TommyPersson/modular-keypads/pcb/module-c/smc-1-r1/production/bom.csv

Designator | Footprint | Quantity | Value | LCSC Part #
C1, C2 | 0603 | 2 | 0.1
C3 | 0603 | 1 | 0.1 uF
J1, J3 | PinHeader_1x06_P2.54mm_Vertical | 2 | Conn_01x06
LED1, LED2, LED3, LED4, LED5, LED6 | LED_choc_6028R-ROT | 6 | SK6812MINI-E
SW1, SW2, SW3, SW4, SW5, SW6 | SW_Hotswap_Kailh_Choc_V1_1.00u | 6 | SW_Push
U1 | SOT-353_SC-70-5 | 1 | 74AHCT1G125
U2 | QFN-24-1EP_4x4mm_P0.5mm_EP2.6x2.6mm | 1 | ATtiny1616-M
U3 | DHVQFN-16-1EP_2.5x3.5mm_P0.5mm_EP1x2mm | 1 | 74HC165
