TommyPersson/modular-keypads/pcb/module-c/main-board-r1/module-c1.stl

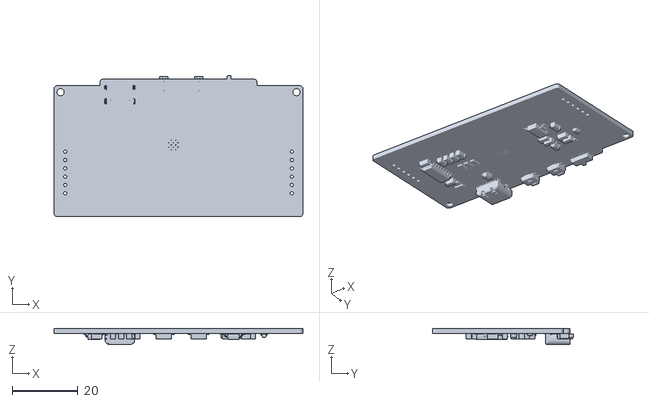
[picture p1: CAD file, 2026-07-26]
pcb/module-c/main-board-r1/module-c1.stl
76.0 x 43.2 x 4.91
