TommyPersson/modular-keypads/scad/module-0/module-0-top.stl

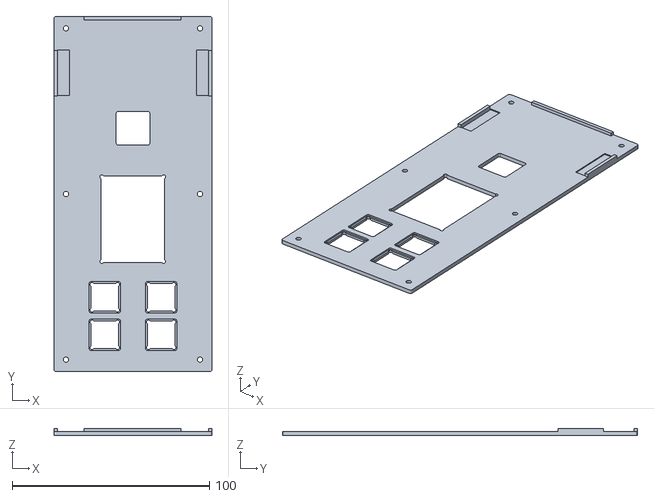
[picture p2: CAD file, 2025-09-28]
scad/module-0/module-0-top.stl
80.0 x 180.0 x 3.60
