TommyPersson/modular-keypads/scad/module-rack/module-rack-2.3mf

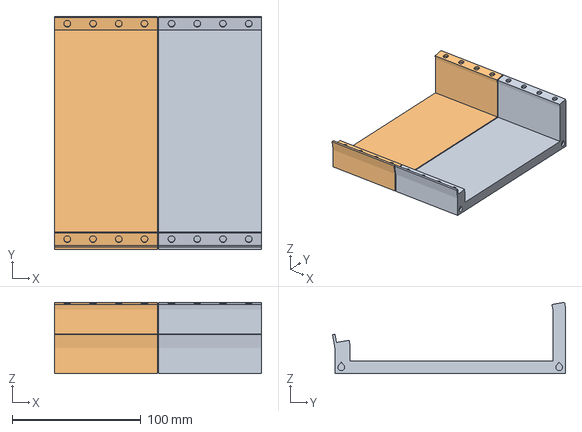
[picture p3: CAD file, 2025-09-14]
scad/module-rack/module-rack-2.3mf
161.0 x 181.1 x 55.5 mm
module-rack-2.scad.stl.bhSaWD.stl x 2
