TommyPersson/modular-keypads/scad/module-0/lcd_spacer.stl

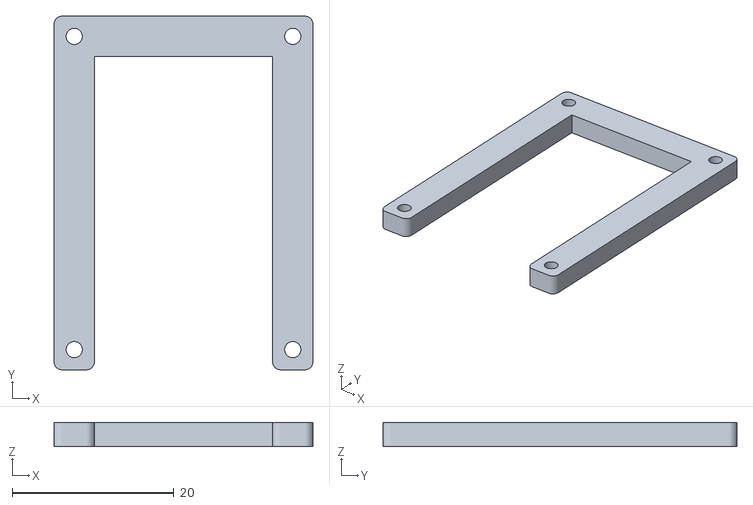
[picture p4: CAD file, 2025-09-28]
scad/module-0/lcd_spacer.stl
32.0 x 43.7 x 3.00
