TommyPersson/modular-keypads/scad/misc/encoders/shared-variables.scad

encoder_cover_diameter = 37;
encoder_cover_height = 2;
encoder_cover_inset = 2;
