TommyPersson/modular-keypads/scad/module-0/_variables.scad

lcd_safety = 0.5;
lcd_size = [32, 43.7];
