TommyPersson/modular-keypads/scad/module-c/module-c-bottom.scad

use <../common/module-bottom-routines.scad>
use <../common/shared-utils.scad>
include <./shared-variables.scad>

base();

module base() {
    module_bottom_base(4);
}
