TommyPersson/modular-keypads/scad/module-c/shared-variables.scad

include <../common/shared-variables.scad>

screw_hole_inset_pcb = 2;
screw_hole_inset = screw_hole_inset_pcb + outer_wall_thickness_base;
