TommyPersson/modular-keypads/(list of files, cad)

Other CAD files:
scad/misc/module-top-standin.scad
scad/module-0/module-0-bottom.scad
scad/module-a/module-a-top.scad
scad/module-b/module-b-bottom.scad
scad/module-c/module-c-mockups.scad
scad/module-rack/module-rack.scad
scad/pipe-mount-rack/pipe-module-rack.scad
