TommyPersson/modular-keypads/pcb/module-c/main-board-r2/module-c2.kicad_pcb

## KiCad design pcb/module-c/main-board-r2/module-c2.kicad_pcb (2026-11-07)

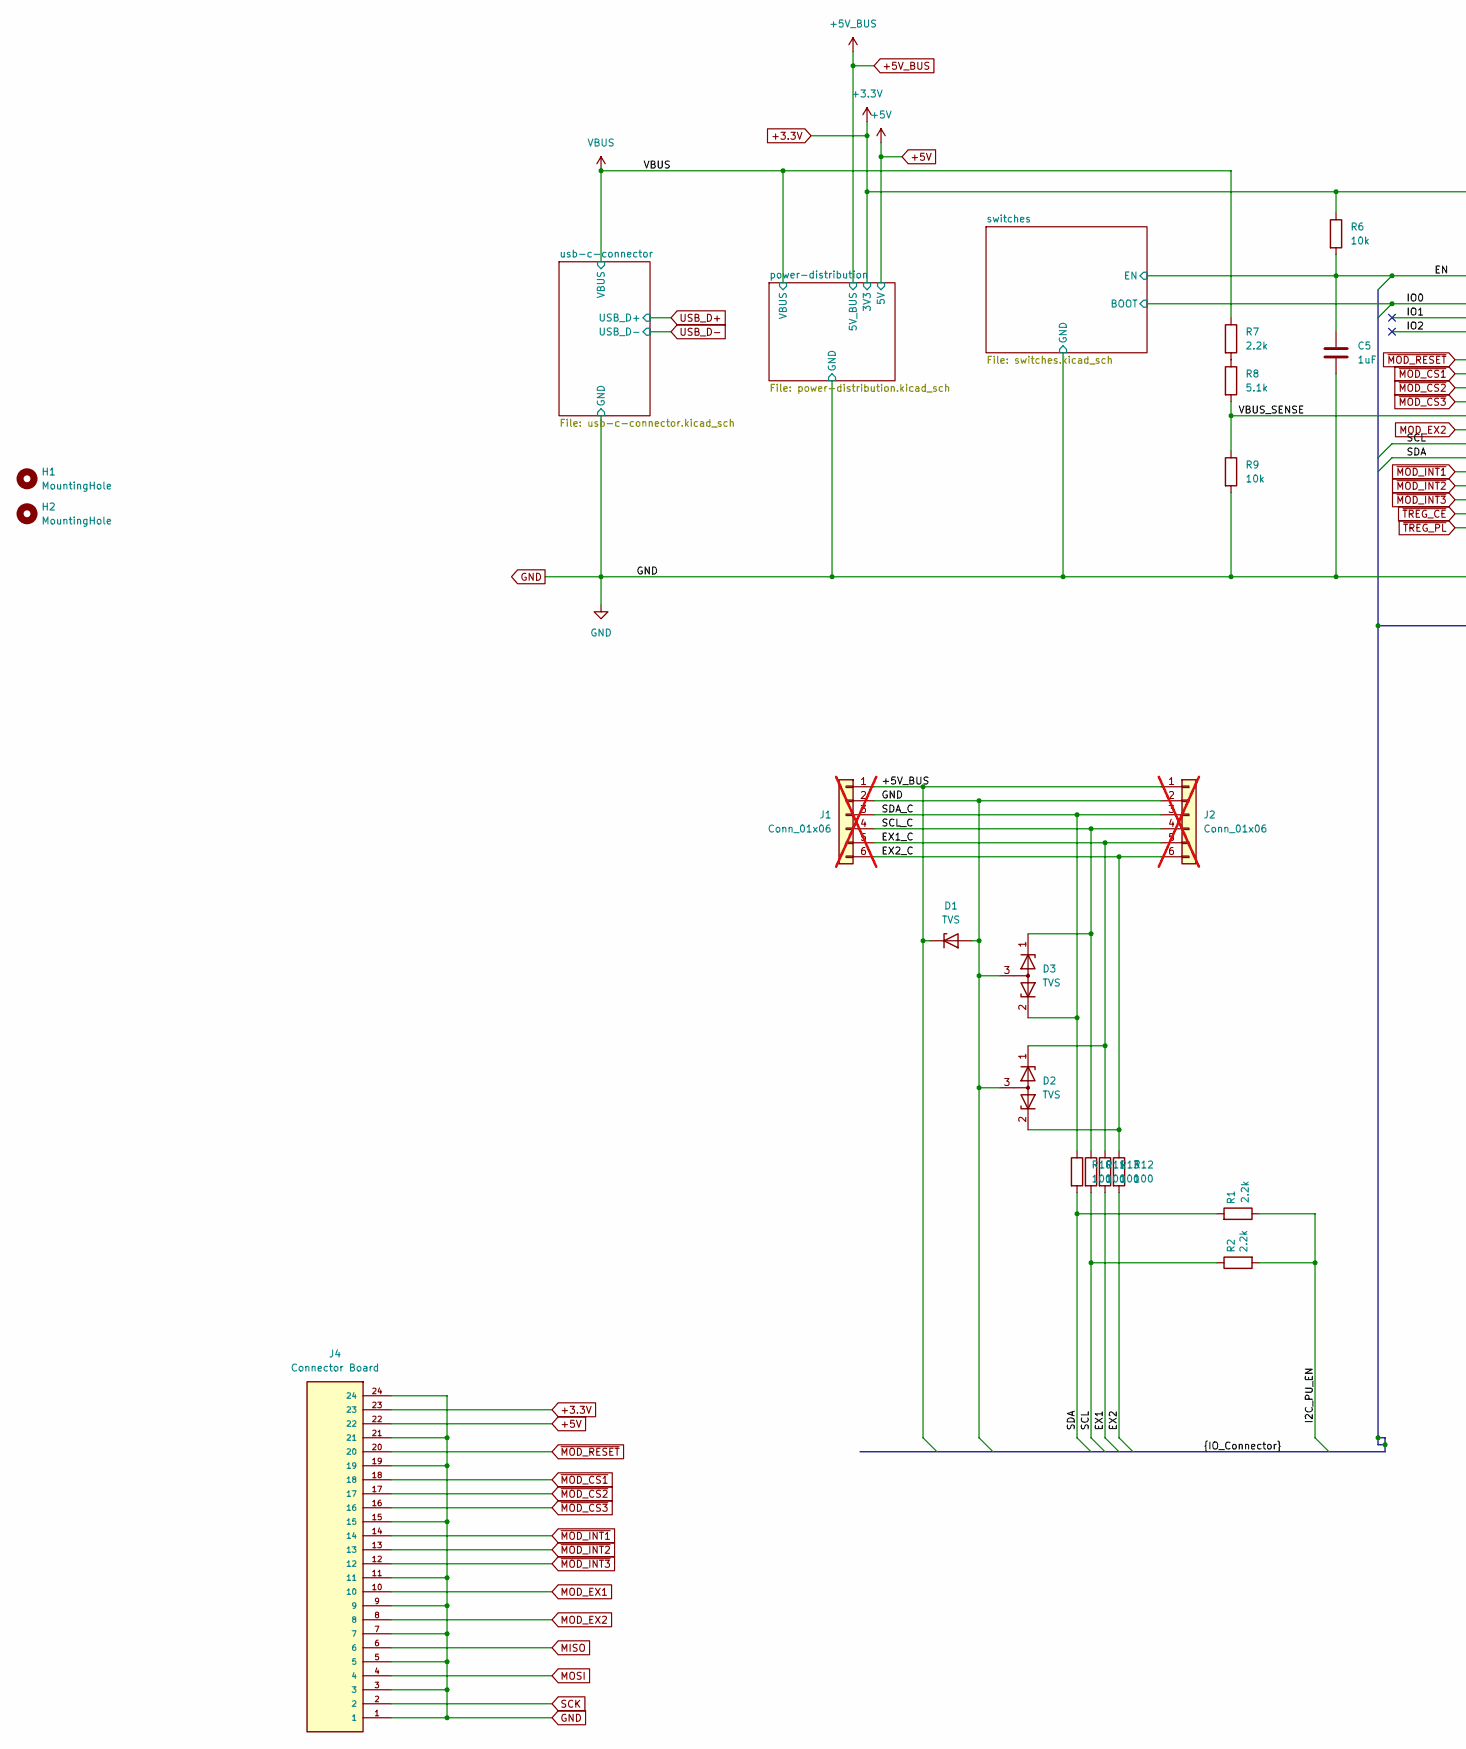
[picture p5: schematic module-c2.kicad_sch, part in row 1, column 1]

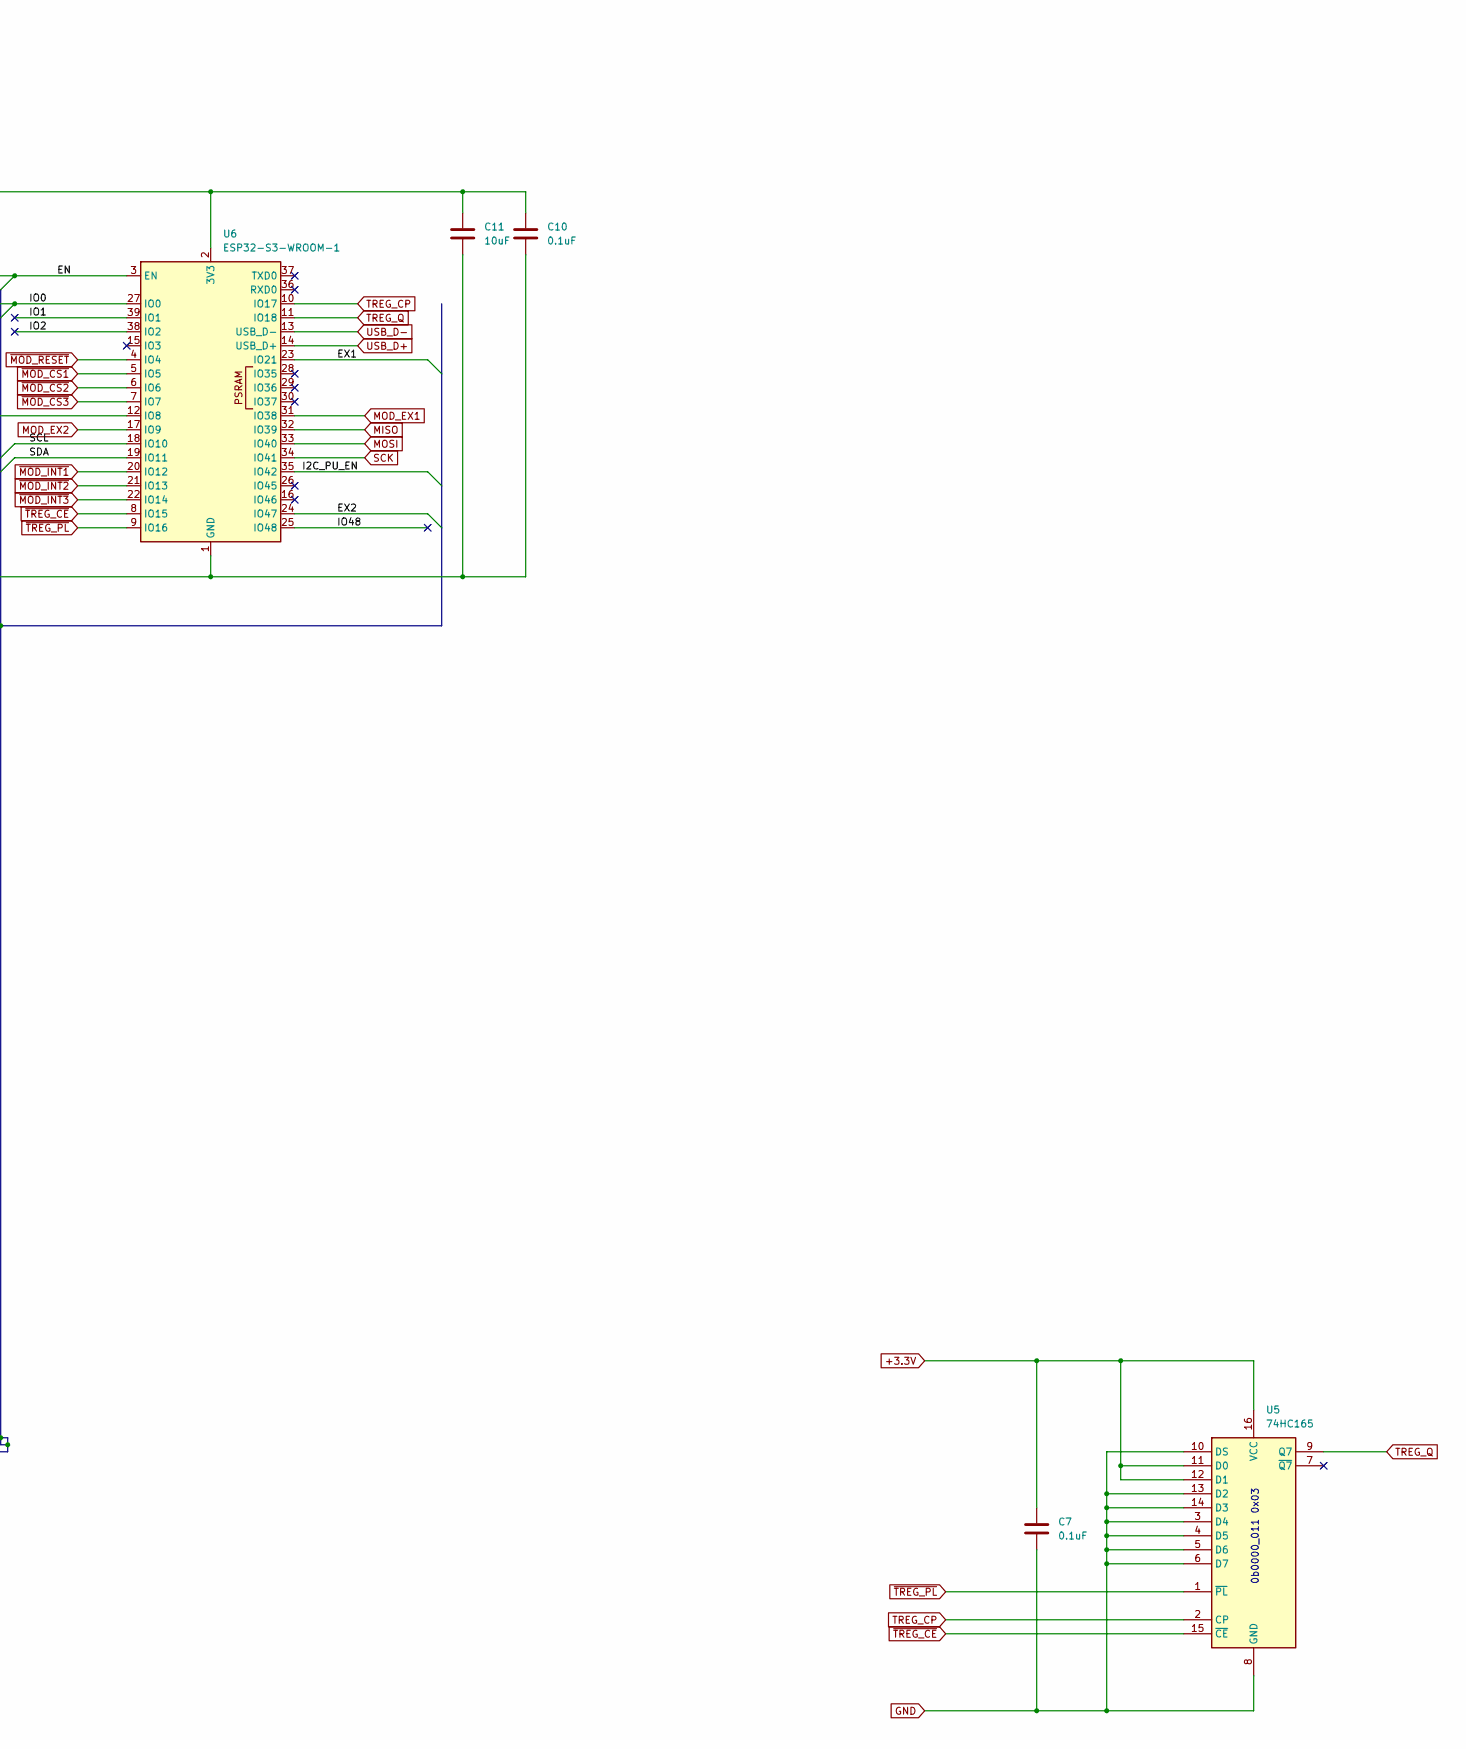
[picture p6: schematic module-c2.kicad_sch, part in row 1, column 2]

Parts:
C5: 1uF; C_0805_2012Metric
C7, C10: 0.1uF; C_0603_1608Metric
C11: 10uF; C_0805_2012Metric
D1: TVS; Nexperia_CFP3_SOD-123W
D2, D3: TVS; SOT-723
H1, H2: MountingHole; MountingHole_2.2mm_M2
J1: Conn_01x06; PinSocket_1x06_P2.54mm_MagPogoHor_R; not fitted
J2: Conn_01x06; PinSocket_1x06_P2.54mm_MagPogoHor; not fitted
J4: Connector Board; AMPHENOL_F3311A7H121024E200; PARTREV A
R1, R2, R7: 2.2k; R_0603_1608Metric
R6, R9: 10k; R_0603_1608Metric
R8: 5.1k; R_0603_1608Metric
R10, R11, R12, R13: 100; R_0603_1608Metric
U5: 74HC165; DHVQFN-16-1EP_2.5x3.5mm_P0.5mm_EP1x2mm
U6: ESP32-S3-WROOM-1; ESP32-S3-WROOM-1U

Connections:
+3.3V: C7.1, C10.1, C11.1, J4.23, R6.1, U5.11 (D0), U5.12 (D1), U5.16 (VCC), U6.2 (3V3); also elsewhere on the board
+5V: J4.22; also elsewhere on the board
+5V_BUS: D1.1 (K), J1.1, J2.1; also elsewhere on the board
/EN: C5.1, R6.2, U6.3 (EN); also elsewhere on the board
/EX1: R13.2, U6.23 (IO21)
/EX1_C: D2.1 (K), J1.5, J2.5, R13.1
/EX2: R12.2, U6.24 (IO47)
/EX2_C: D2.2 (K), J1.6, J2.6, R12.1
/I2C_PU_EN: R1.1, R2.2, U6.35 (IO42)
/IO0: U6.27 (IO0); also elsewhere on the board
/IO1: U6.39 (IO1)
/IO2: U6.38 (IO2)
/IO48: U6.25 (IO48)
/SCL: R2.1, R11.2, U6.18 (IO10)
/SCL_C: D3.1 (K), J1.4, J2.4, R11.1
/SDA: R1.2, R10.2, U6.19 (IO11)
/SDA_C: D3.2 (K), J1.3, J2.3, R10.1
/VBUS_SENSE: R8.2, R9.1, U6.12 (IO8)
GND: C5.2, C7.2, C10.2, C11.2, D1.2 (A), D2.3 (A), D3.3 (A), J1.2, J2.2, J4.1, J4.3, J4.5, J4.7, J4.9, J4.11, J4.15, J4.19, J4.21, J4.24, R9.2, U5.3 (D4), U5.4 (D5), U5.5 (D6), U5.6 (D7), U5.8 (GND), U5.10 (DS), U5.13 (D2), U5.14 (D3), U6.1 (GND), U6.40 (GND), U6.41 (GND); also elsewhere on the board
MISO: J4.6, U6.32 (IO39)
MOD_EX1: J4.10, U6.31 (IO38)
MOD_EX2: J4.8, U6.17 (IO9)
MOSI: J4.4, U6.33 (IO40)
unnamed: R7.2, R8.1
SCK: J4.2, U6.34 (IO41)
TREG_CP: U5.2 (CP), U6.10 (IO17)
TREG_Q: U5.9 (Q7), U6.11 (IO18)
USB_D+: U6.14 (USB_D+); also elsewhere on the board
USB_D-: U6.13 (USB_D-); also elsewhere on the board
VBUS: R7.1; also elsewhere on the board
~MOD_CS1: J4.18, U6.5 (IO5)
~MOD_CS2: J4.17, U6.6 (IO6)
~MOD_CS3: J4.16, U6.7 (IO7)
~MOD_INT1: J4.14, U6.20 (IO12)
~MOD_INT2: J4.13, U6.21 (IO13)
~MOD_INT3: J4.12, U6.22 (IO14)
~MOD_RESET: J4.20, U6.4 (IO4)
~TREG_CE: U5.15 (~CE), U6.8 (IO15)
~TREG_PL: U5.1 (~PL), U6.9 (IO16)

Notes on the sheet:
0b0000_011 0x03

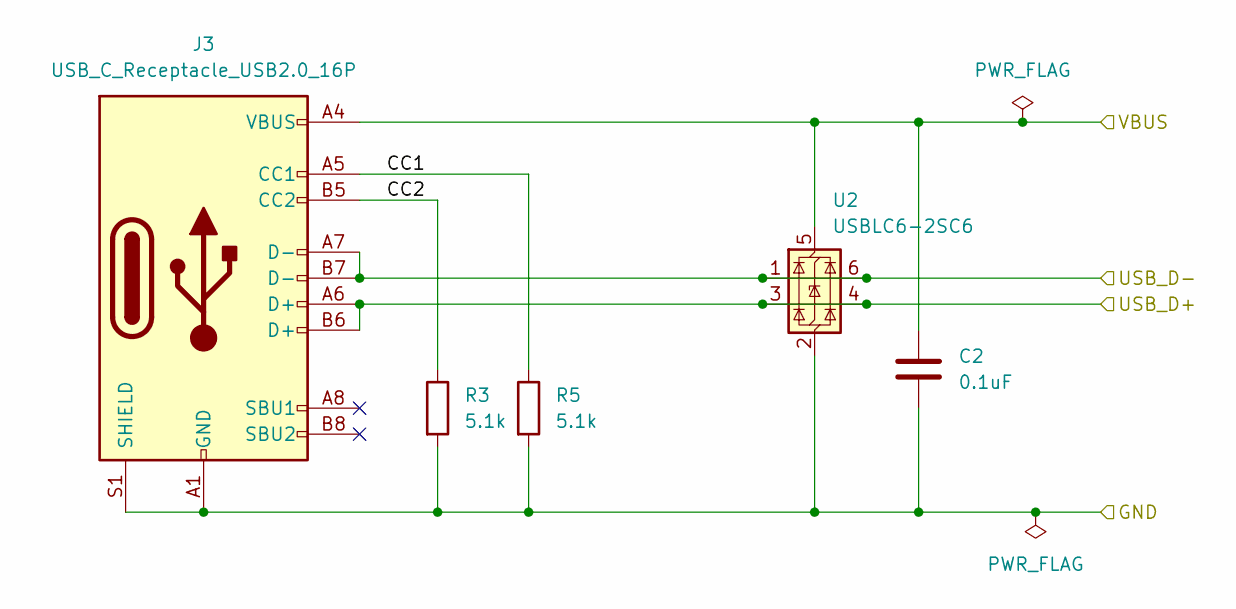
[picture p7: schematic usb-c-connector.kicad_sch]

Parts:
C2: 0.1uF; C_0603_1608Metric
J3: USB_C_Receptacle_USB2.0_16P; USB_C_Receptacle_GCT_USB4105-xx-A_16P_TopMnt_Horizontal
R3, R5: 5.1k; R_0603_1608Metric
U2: USBLC6-2SC6; SOT-23-6_Handsoldering

Connections:
/usb-c-connector/CC1: J3.A5 (CC1), R5.1
/usb-c-connector/CC2: J3.B5 (CC2), R3.1
GND: C2.2, J3.A1 (GND), J3.A12 (GND), J3.B1 (GND), J3.B12 (GND), J3.S1 (SHIELD), R3.2, R5.2, U2.2 (GND); also elsewhere on the board
USB_D+: J3.A6 (D+), J3.B6 (D+), U2.3 (I/O2), U2.4 (I/O2); also elsewhere on the board
USB_D-: J3.A7 (D-), J3.B7 (D-), U2.1 (I/O1), U2.6 (I/O1); also elsewhere on the board
VBUS: C2.1, J3.A4 (VBUS), J3.A9 (VBUS), J3.B4 (VBUS), J3.B9 (VBUS), U2.5 (VBUS); also elsewhere on the board

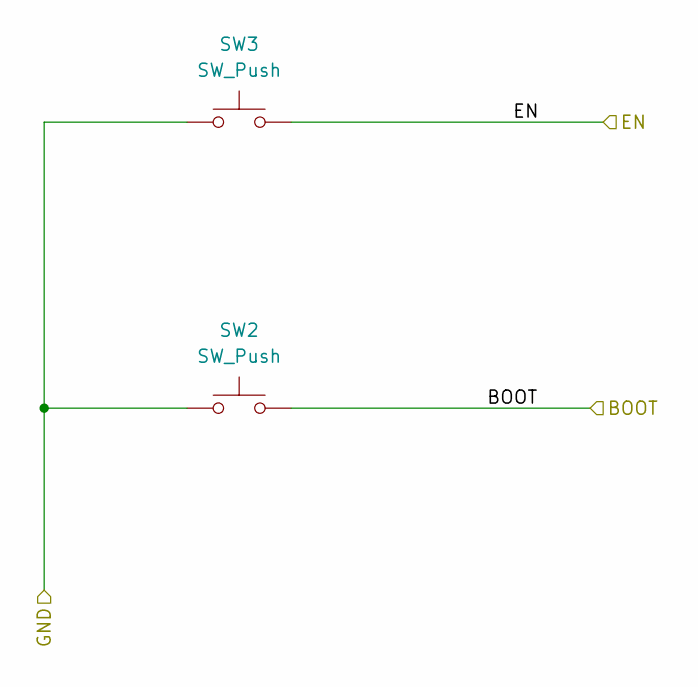
[picture p8: schematic switches.kicad_sch]

Parts:
SW2, SW3: SW_Push; Panasonic_EVQPUL_EVQPUC

Connections:
/EN: SW3.2; also elsewhere on the board
/IO0: SW2.2; also elsewhere on the board
GND: SW2.1, SW3.1; also elsewhere on the board

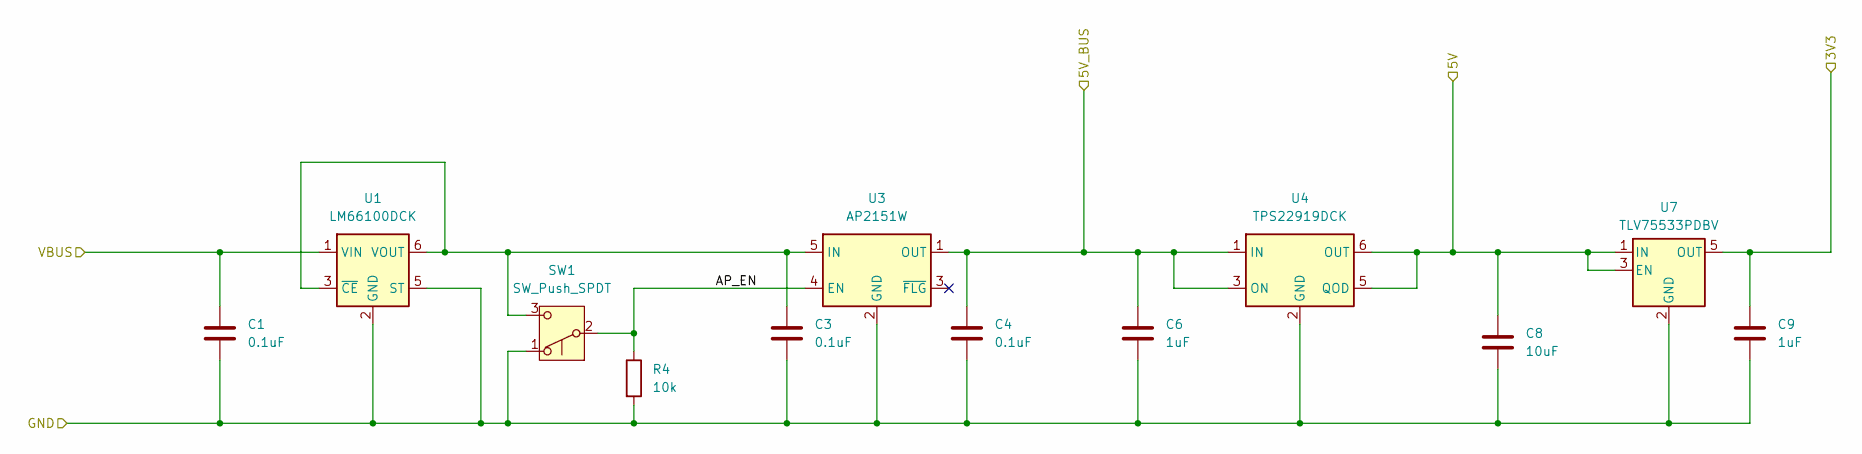
[picture p9: schematic power-distribution.kicad_sch]

Parts:
C1, C3, C4: 0.1uF; C_0603_1608Metric
C6, C9: 1uF; C_0805_2012Metric
C8: 10uF; C_0805_2012Metric
R4: 10k; R_0603_1608Metric
SW1: SW_Push_SPDT; SW_MSK12C02-HB
U1: LM66100DCK; SOT-363_SC-70-6
U3: AP2151W; SOT-23-5_HandSoldering
U4: TPS22919DCK; SOT-363_SC-70-6
U7: TLV75533PDBV; SOT-23-5

Connections:
+3.3V: C9.1, U7.5 (OUT); also elsewhere on the board
+5V: C8.1, U4.5 (QOD), U4.6 (OUT), U7.1 (IN), U7.3 (EN); also elsewhere on the board
+5V_BUS: C4.1, C6.1, U3.1 (OUT), U4.1 (IN), U4.3 (ON); also elsewhere on the board
/power-distribution/AP_EN: R4.1, SW1.2 (B), U3.4 (EN)
GND: C1.2, C3.2, C4.2, C6.2, C8.2, C9.2, R4.2, SW1.1 (A), U1.2 (GND), U1.5 (ST), U3.2 (GND), U4.2 (GND), U7.2 (GND); also elsewhere on the board
unnamed: C3.1, SW1.3 (C), U1.3 (~CE), U1.6 (VOUT), U3.5 (IN)
VBUS: C1.1, U1.1 (VIN); also elsewhere on the board

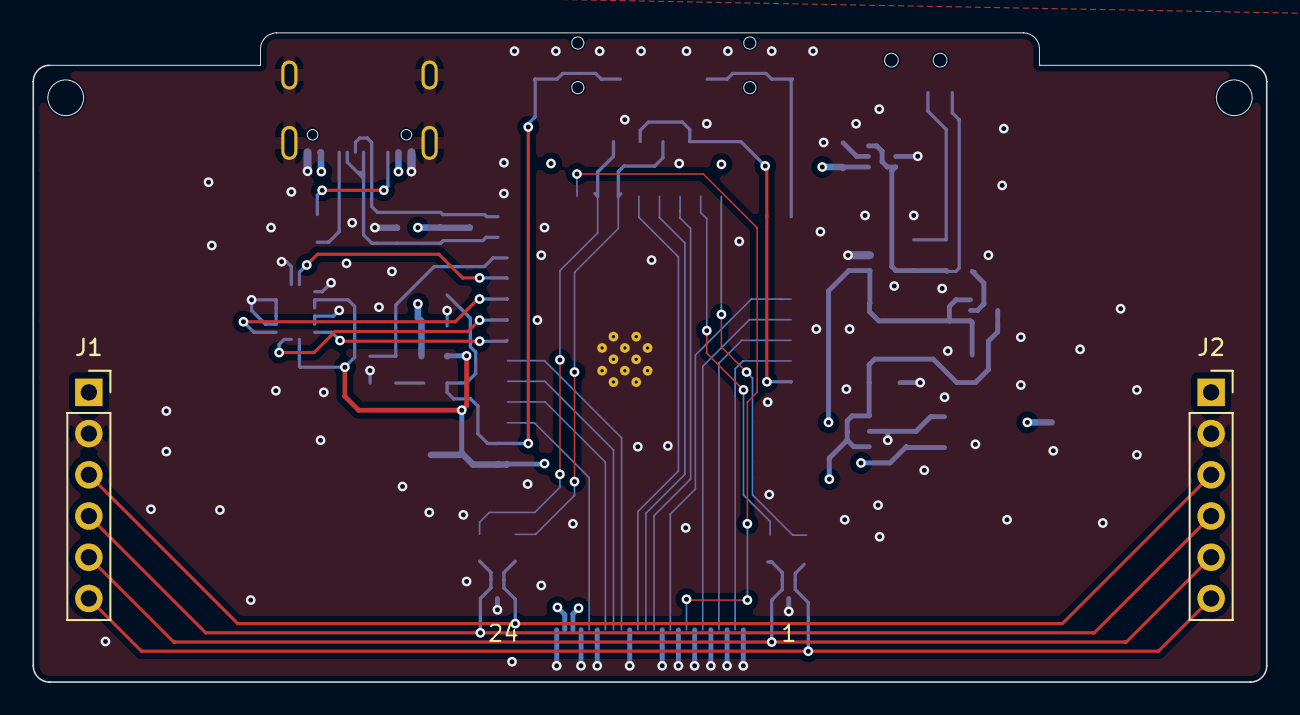
[picture p10: board module-c2.kicad_pcb from above]

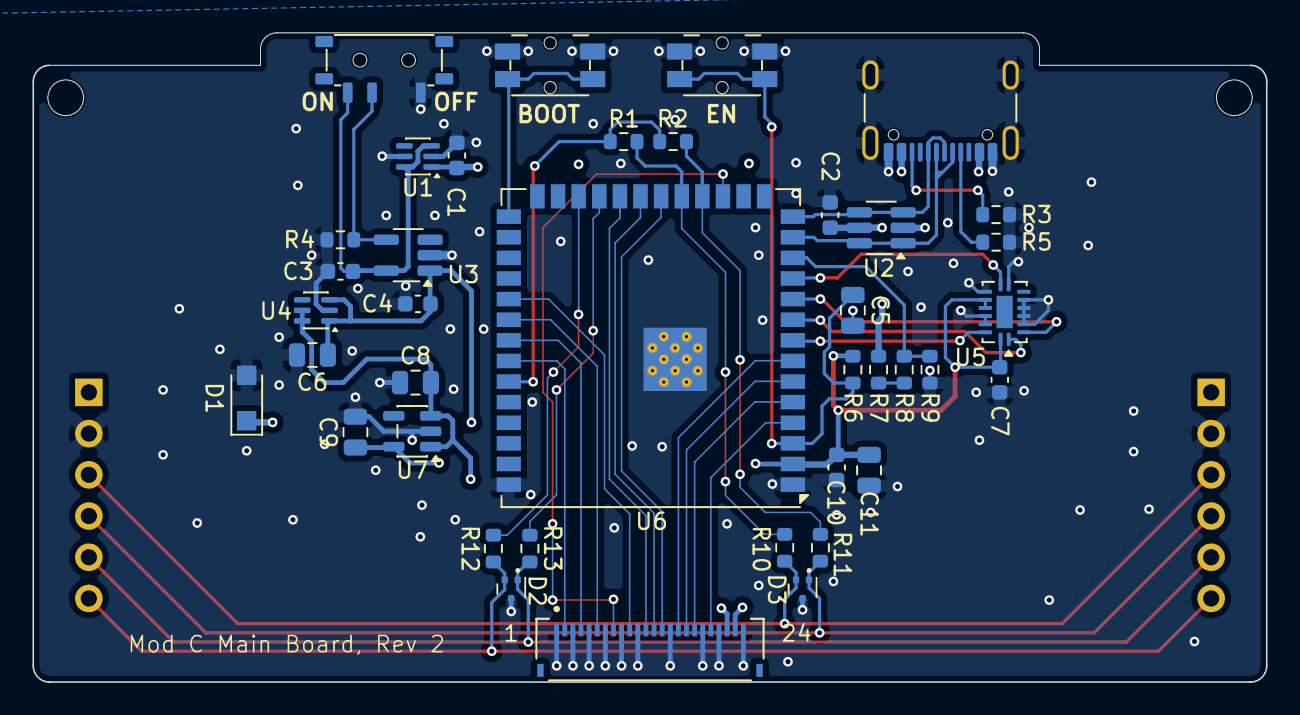
[picture p11: board module-c2.kicad_pcb from below]

Board: 4 copper layers, 76.0 x 40.0 mm, 43 parts (39 on the bottom side), 40 nets.
