TommyPersson/modular-keypads/pcb/module-c/smc-1-r2/smc-1.kicad_pcb

## KiCad design pcb/module-c/smc-1-r2/smc-1.kicad_pcb (2026-09-13)

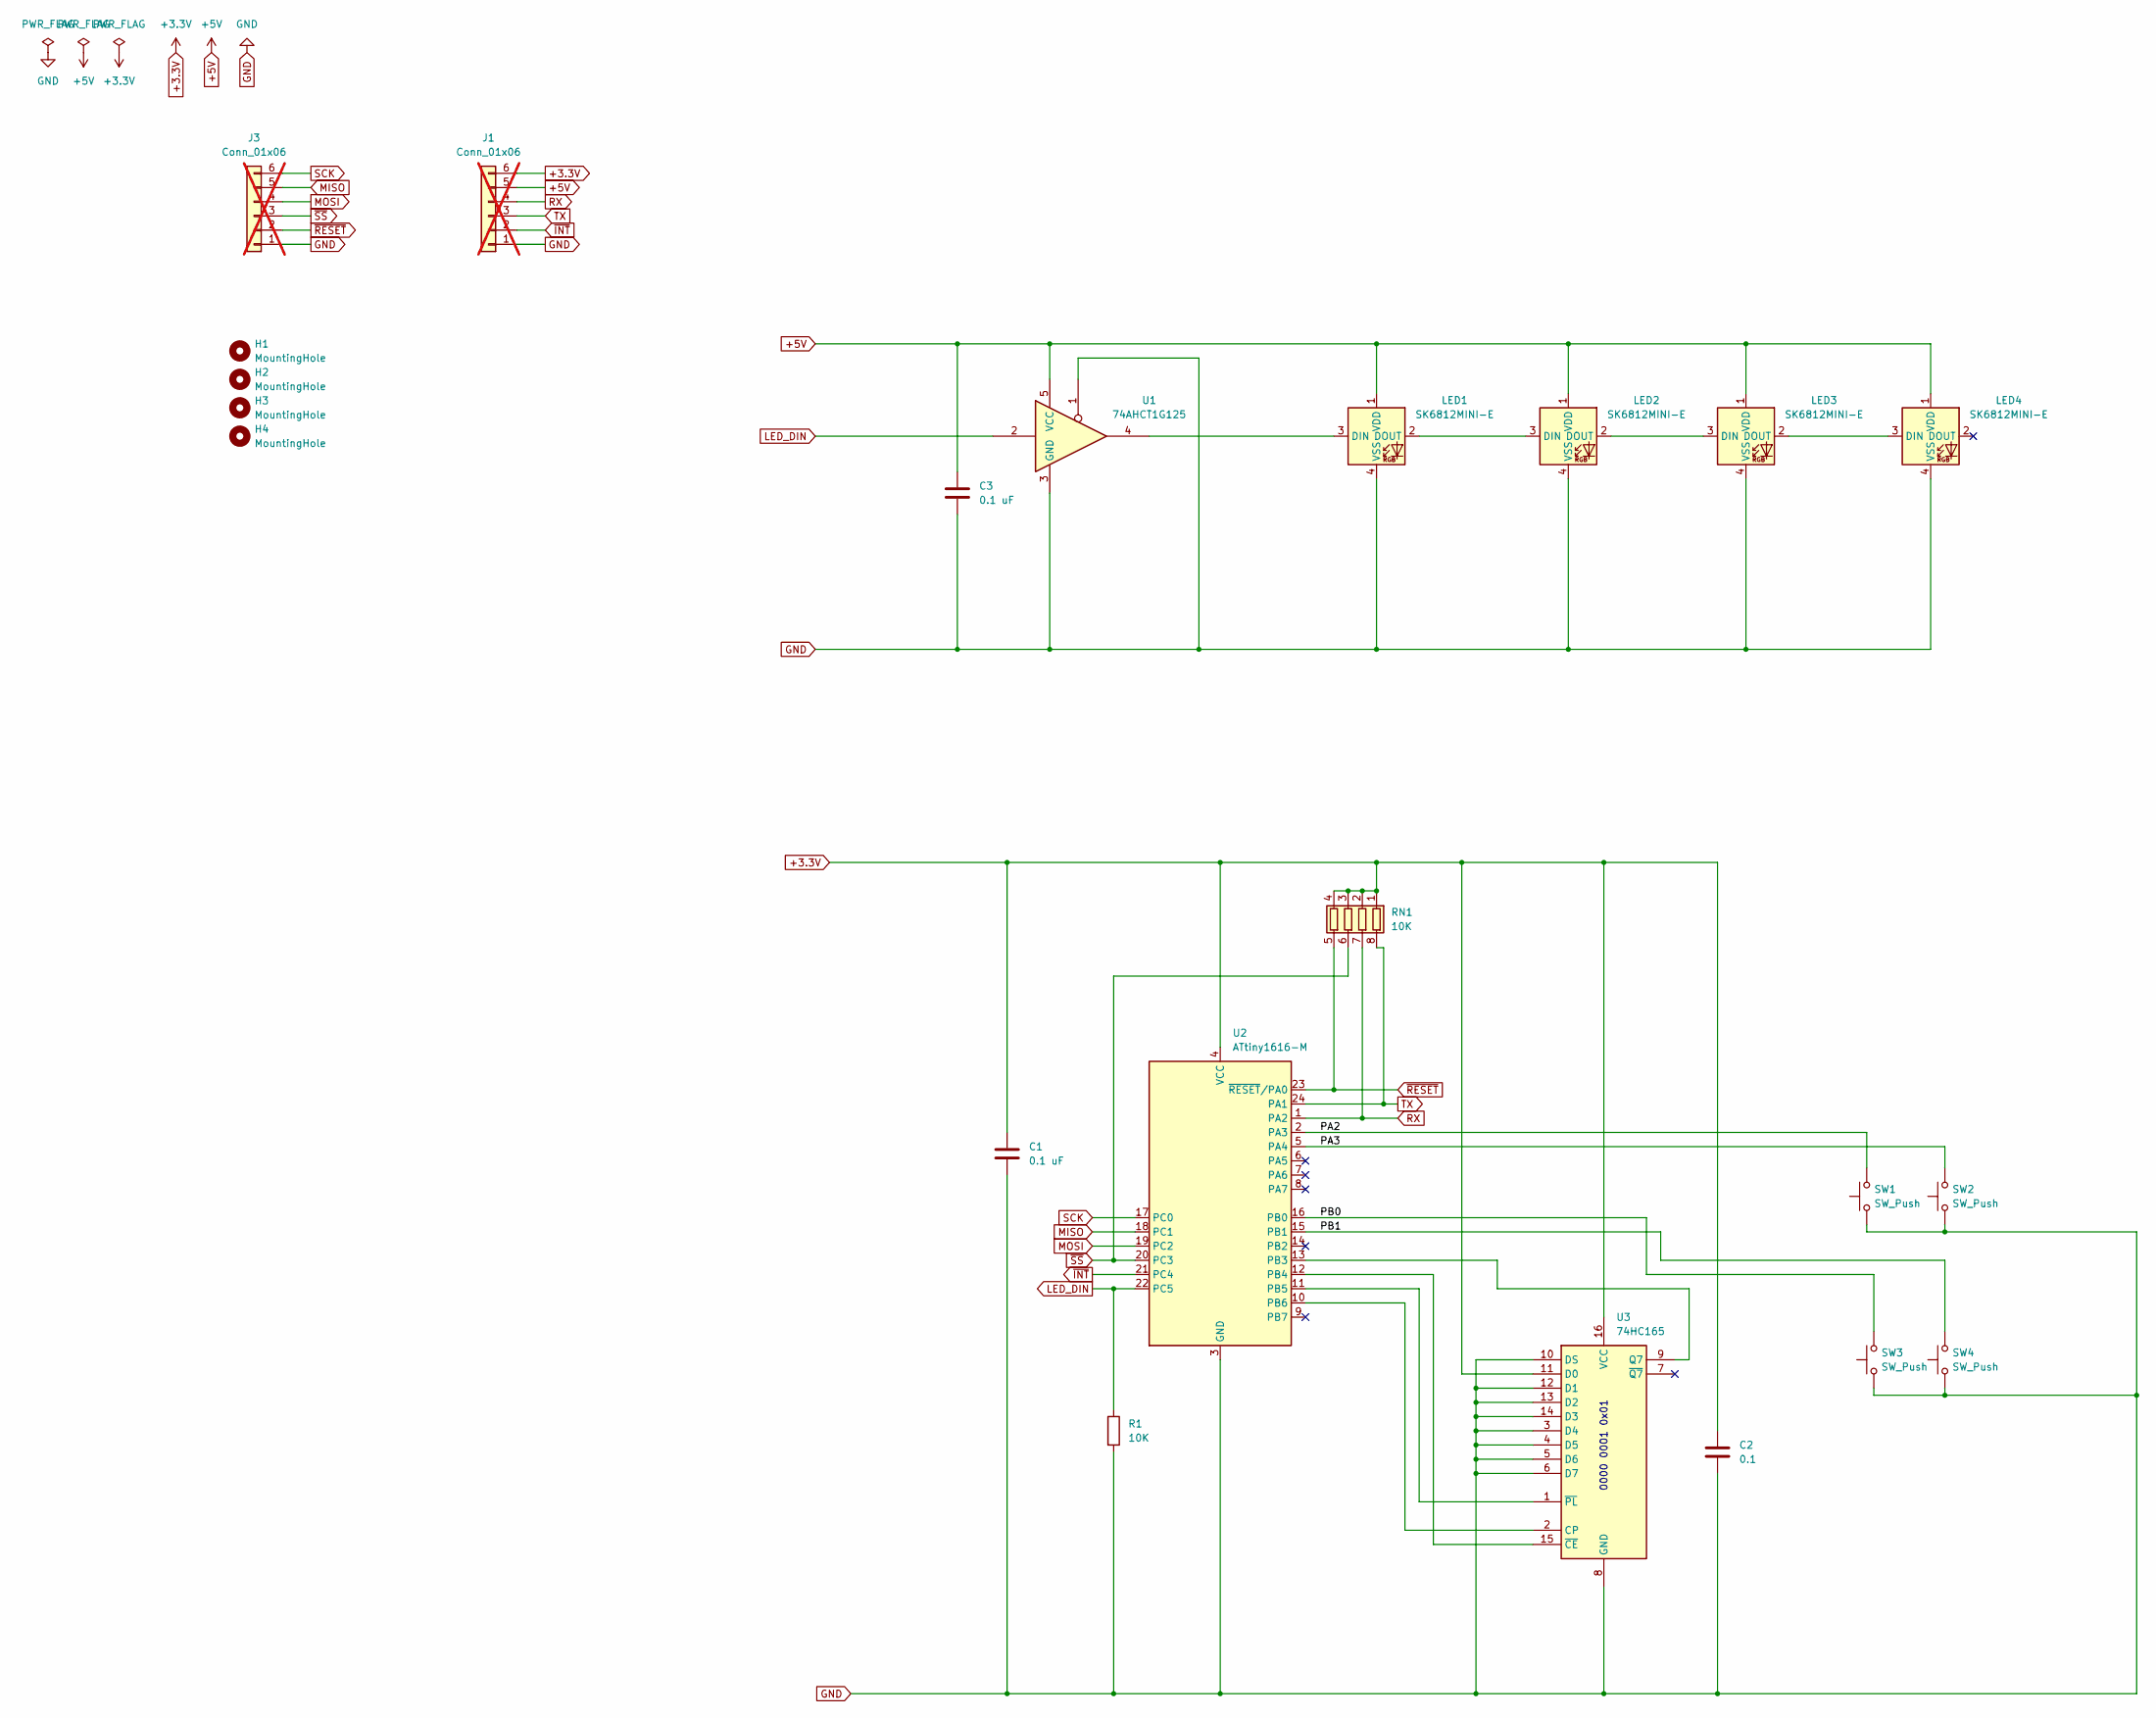
[picture p12: schematic smc-1.kicad_sch]

Parts:
C1, C3: 0.1 uF; C_0603_1608Metric
C2: 0.1; C_0603_1608Metric
H1, H2, H3, H4: MountingHole; MountingHole_2.2mm_M2
J1, J3: Conn_01x06; PinHeader_1x06_P2.54mm_Vertical; not fitted
LED1, LED2, LED3, LED4: SK6812MINI-E; LED_choc_6028R-ROT
R1: 10K; R_0603_1608Metric
RN1: 10K; R_Array_Concave_4x0603
SW1, SW2, SW3, SW4: SW_Push; SW_Hotswap_Kailh_Choc_V1_1.50u
U1: 74AHCT1G125; SOT-353_SC-70-5
U2: ATtiny1616-M; QFN-24-1EP_4x4mm_P0.5mm_EP2.6x2.6mm
U3: 74HC165; DHVQFN-16-1EP_2.5x3.5mm_P0.5mm_EP1x2mm

Connections:
+3.3V: C1.1, C2.1, J1.6, RN1.1 (R1.1), RN1.2 (R2.1), RN1.3 (R3.1), RN1.4 (R4.1), U2.4 (VCC), U3.11 (D0), U3.16 (VCC)
+5V: C3.1, J1.5, LED1.1 (VDD), LED2.1 (VDD), LED3.1 (VDD), LED4.1 (VDD), U1.5 (VCC)
/PA2: SW1.2, U2.2 (PA3)
/PA3: SW2.2, U2.5 (PA4)
/PB0: SW3.2, U2.16 (PB0)
/PB1: SW4.2, U2.15 (PB1)
GND: C1.2, C2.2, C3.2, J1.1, J3.1, LED1.4 (VSS), LED2.4 (VSS), LED3.4 (VSS), LED4.4 (VSS), R1.2, SW1.1, SW2.1, SW3.1, SW4.1, U1.1, U1.3 (GND), U2.3 (GND), U2.25 (GND), U3.3 (D4), U3.4 (D5), U3.5 (D6), U3.6 (D7), U3.8 (GND), U3.10 (DS), U3.12 (D1), U3.13 (D2), U3.14 (D3)
LED_DIN: R1.1, U1.2, U2.22 (PC5)
MISO: J3.5, U2.18 (PC1)
MOSI: J3.4, U2.19 (PC2)
unnamed: LED1.3 (DIN), U1.4
unnamed: LED1.2 (DOUT), LED2.3 (DIN)
unnamed: LED2.2 (DOUT), LED3.3 (DIN)
unnamed: LED3.2 (DOUT), LED4.3 (DIN)
unnamed: U2.13 (PB3), U3.9 (Q7)
unnamed: U2.12 (PB4), U3.15 (~CE)
unnamed: U2.11 (PB5), U3.1 (~PL)
unnamed: U2.10 (PB6), U3.2 (CP)
RX: J1.4, RN1.7 (R2.2), U2.1 (PA2)
SCK: J3.6, U2.17 (PC0)
TX: J1.3, RN1.8 (R1.2), U2.24 (PA1)
~INT: J1.2, U2.21 (PC4)
~RESET: J3.2, RN1.5 (R4.2), U2.23 (~RESET/PA0)
~SS: J3.3, RN1.6 (R3.2), U2.20 (PC3)

Notes on the sheet:
0000 0001 0x01

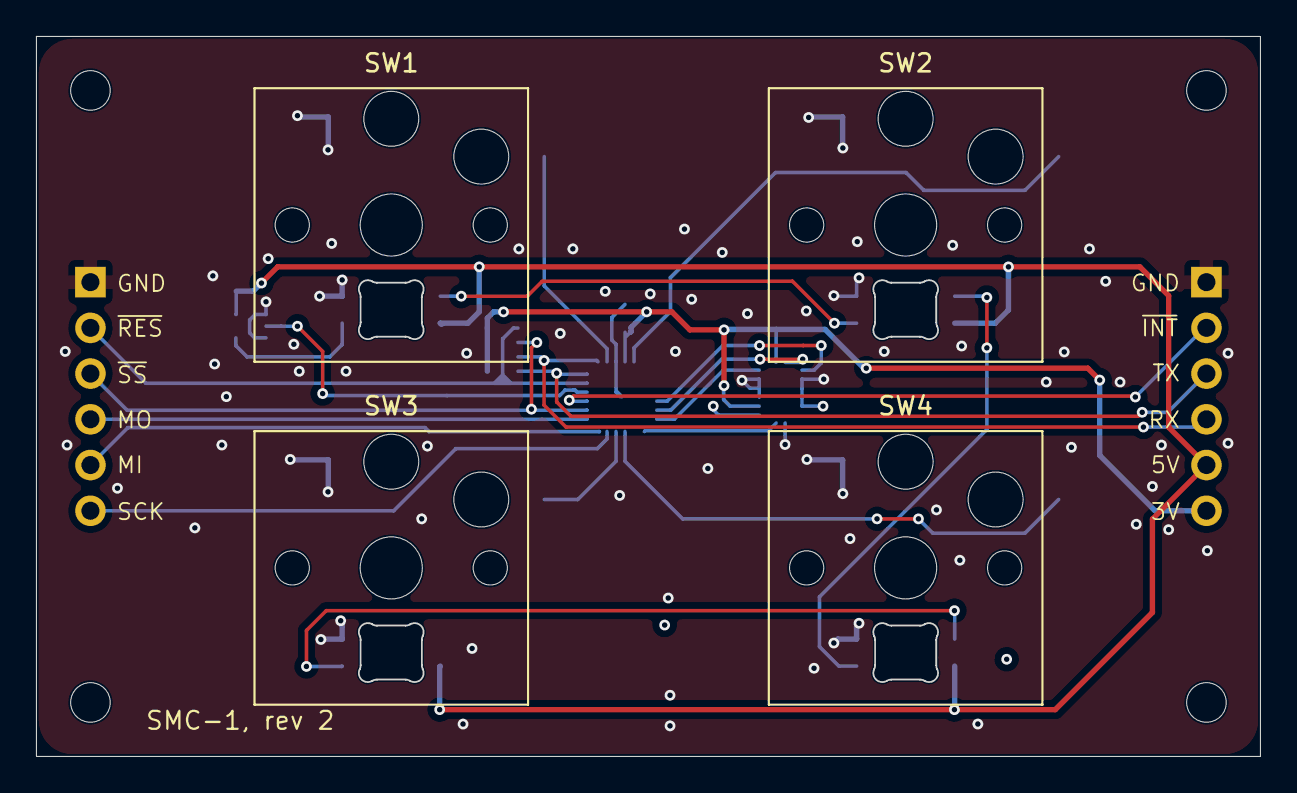
[picture p13: board smc-1.kicad_pcb from above]

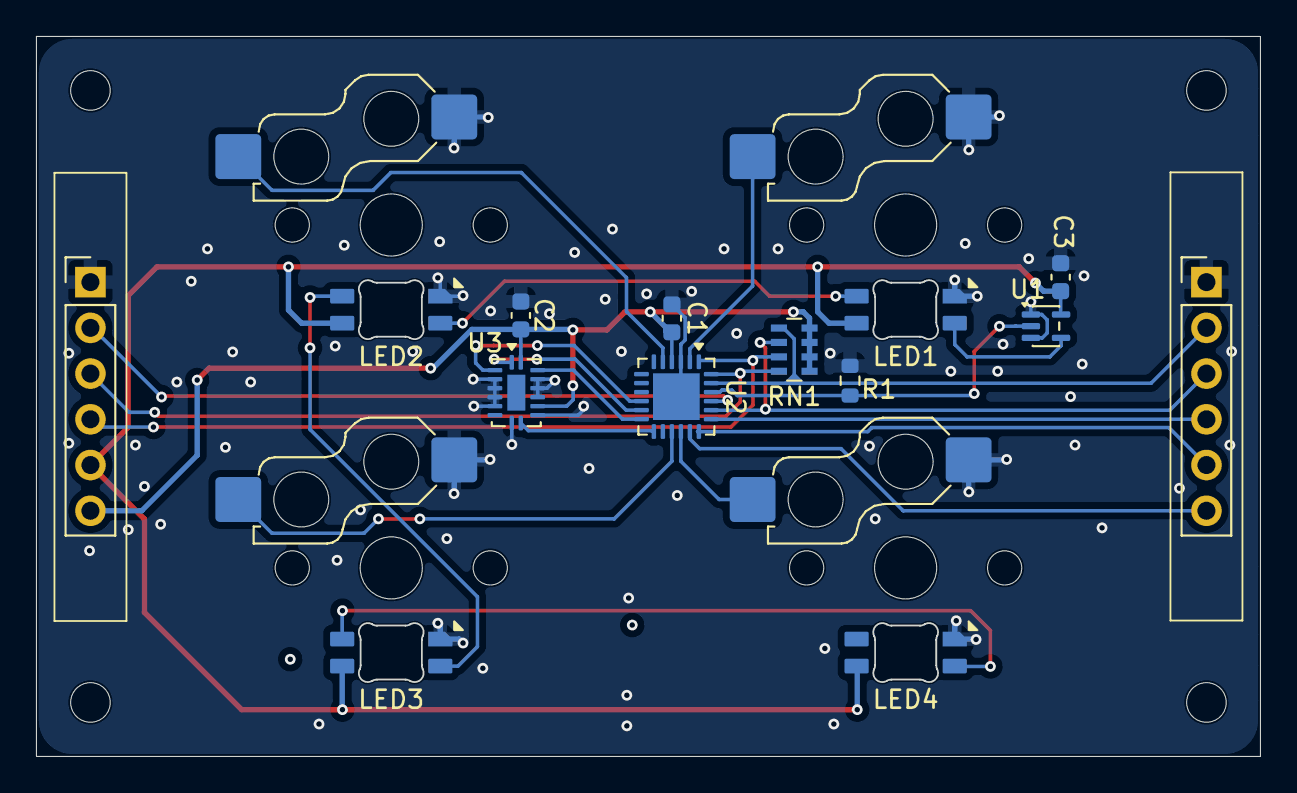
[picture p14: board smc-1.kicad_pcb from below]

Board: 4 copper layers, 68.0 x 40.0 mm, 22 parts (14 on the bottom side), 24 nets.
