TommyPersson/modular-keypads/pcb/module-c/sub-module-programmer-r3/sub-module-programmer.kicad_pcb

## KiCad design pcb/module-c/sub-module-programmer-r3/sub-module-programmer.kicad_pcb (2026-09-06)

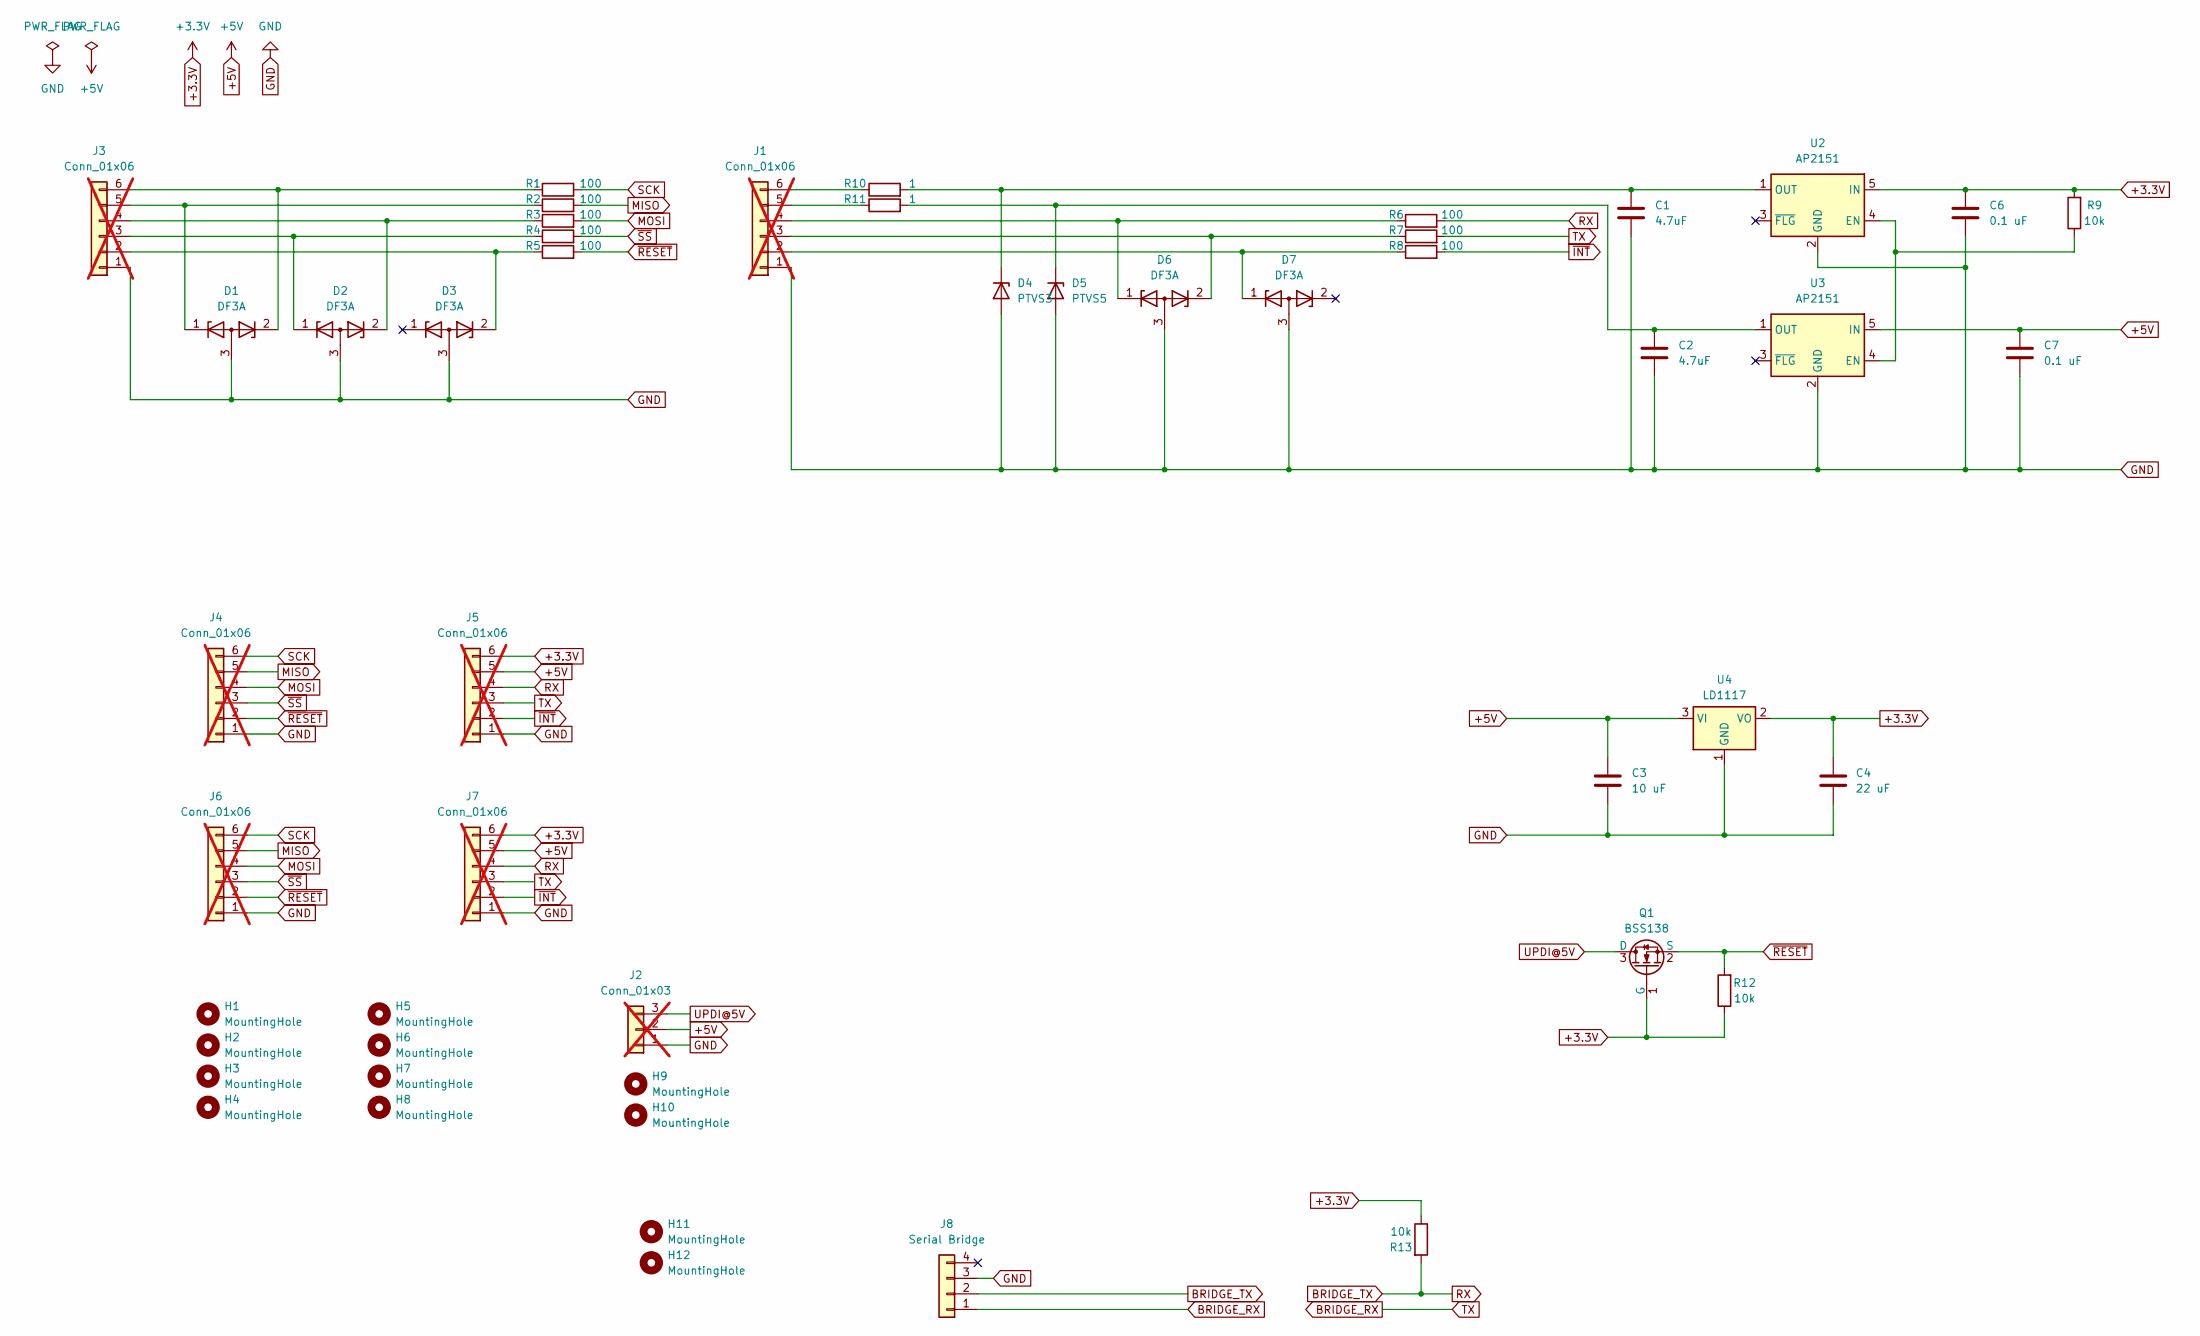
[picture p15: schematic sub-module-programmer.kicad_sch]

Parts:
C1, C2: 4.7uF; C_0805_2012Metric
C3: 10 uF; C_1206_3216Metric
C4: 22 uF; C_1206_3216Metric
C6, C7: 0.1 uF; C_0603_1608Metric
D1, D2, D3, D6, D7: DF3A; SOT-723
D4: PTVS3; Nexperia_CFP3_SOD-123W
D5: PTVS5; Nexperia_CFP3_SOD-123W
H1, H2, H3, H4, H5, H6, H7, H8, H9, H10, H11, H12: MountingHole; MountingHole_2.2mm_M2
J1, J3, J4, J5, J6, J7: Conn_01x06; PinHeader_1x06_P2.54mm_Vertical; not fitted
J2: Conn_01x03; PinHeader_1x03_P2.54mm_Vertical; not fitted
J8: Serial Bridge; PinHeader_1x04_P2.54mm_Vertical
Q1: BSS138; SOT-23
R1, R2, R3, R4, R5, R6, R7, R8: 100; R_0603_1608Metric
R9, R12, R13: 10k; R_0603_1608Metric
R10, R11: 1; R_0805_2012Metric
U2, U3: AP2151; SOT-23-5
U4: LD1117; SOT-223-3_TabPin2

Connections:
+3.3V: C4.1, C6.1, J5.6, J7.6, Q1.1 (G), R9.2, R12.1, R13.1, U2.5 (IN), U4.2 (VO)
+5V: C3.1, C7.1, J2.2, J5.5, J7.5, U3.5 (IN), U4.3 (VI)
BRIDGE_RX: J5.3, J7.3, J8.1, R7.2
BRIDGE_TX: J5.4, J7.4, J8.2, R6.2, R13.2
GND: C1.2, C2.2, C3.2, C4.2, C6.2, C7.2, D1.3 (A), D2.3 (A), D3.3 (A), D4.2 (A), D5.2 (A), D6.3 (A), D7.3 (A), J1.1, J2.1, J3.1, J4.1, J5.1, J6.1, J7.1, J8.3, U2.2 (GND), U3.2 (GND), U4.1 (GND)
MISO: J4.5, J6.5, R2.2
MOSI: J4.4, J6.4, R3.2
unnamed: C1.1, D4.1 (K), R10.2, U2.1 (OUT)
unnamed: C2.1, D5.1 (K), R11.2, U3.1 (OUT)
unnamed: D7.1 (K), J1.2, R8.1
unnamed: D6.2 (K), J1.3, R7.1
unnamed: D6.1 (K), J1.4, R6.1
unnamed: J1.5, R11.1
unnamed: J1.6, R10.1
unnamed: D3.2 (K), J3.2, R5.1
unnamed: D2.1 (K), J3.3, R4.1
unnamed: D2.2 (K), J3.4, R3.1
unnamed: D1.1 (K), J3.5, R2.1
unnamed: D1.2 (K), J3.6, R1.1
unnamed: R9.1, U2.4 (EN), U3.4 (EN)
SCK: J4.6, J6.6, R1.2
UPDI@5V: J2.3, Q1.3 (D)
~INT: J5.2, J7.2, R8.2
~RESET: J4.2, J6.2, Q1.2 (S), R5.2, R12.2
~SS: J4.3, J6.3, R4.2
