TommyPersson/modular-keypads/pcb/module-c/sub-module-programmer-r3/sub-module-programmer.kicad_pcb

## KiCad design pcb/module-c/sub-module-programmer-r3/sub-module-programmer.kicad_pcb (continued)

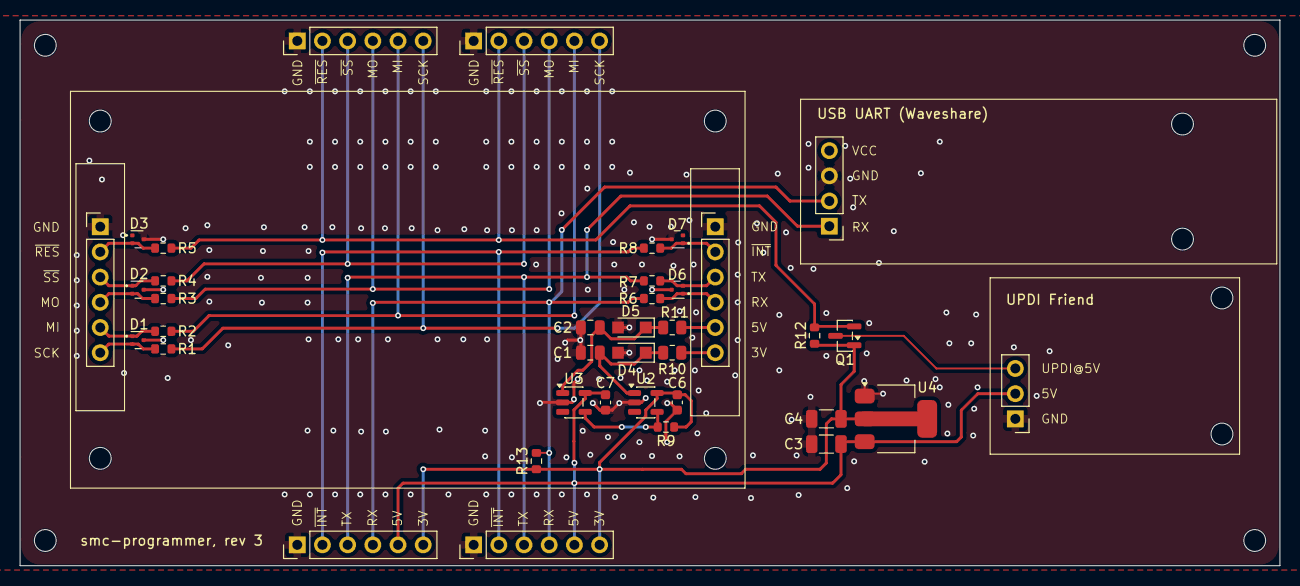
[picture p16: board pcb/module-c/sub-module-programmer-r3/sub-module-programmer.kicad_pcb from above]

Board: 4 copper layers, 127.0 x 55.0 mm, 50 parts (0 on the bottom side), 25 nets.
