TommyPersson/modular-keypads/pcb/module-c/connector-board-r2/connector-board.kicad_pcb

## KiCad design pcb/module-c/connector-board-r2/connector-board.kicad_pcb (2026-08-21)

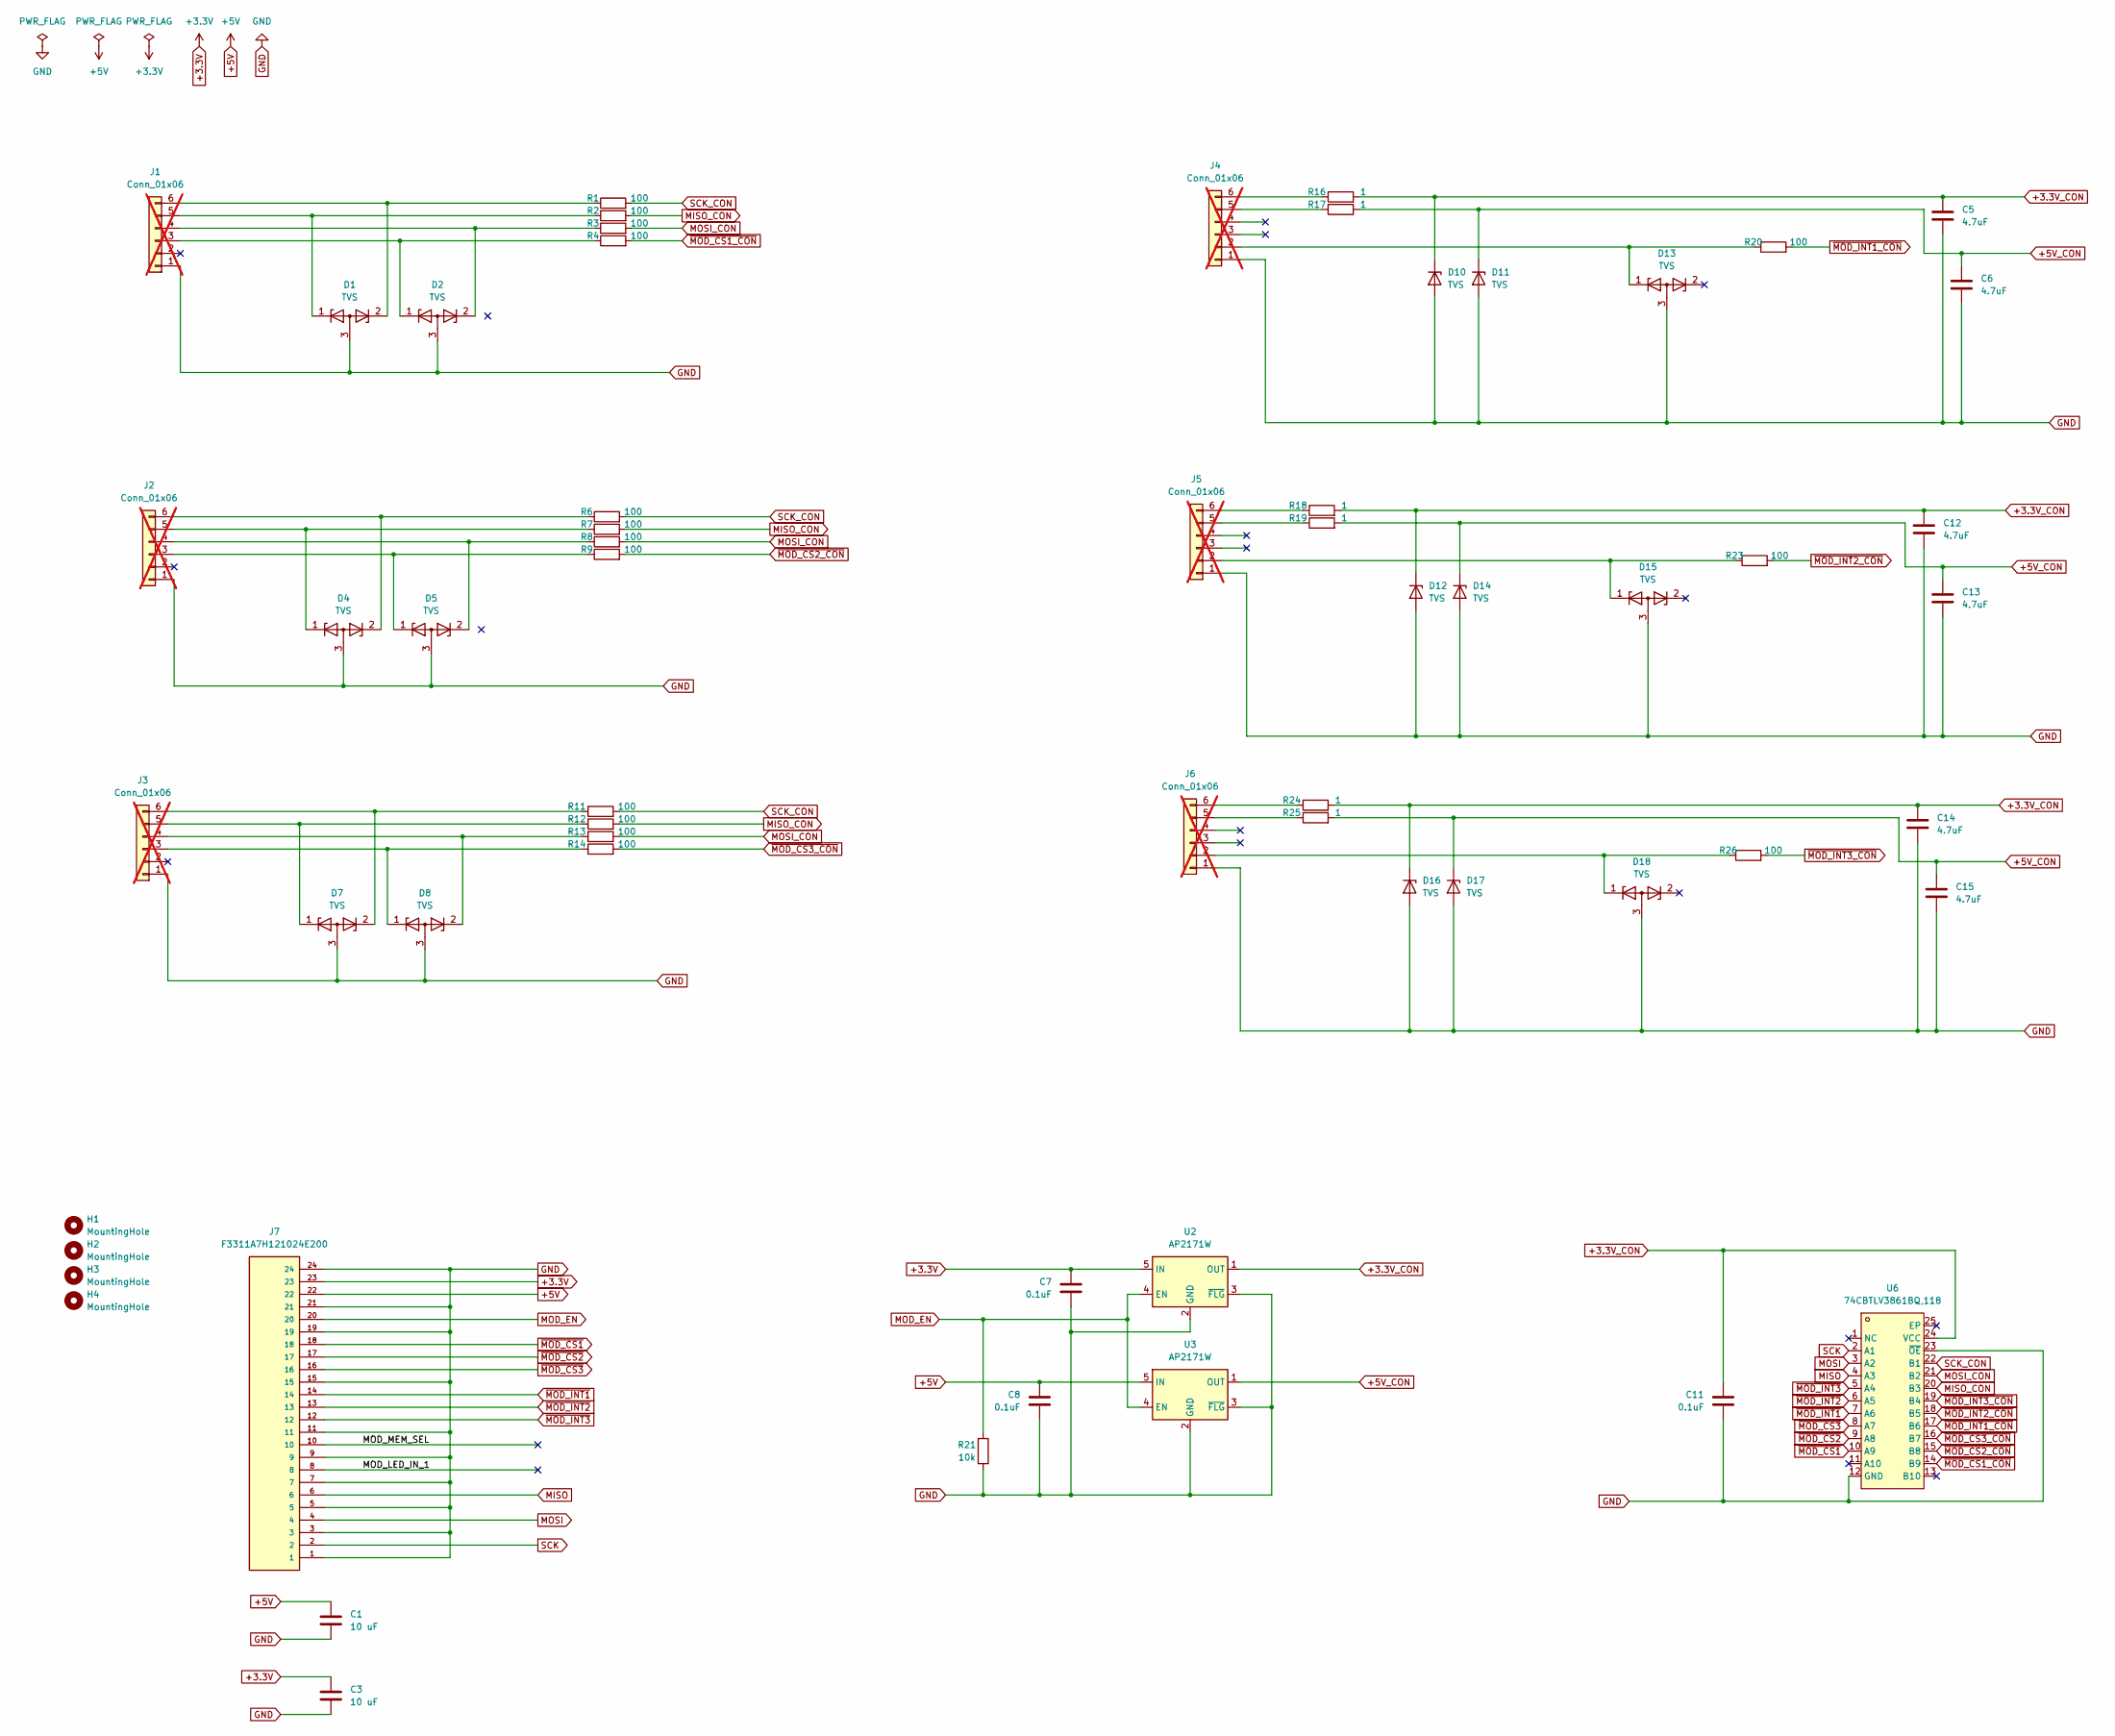
[picture p17: schematic connector-board.kicad_sch]

Parts:
C1, C3: 10 uF; C_1206_3216Metric
C5, C6, C12, C13, C14, C15: 4.7uF; C_0805_2012Metric
C7, C8, C11: 0.1uF; C_0603_1608Metric
D1, D2, D4, D5, D7, D8, D13, D15, D18: TVS; SOT-723
D10, D11, D12, D14, D16, D17: TVS; Nexperia_CFP3_SOD-123W
H1, H2, H3, H4: MountingHole; MountingHole_2.2mm_M2
J1, J2, J3, J4, J5, J6: Conn_01x06; PinHeader_1x06_P2.54mm_Vertical; not fitted
J7: F3311A7H121024E200; AMPHENOL_F3311A7H121024E200; PARTREV A
R1, R2, R3, R4, R6, R7, R8, R9, R11, R12, R13, R14, R20, R23, R26: 100; R_0603_1608Metric
R16, R17, R18, R19, R24, R25: 1; R_0805_2012Metric
R21: 10k; R_0603_1608Metric
U2, U3: AP2171W; SOT-23-5
U6: 74CBTLV3861BQ,118; DHVQFN24_L5.5-W3.5-P0.50-BL-EP; MPN 74CBTLV3861BQ,118; LCSC Part C458760

Connections:
+3.3V: C3.1, C7.1, J7.23, U2.5 (IN)
+3.3V_CON: C5.1, C11.1, C12.1, C14.1, D10.1 (K), D12.1 (K), D16.1 (K), R16.2, R18.2, R24.2, U2.1 (OUT), U6.24 (VCC)
+5V: C1.1, C8.1, J7.22, U3.5 (IN)
+5V_CON: C6.1, C13.1, C15.1, D11.1 (K), D14.1 (K), D17.1 (K), R17.2, R19.2, R25.2, U3.1 (OUT)
/MOD_LED_IN_1: J7.8
/MOD_MEM_SEL: J7.10
GND: C1.2, C3.2, C5.2, C6.2, C7.2, C8.2, C11.2, C12.2, C13.2, C14.2, C15.2, D1.3 (A), D2.3 (A), D4.3 (A), D5.3 (A), D7.3 (A), D8.3 (A), D10.2 (A), D11.2 (A), D12.2 (A), D13.3 (A), D14.2 (A), D15.3 (A), D16.2 (A), D17.2 (A), D18.3 (A), J1.1, J2.1, J3.1, J4.1, J5.1, J6.1, J7.1, J7.3, J7.5, J7.7, J7.9, J7.11, J7.15, J7.19, J7.21, J7.24, R21.1, U2.2 (GND), U2.3 (~FLG), U3.2 (GND), U3.3 (~FLG), U6.12 (GND), U6.23 (~OE)
MISO: J7.6, U6.4 (A3)
MISO_CON: R2.2, R7.2, R12.2, U6.20 (B3)
MOD_EN: J7.20, R21.2, U2.4 (EN), U3.4 (EN)
MOSI: J7.4, U6.3 (A2)
MOSI_CON: R3.2, R8.2, R13.2, U6.21 (B2)
unnamed: D2.1 (K), J1.3, R4.1
unnamed: D2.2 (K), J1.4, R3.1
unnamed: D1.1 (K), J1.5, R2.1
unnamed: D1.2 (K), J1.6, R1.1
unnamed: D5.1 (K), J2.3, R9.1
unnamed: D5.2 (K), J2.4, R8.1
unnamed: D4.1 (K), J2.5, R7.1
unnamed: D4.2 (K), J2.6, R6.1
unnamed: D8.1 (K), J3.3, R14.1
unnamed: D8.2 (K), J3.4, R13.1
unnamed: D7.1 (K), J3.5, R12.1
unnamed: D7.2 (K), J3.6, R11.1
unnamed: D13.1 (K), J4.2, R20.1
unnamed: J4.5, R17.1
unnamed: J4.6, R16.1
unnamed: D15.1 (K), J5.2, R23.1
unnamed: J5.5, R19.1
unnamed: J5.6, R18.1
unnamed: D18.1 (K), J6.2, R26.1
unnamed: J6.5, R25.1
unnamed: J6.6, R24.1
SCK: J7.2, U6.2 (A1)
SCK_CON: R1.2, R6.2, R11.2, U6.22 (B1)
~MOD_CS1_CON: R4.2, U6.14 (B9)
~MOD_CS1: J7.18, U6.10 (A9)
~MOD_CS2_CON: R9.2, U6.15 (B8)
~MOD_CS2: J7.17, U6.9 (A8)
~MOD_CS3_CON: R14.2, U6.16 (B7)
~MOD_CS3: J7.16, U6.8 (A7)
~MOD_INT1_CON: R20.2, U6.17 (B6)
~MOD_INT1: J7.14, U6.7 (A6)
~MOD_INT2_CON: R23.2, U6.18 (B5)
~MOD_INT2: J7.13, U6.6 (A5)
~MOD_INT3_CON: R26.2, U6.19 (B4)
~MOD_INT3: J7.12, U6.5 (A4)

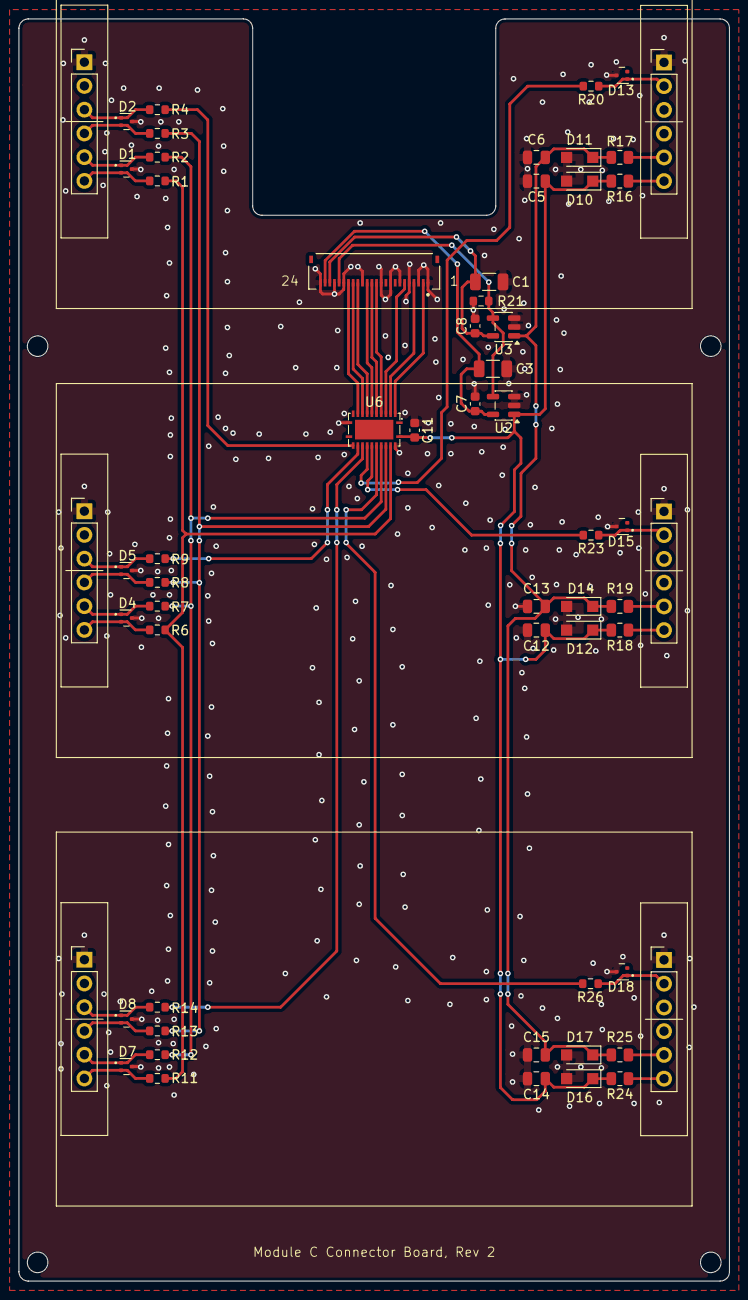
[picture p18: board pcb/module-c/connector-board-r2/connector-board.kicad_pcb from above]

Board: 2 copper layers, 76.0 x 135.0 mm, 62 parts (0 on the bottom side), 45 nets.
