TommyPersson/modular-keypads/pcb/module-c/sub-module-programmer-r1/sub-module-programmer.kicad_pcb

## KiCad design pcb/module-c/sub-module-programmer-r1/sub-module-programmer.kicad_pcb (2026-08-21, an earlier design)

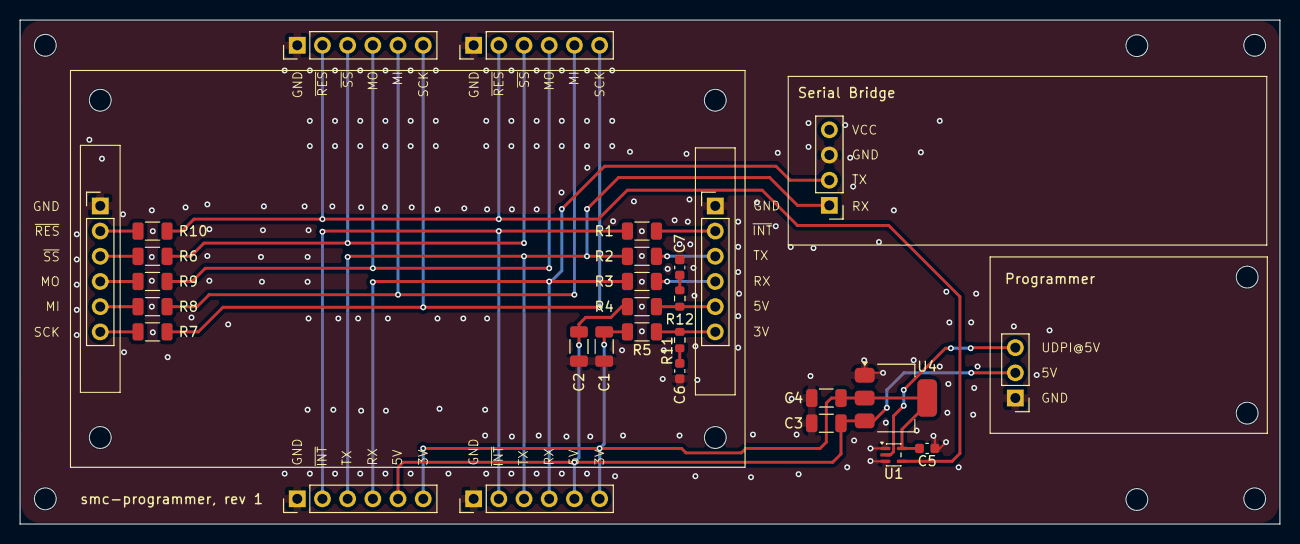
[picture p19: board pcb/module-c/sub-module-programmer-r1/sub-module-programmer.kicad_pcb from above]

Board: 2 copper layers, 127.0 x 50.8 mm, 41 parts (0 on the bottom side), 24 nets.

Parts:
C1, C2: 10uF; C_1206_3216Metric
C3: 10 uF; C_1206_3216Metric
C4: 22 uF; C_1206_3216Metric
C5: 0.1 uF; C_0603_1608Metric
C6, C7: 0.1uF; C_0603_1608Metric
H1, H2, H3, H4, H5, H6, H7, H8, H9, H10, H11, H12: MountingHole; MountingHole_2.2mm_M2
J1, J3, J4, J5, J6, J7: Conn_01x06; PinHeader_1x06_P2.54mm_Vertical
J2: Conn_01x03; PinHeader_1x03_P2.54mm_Vertical
J8: Serial Bridge; PinHeader_1x04_P2.54mm_Vertical
R1, R2, R3, R6: 1k; R_1206_3216Metric
R4, R5: 4.7; R_1206_3216Metric
R7, R8, R9: 220; R_1206_3216Metric
R10: 100; R_1206_3216Metric
R11, R12: 2.2; R_0603_1608Metric
U1: 74AHCT1G125; SOT-353_SC-70-5
U4: LD1117S33TR_SOT223; SOT-223-3_TabPin2

Connections:
+3.3V: C1.1, C4.1, C5.1, J5.6, J7.6, R5.2, U1.5 (VCC), U4.2 (VO)
+5V: C2.1, C3.1, J2.2, J5.5, J7.5, R4.2, U4.3 (VI)
BRIDGE_RX: J5.3, J7.3, J8.1, R2.2
BRIDGE_TX: J5.4, J7.4, J8.2, R3.2
GND: C1.2, C2.2, C3.2, C4.2, C5.2, C6.2, C7.2, J1.1, J2.1, J3.1, J4.1, J5.1, J6.1, J7.1, J8.3, U1.1, U1.3 (GND), U4.1 (GND)
MISO: J4.5, J6.5, R8.2
MOSI: J4.4, J6.4, R9.2
unnamed: C6.1, R11.1
unnamed: C7.1, R12.1
unnamed: J1.2, R1.1
unnamed: J1.3, R2.1
unnamed: J1.4, R3.1
unnamed: J1.5, R4.1, R12.2
unnamed: J1.6, R5.1, R11.2
unnamed: J3.2, R10.1
unnamed: J3.3, R6.1
unnamed: J3.4, R9.1
unnamed: J3.5, R8.1
unnamed: J3.6, R7.1
SCK: J4.6, J6.6, R7.2
UPDI@5V: J2.3, U1.2
~INT: J5.2, J7.2, R1.2
~RESET: J4.2, J6.2, R10.2, U1.4
~SS: J4.3, J6.3, R6.2
