TommyPersson/modular-keypads/pcb/module-e/main-board/module-e1.kicad_pcb

## KiCad design pcb/module-e/main-board/module-e1.kicad_pcb (2026-07-05)

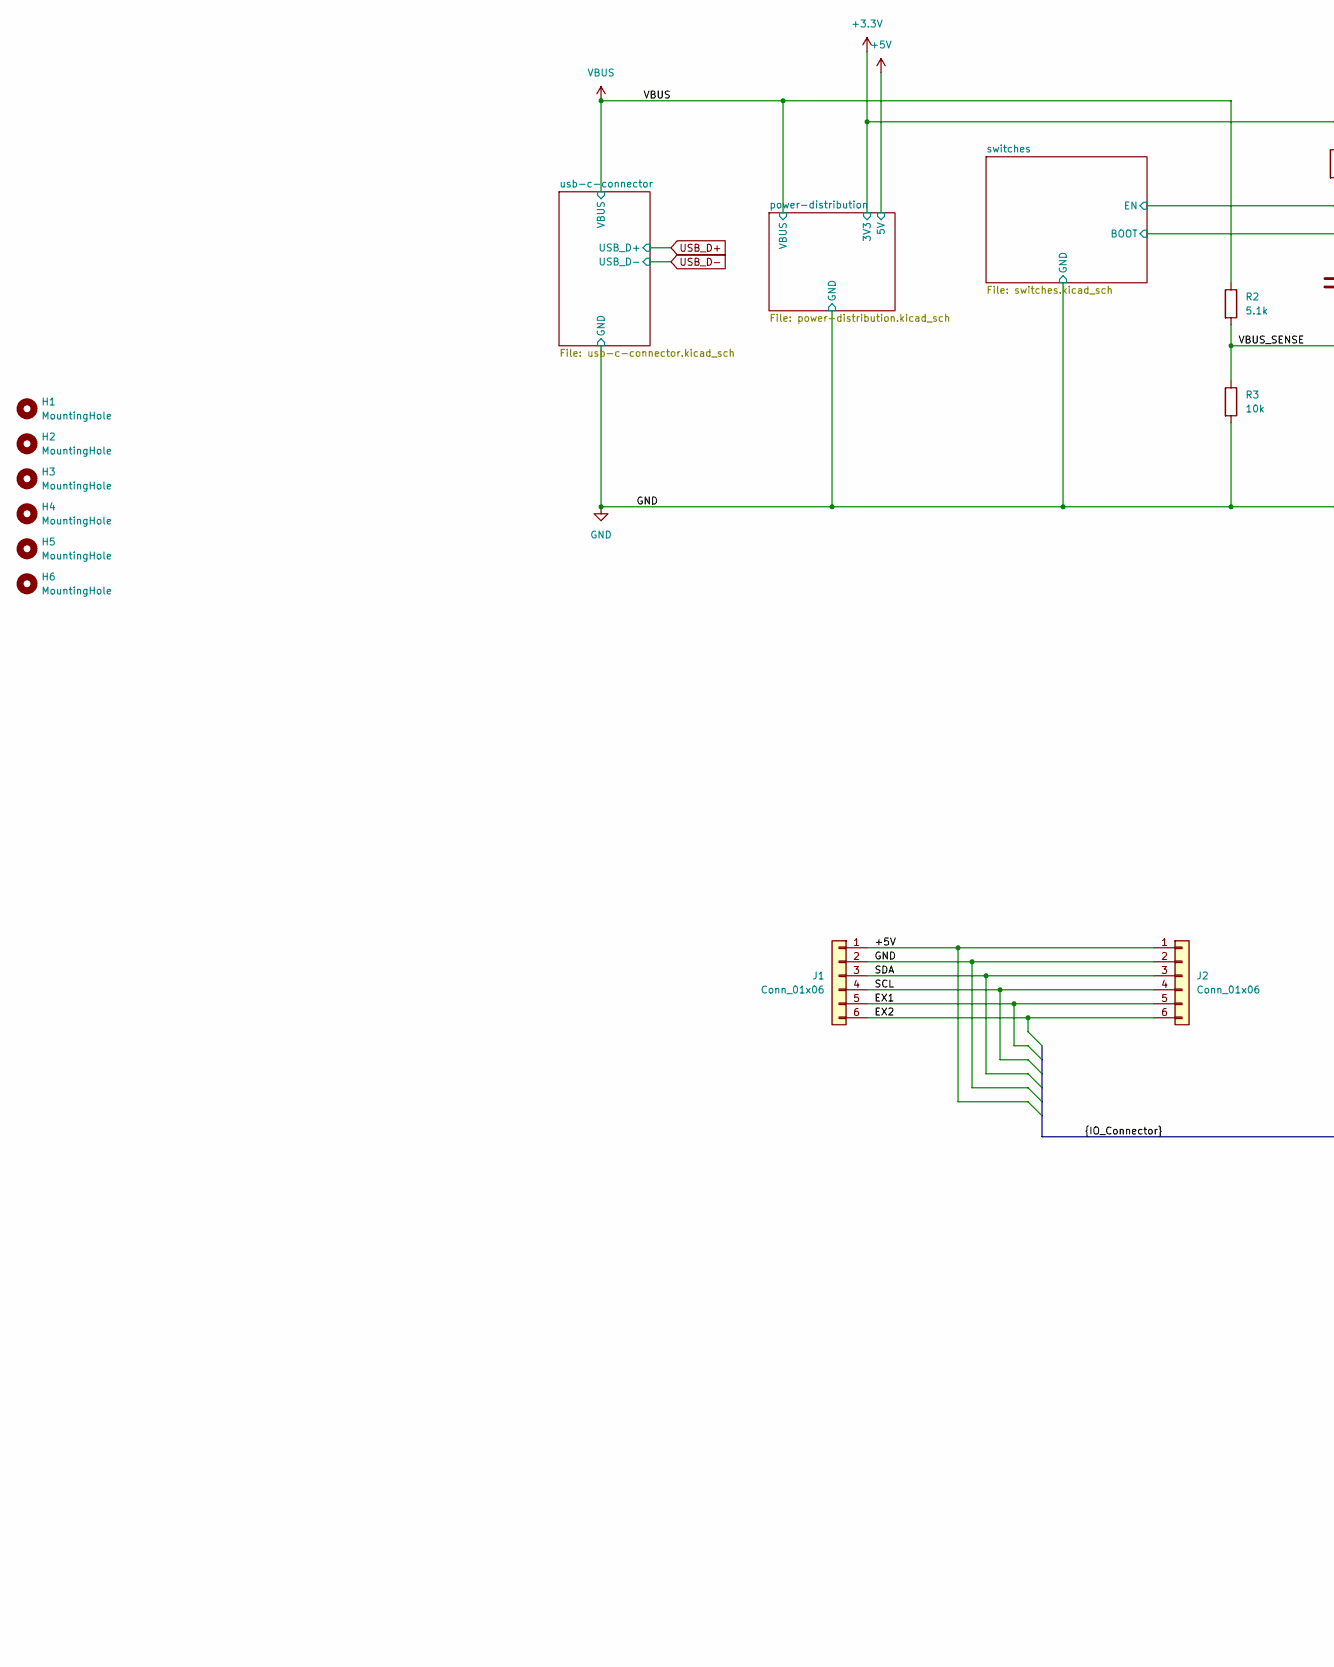
[picture p20: schematic module-e1.kicad_sch, part in row 1, column 1]

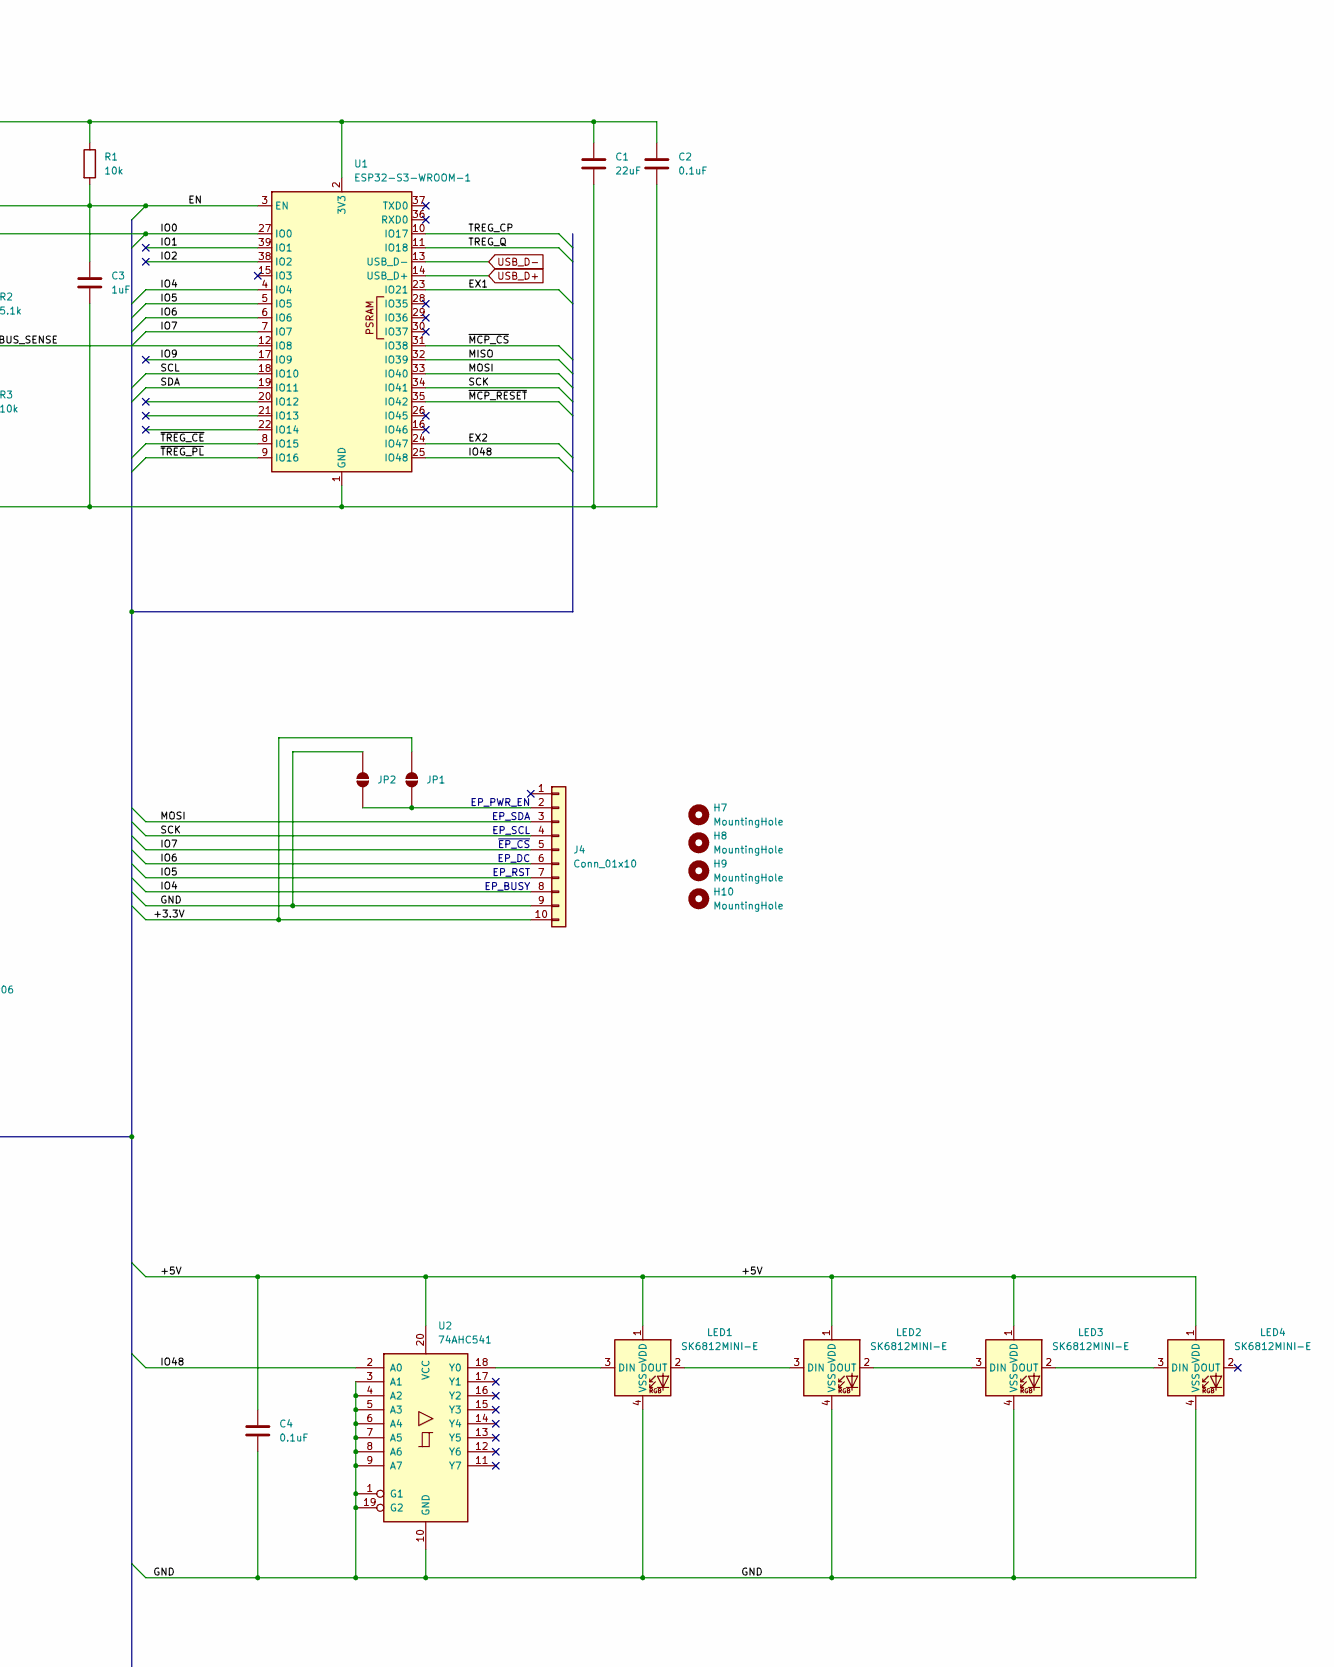
[picture p21: schematic module-e1.kicad_sch, part in row 1, column 2]

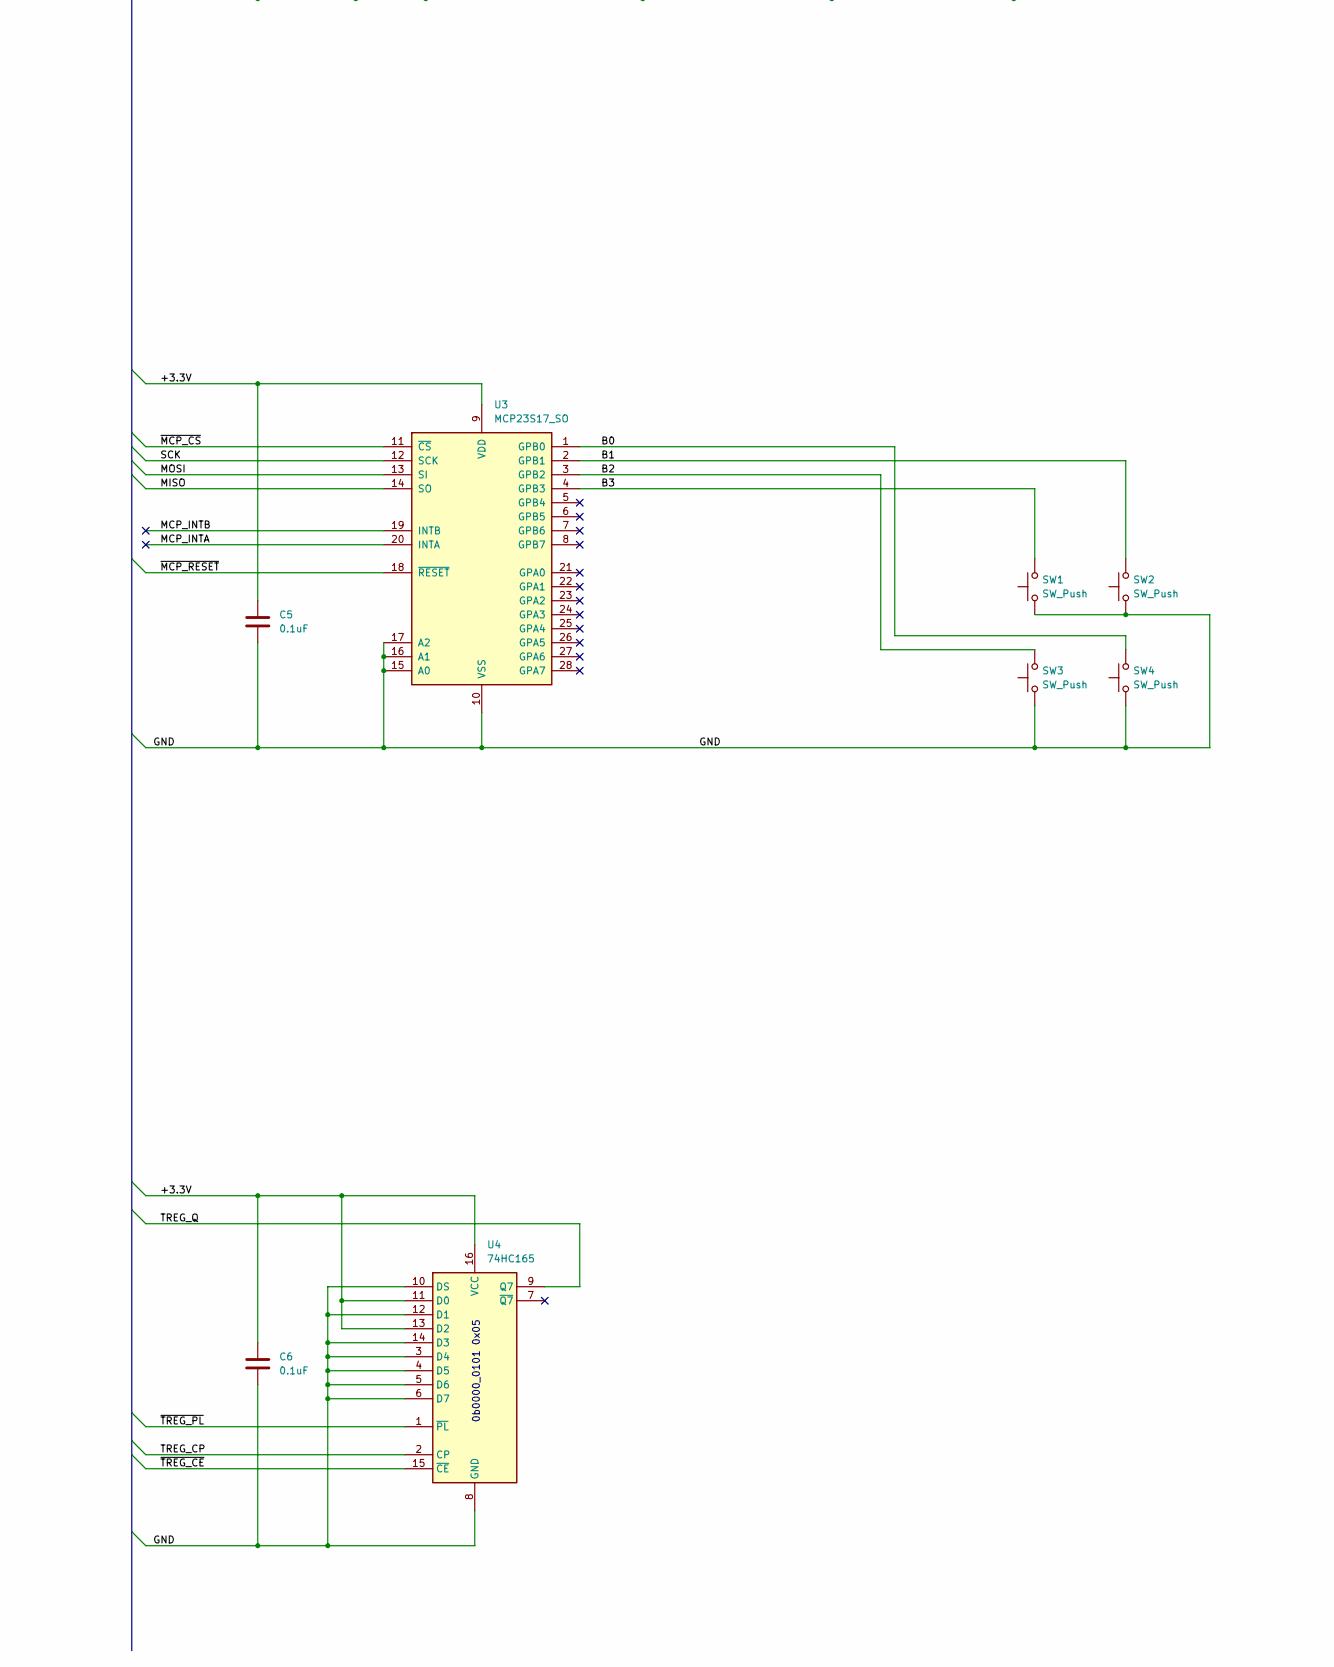
[picture p22: schematic module-e1.kicad_sch, part in row 2, column 2]

Parts:
C1: 22uF; C_1206_3216Metric_Pad1.33x1.80mm_HandSolder
C2, C4, C5, C6: 0.1uF; C_1206_3216Metric_Pad1.33x1.80mm_HandSolder
C3: 1uF; C_1206_3216Metric_Pad1.33x1.80mm_HandSolder
H1, H2, H3, H4, H5, H6, H7, H8, H9, H10: MountingHole; MountingHole_2.2mm_M2
J1: Conn_01x06; PinSocket_1x06_P2.54mm_MagPogoHor_R
J2: Conn_01x06; PinSocket_1x06_P2.54mm_MagPogoHor
J4: Conn_01x10; AMPHENOL_F3311A7H121010E200
JP1, JP2: SolderJumper-2_P1.3mm_Open_TrianglePad1.0x1.5mm
LED1, LED2, LED3, LED4: SK6812MINI-E; LED_choc_6028R-ROT
R1, R3: 10k; R_1206_3216Metric_Pad1.30x1.75mm_HandSolder
R2: 5.1k; R_1206_3216Metric_Pad1.30x1.75mm_HandSolder
SW1, SW2, SW3, SW4: SW_Push; SW_Hotswap_Kailh_Choc_V1_1.50u
U1: ESP32-S3-WROOM-1; ESP32-S3-WROOM-1U
U2: 74AHC541; SOIC-20W_7.5x12.8mm_P1.27mm
U3: MCP23S17_SO; SOIC-28W_7.5x17.9mm_P1.27mm
U4: 74HC165; SOIC-16_3.9x9.9mm_P1.27mm

Connections:
+3.3V: C1.1, C2.1, C5.1, C6.1, J4.10, JP1.2 (B), R1.1, U1.2 (3V3), U3.9 (VDD), U4.11 (D0), U4.13 (D2), U4.16 (VCC); also elsewhere on the board
+5V: C4.1, J1.1, J2.1, LED1.1 (VDD), LED2.1 (VDD), LED3.1 (VDD), LED4.1 (VDD), U2.20 (VCC); also elsewhere on the board
/B0: SW4.2, U3.1 (GPB0)
/B1: SW2.2, U3.2 (GPB1)
/B2: SW3.2, U3.3 (GPB2)
/B3: SW1.2, U3.4 (GPB3)
/EN: C3.1, R1.2, U1.3 (EN); also elsewhere on the board
/EX1: J1.5, J2.5, U1.23 (IO21)
/EX2: J1.6, J2.6, U1.24 (IO47)
/IO0: U1.27 (IO0); also elsewhere on the board
/IO1: U1.39 (IO1)
/IO2: U1.38 (IO2)
/IO4: J4.8, U1.4 (IO4)
/IO5: J4.7, U1.5 (IO5)
/IO6: J4.6, U1.6 (IO6)
/IO7: J4.5, U1.7 (IO7)
/IO9: U1.17 (IO9)
/IO48: U1.25 (IO48), U2.2 (A0)
/MCP_INTA: U3.20 (INTA)
/MCP_INTB: U3.19 (INTB)
/MISO: U1.32 (IO39), U3.14 (SO)
/MOSI: J4.3, U1.33 (IO40), U3.13 (SI)
/SCK: J4.4, U1.34 (IO41), U3.12 (SCK)
/SCL: J1.4, J2.4, U1.18 (IO10)
/SDA: J1.3, J2.3, U1.19 (IO11)
/TREG_CP: U1.10 (IO17), U4.2 (CP)
/TREG_Q: U1.11 (IO18), U4.9 (Q7)
/VBUS_SENSE: R2.2, R3.1, U1.12 (IO8)
/~MCP_CS: U1.31 (IO38), U3.11 (~CS)
/~MCP_RESET: U1.35 (IO42), U3.18 (~RESET)
/~TREG_CE: U1.8 (IO15), U4.15 (~CE)
/~TREG_PL: U1.9 (IO16), U4.1 (~PL)
GND: C1.2, C2.2, C3.2, C4.2, C5.2, C6.2, J1.2, J2.2, J4.9, JP2.2 (B), LED1.4 (VSS), LED2.4 (VSS), LED3.4 (VSS), LED4.4 (VSS), R3.2, SW1.1, SW2.1, SW3.1, SW4.1, U1.1 (GND), U1.40 (GND), U1.41 (GND), U2.1 (G1), U2.3 (A1), U2.4 (A2), U2.5 (A3), U2.6 (A4), U2.7 (A5), U2.8 (A6), U2.9 (A7), U2.10 (GND), U2.19 (G2), U3.10 (VSS), U3.15 (A0), U3.16 (A1), U3.17 (A2), U4.3 (D4), U4.4 (D5), U4.5 (D6), U4.6 (D7), U4.8 (GND), U4.10 (DS), U4.12 (D1), U4.14 (D3); also elsewhere on the board
unnamed: J4.2, JP1.1 (A), JP2.1 (A)
unnamed: LED1.3 (DIN), U2.18 (Y0)
unnamed: LED1.2 (DOUT), LED2.3 (DIN)
unnamed: LED2.2 (DOUT), LED3.3 (DIN)
unnamed: LED3.2 (DOUT), LED4.3 (DIN)
USB_D+: U1.14 (USB_D+); also elsewhere on the board
USB_D-: U1.13 (USB_D-); also elsewhere on the board
VBUS: R2.1; also elsewhere on the board

Notes on the sheet:
EP_DC
EP_PWR_EN
EP_RST
EP_SDA
EP_BUSY
0b0000_0101 0x05
~{EP_CS}
EP_SCL

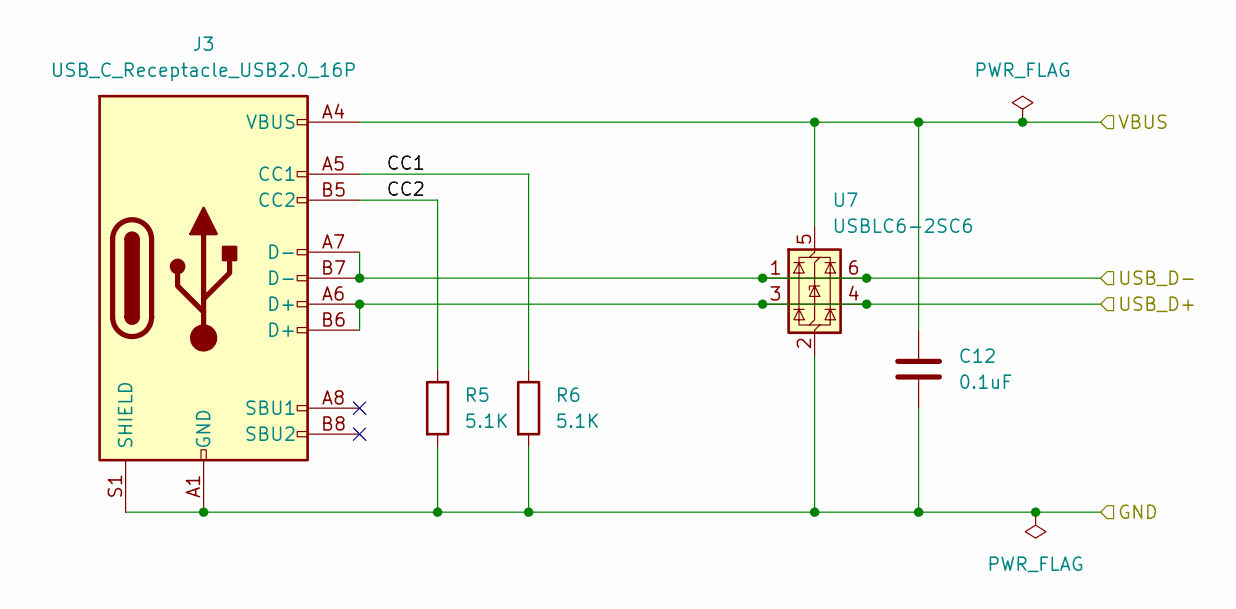
[picture p23: schematic usb-c-connector.kicad_sch]

Parts:
C12: 0.1uF; C_1206_3216Metric_Pad1.33x1.80mm_HandSolder
J3: USB_C_Receptacle_USB2.0_16P; USB_C_Receptacle_GCT_USB4105-xx-A_16P_TopMnt_Horizontal
R5, R6: 5.1K; R_1206_3216Metric_Pad1.30x1.75mm_HandSolder
U7: USBLC6-2SC6; SOT-23-6_Handsoldering

Connections:
/usb-c-connector/CC1: J3.A5 (CC1), R6.1
/usb-c-connector/CC2: J3.B5 (CC2), R5.1
GND: C12.2, J3.A1 (GND), J3.A12 (GND), J3.B1 (GND), J3.B12 (GND), J3.S1 (SHIELD), R5.2, R6.2, U7.2 (GND); also elsewhere on the board
USB_D+: J3.A6 (D+), J3.B6 (D+), U7.3 (I/O2), U7.4 (I/O2); also elsewhere on the board
USB_D-: J3.A7 (D-), J3.B7 (D-), U7.1 (I/O1), U7.6 (I/O1); also elsewhere on the board
VBUS: C12.1, J3.A4 (VBUS), J3.A9 (VBUS), J3.B4 (VBUS), J3.B9 (VBUS), U7.5 (VBUS); also elsewhere on the board

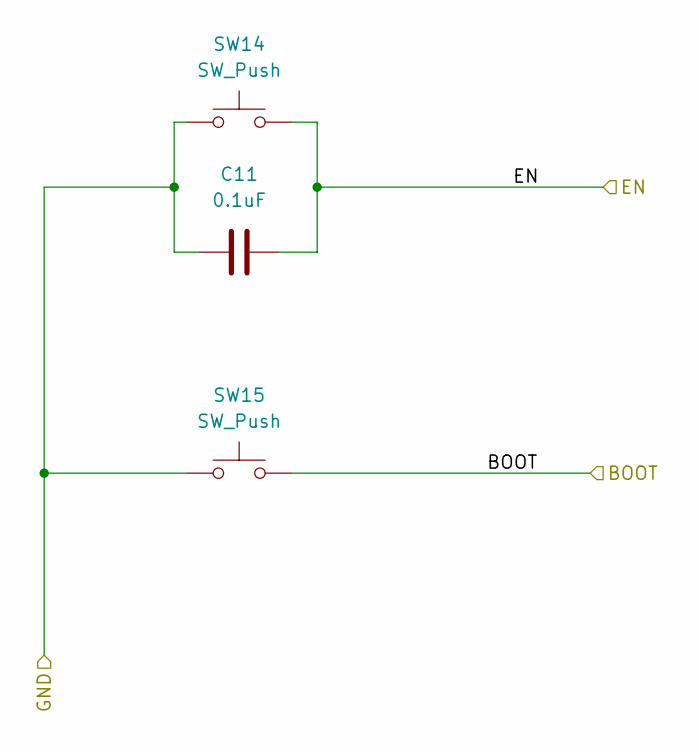
[picture p24: schematic switches.kicad_sch]

Parts:
C11: 0.1uF; C_1206_3216Metric_Pad1.33x1.80mm_HandSolder
SW14, SW15: SW_Push; Panasonic_EVQPUL_EVQPUC

Connections:
/EN: C11.2, SW14.2; also elsewhere on the board
/IO0: SW15.2; also elsewhere on the board
GND: C11.1, SW14.1, SW15.1; also elsewhere on the board

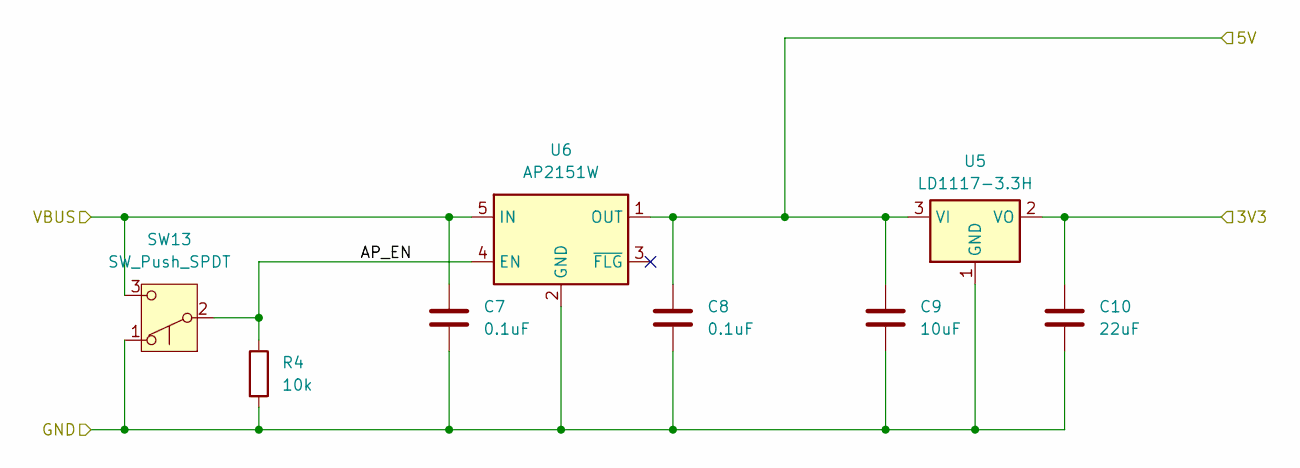
[picture p25: schematic power-distribution.kicad_sch]

Parts:
C7, C8: 0.1uF; C_1206_3216Metric_Pad1.33x1.80mm_HandSolder
C9: 10uF; C_1206_3216Metric_Pad1.33x1.80mm_HandSolder
C10: 22uF; C_1206_3216Metric_Pad1.33x1.80mm_HandSolder
R4: 10k; R_1206_3216Metric_Pad1.30x1.75mm_HandSolder
SW13: SW_Push_SPDT; SW_MSK12C02-HB
U5: LD1117-3.3H; SOT-223-3_TabPin2
U6: AP2151W; SOT-23-5_HandSoldering

Connections:
+3.3V: C10.1, U5.2 (VO); also elsewhere on the board
+5V: C8.1, C9.1, U5.3 (VI), U6.1 (OUT); also elsewhere on the board
/power-distribution/AP_EN: R4.1, SW13.2 (B), U6.4 (EN)
GND: C7.2, C8.2, C9.2, C10.2, R4.2, SW13.1 (A), U5.1 (GND), U6.2 (GND); also elsewhere on the board
VBUS: C7.1, SW13.3 (C), U6.5 (IN); also elsewhere on the board

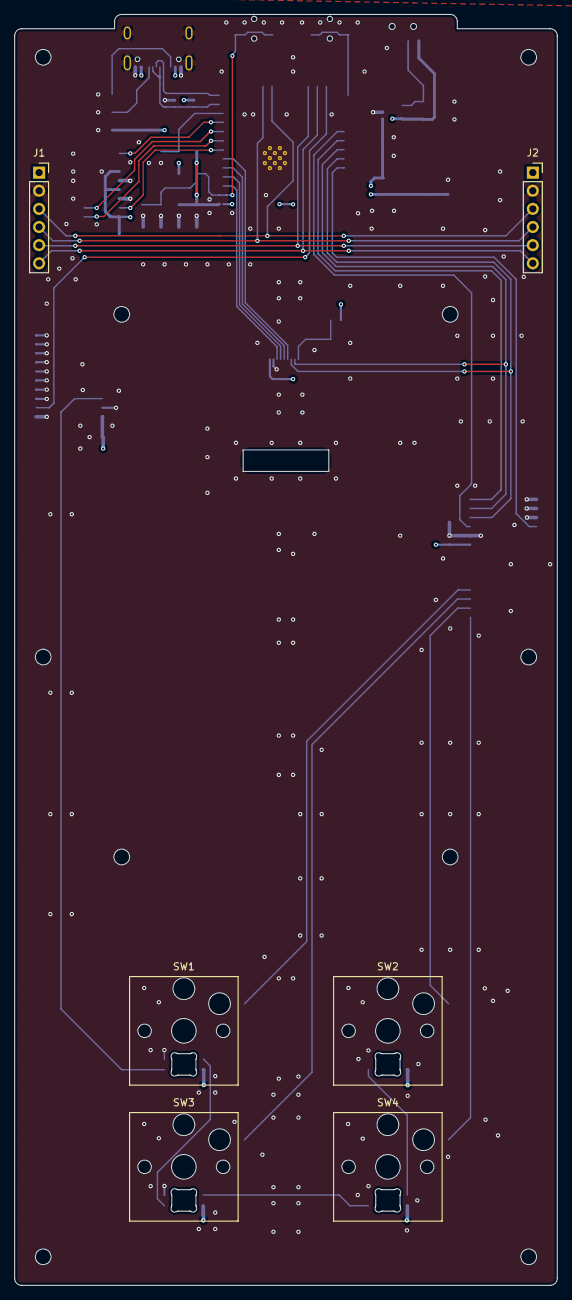
[picture p26: board module-e1.kicad_pcb from above]

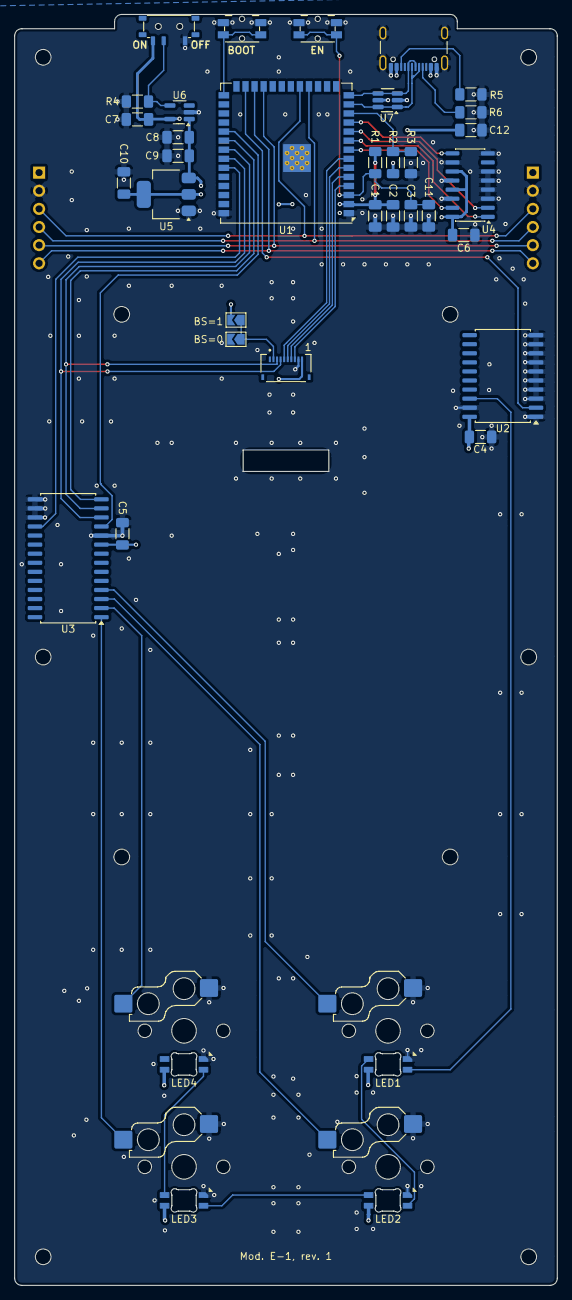
[picture p27: board module-e1.kicad_pcb from below]

Board: 4 copper layers, 76.0 x 178.0 mm, 52 parts (36 on the bottom side), 39 nets.
