TommyPersson/modular-keypads/pcb/module-c/connector-board-r1/connector-board.kicad_pcb

## KiCad design pcb/module-c/connector-board-r1/connector-board.kicad_pcb (2026-07-26, an earlier design)

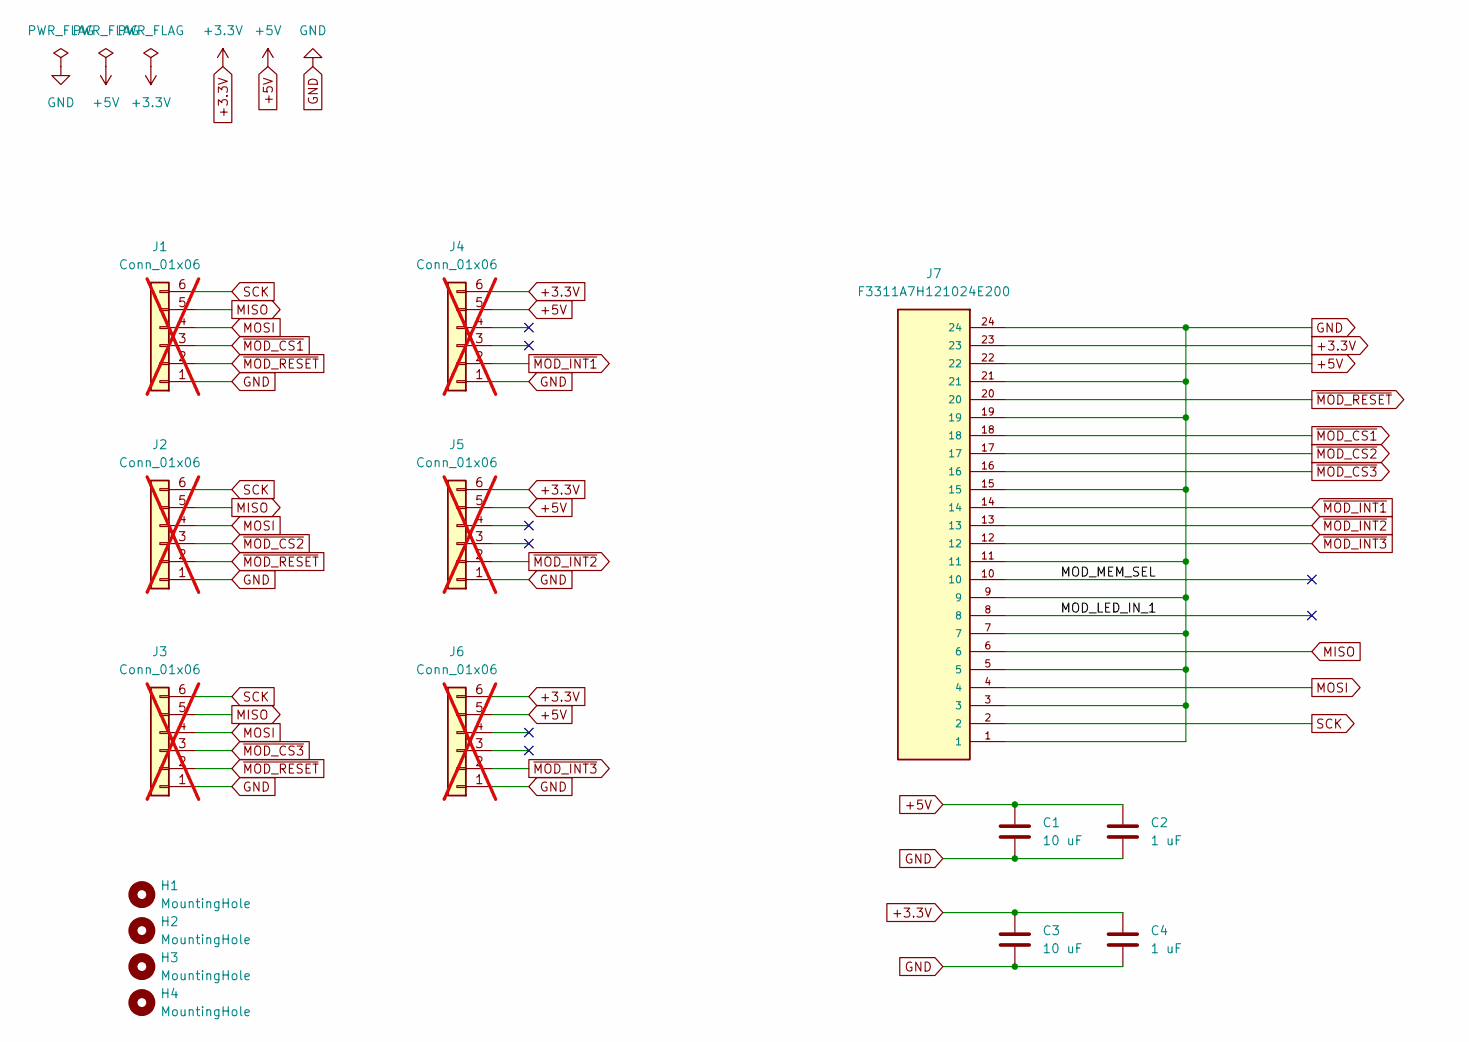
[picture p28: schematic connector-board.kicad_sch]

Parts:
C1, C3: 10 uF; C_1206_3216Metric
C2, C4: 1 uF; C_1206_3216Metric
H1, H2, H3, H4: MountingHole; MountingHole_2.2mm_M2
J1, J2, J3, J4, J5, J6: Conn_01x06; PinHeader_1x06_P2.54mm_Vertical; not fitted
J7: F3311A7H121024E200; AMPHENOL_F3311A7H121024E200; PARTREV A

Connections:
+3.3V: C3.1, C4.1, J4.6, J5.6, J6.6, J7.23
+5V: C1.1, C2.1, J4.5, J5.5, J6.5, J7.22
/MOD_LED_IN_1: J7.8
/MOD_MEM_SEL: J7.10
GND: C1.2, C2.2, C3.2, C4.2, J1.1, J2.1, J3.1, J4.1, J5.1, J6.1, J7.1, J7.3, J7.5, J7.7, J7.9, J7.11, J7.15, J7.19, J7.21, J7.24
MISO: J1.5, J2.5, J3.5, J7.6
MOSI: J1.4, J2.4, J3.4, J7.4
SCK: J1.6, J2.6, J3.6, J7.2
~MOD_CS1: J1.3, J7.18
~MOD_CS2: J2.3, J7.17
~MOD_CS3: J3.3, J7.16
~MOD_INT1: J4.2, J7.14
~MOD_INT2: J5.2, J7.13
~MOD_INT3: J6.2, J7.12
~MOD_RESET: J1.2, J2.2, J3.2, J7.20

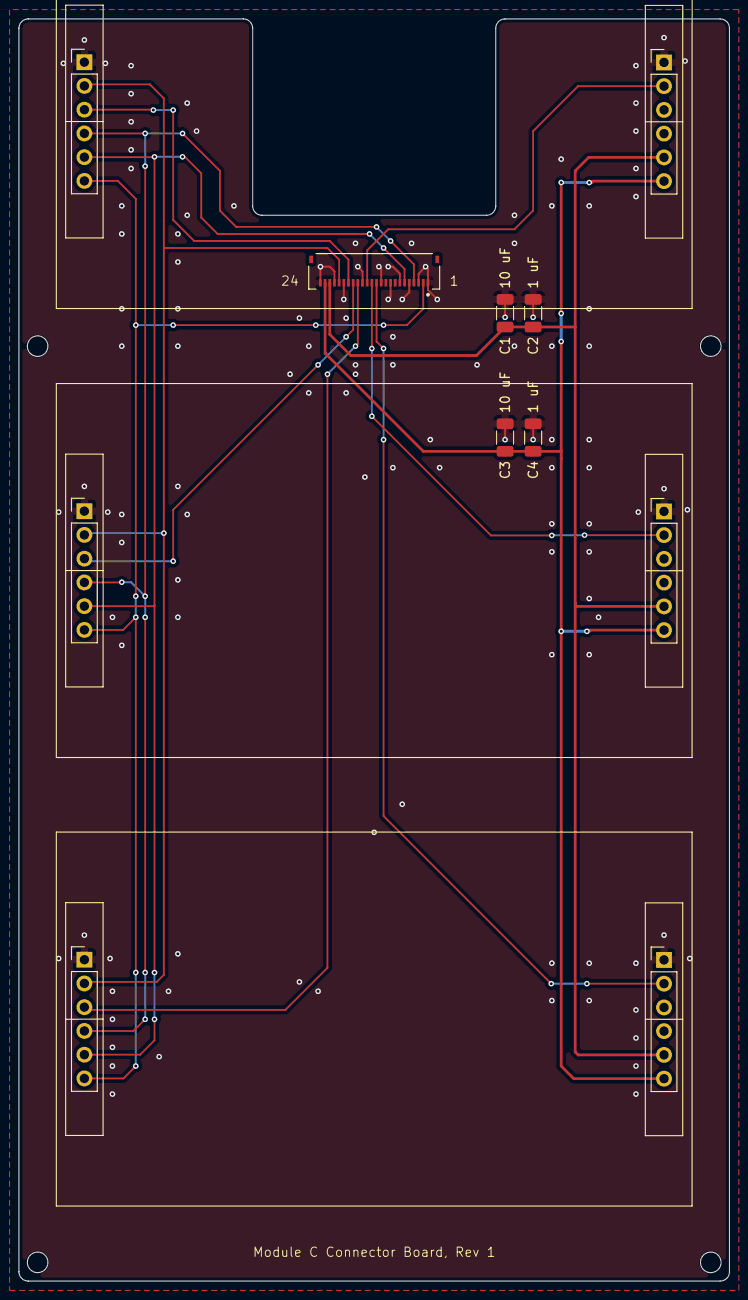
[picture p29: board pcb/module-c/connector-board-r1/connector-board.kicad_pcb from above]

Board: 2 copper layers, 76.0 x 135.0 mm, 15 parts (0 on the bottom side), 13 nets.
