TommyPersson/modular-keypads/pcb/epaper-driver/epaper-driver.kicad_pcb

## KiCad design pcb/epaper-driver/epaper-driver.kicad_pcb (2026-07-05)

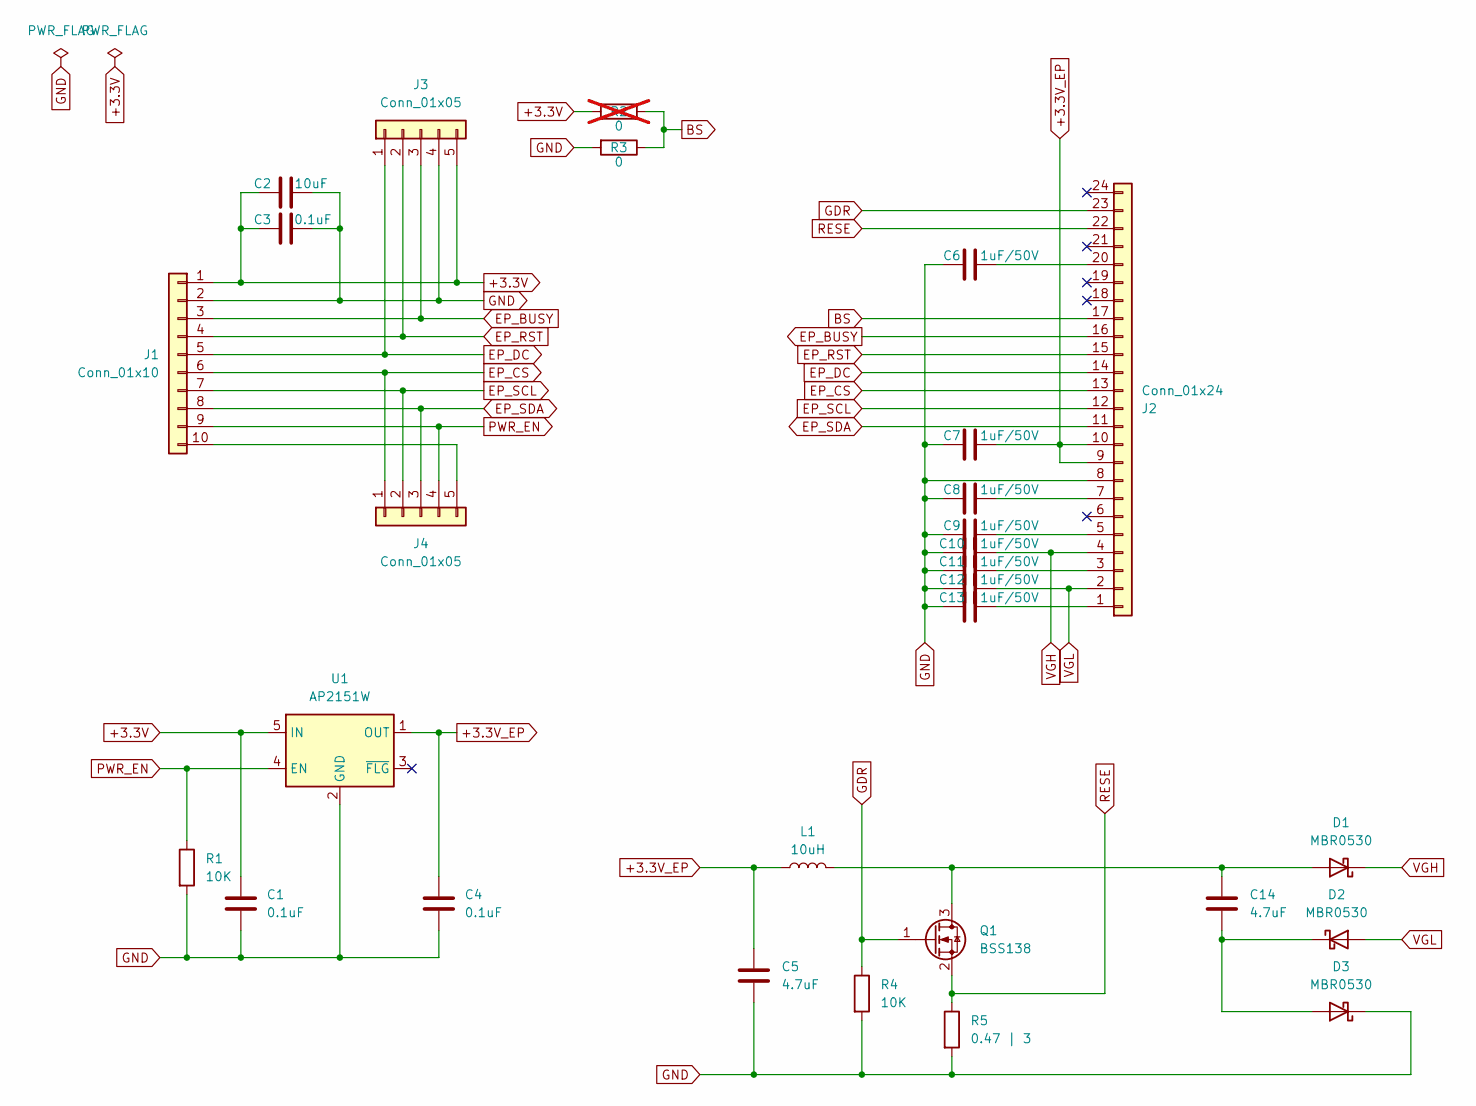
[picture p30: schematic epaper-driver.kicad_sch]

Parts:
C1, C3, C4: 0.1uF; C_1206_3216Metric
C2: 10uF; C_1206_3216Metric
C5, C14: 4.7uF; C_1206_3216Metric
C6, C7, C8, C9, C10, C11, C12, C13: 1uF/50V; C_1206_3216Metric
D1, D2, D3: MBR0530; D_SOD-123
J1: Conn_01x10; AMPHENOL_F3311A7H121010E200
J2: Conn_01x24; AMPHENOL_F3311A7H121024E200
J3, J4: Conn_01x05; PinHeader_1x05_P2.54mm_Vertical
L1: 10uH; Bourns Inductor CM45
Q1: BSS138; SOT-23
R1, R4: 10K; R_1206_3216Metric
R2: 0; R_1206_3216Metric; not fitted
R3: 0; R_1206_3216Metric
R5: 0.47 | 3; R_1206_3216Metric
U1: AP2151W; SOT-23-5

Connections:
+3.3V: C1.1, C2.1, C3.1, J1.1, J3.5, R2.2, U1.5 (IN)
+3.3V_EP: C4.1, C5.1, C7.2, J2.9, J2.10, L1.1, U1.1 (OUT)
BS: J2.17, R2.1, R3.1
EP_BUSY: J1.3, J2.16, J3.3
EP_CS: J1.6, J2.13, J4.1
EP_DC: J1.5, J2.14, J3.1
EP_RST: J1.4, J2.15, J3.2
EP_SCL: J1.7, J2.12, J4.2
EP_SDA: J1.8, J2.11, J4.3
GDR: J2.23, Q1.1 (G), R4.1
GND: C1.2, C2.2, C3.2, C4.2, C5.2, C6.1, C7.1, C8.1, C9.1, C10.1, C11.1, C12.1, C13.1, D3.1 (K), J1.2, J2.8, J3.4, R1.2, R3.2, R4.2, R5.2, U1.2 (GND)
unnamed: C14.1, D1.2 (A), L1.2, Q1.3 (D)
unnamed: C14.2, D2.1 (K), D3.2 (A)
unnamed: J1.10, J4.5
unnamed: C13.2, J2.1
unnamed: C11.2, J2.3
unnamed: C9.2, J2.5
unnamed: C8.2, J2.7
unnamed: C6.2, J2.20
PWR_EN: J1.9, J4.4, R1.1, U1.4 (EN)
RESE: J2.22, Q1.2 (S), R5.1
VGH: C10.2, D1.1 (K), J2.4
VGL: C12.2, D2.2 (A), J2.2

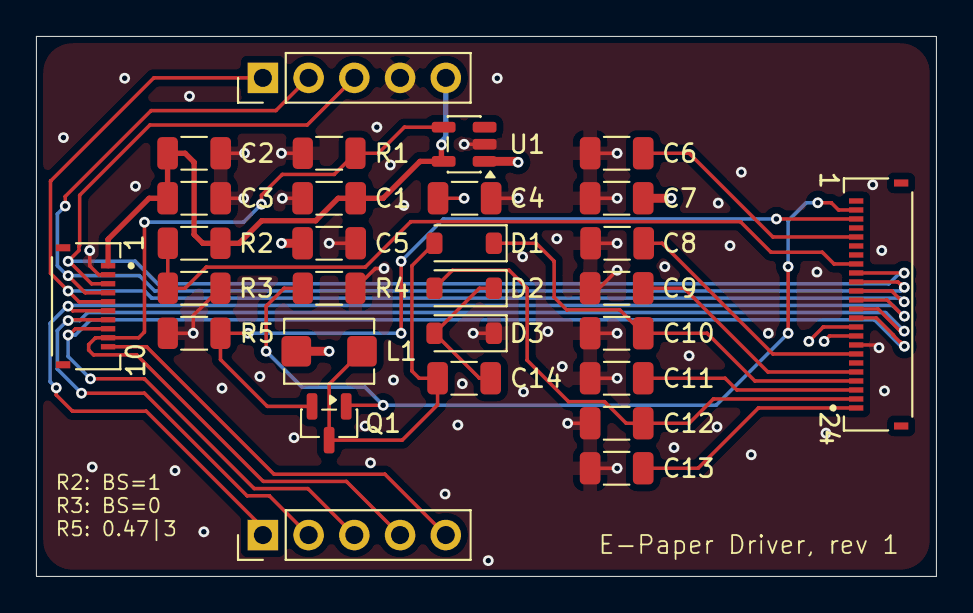
[picture p31: board epaper-driver.kicad_pcb from above]

Board: 4 copper layers, 50.0 x 30.0 mm, 29 parts (0 on the bottom side), 23 nets.
