TommyPersson/modular-keypads/pcb/modular-key-pad.kicad_pcb

## KiCad design pcb/modular-key-pad.kicad_pcb (2025-09-14)

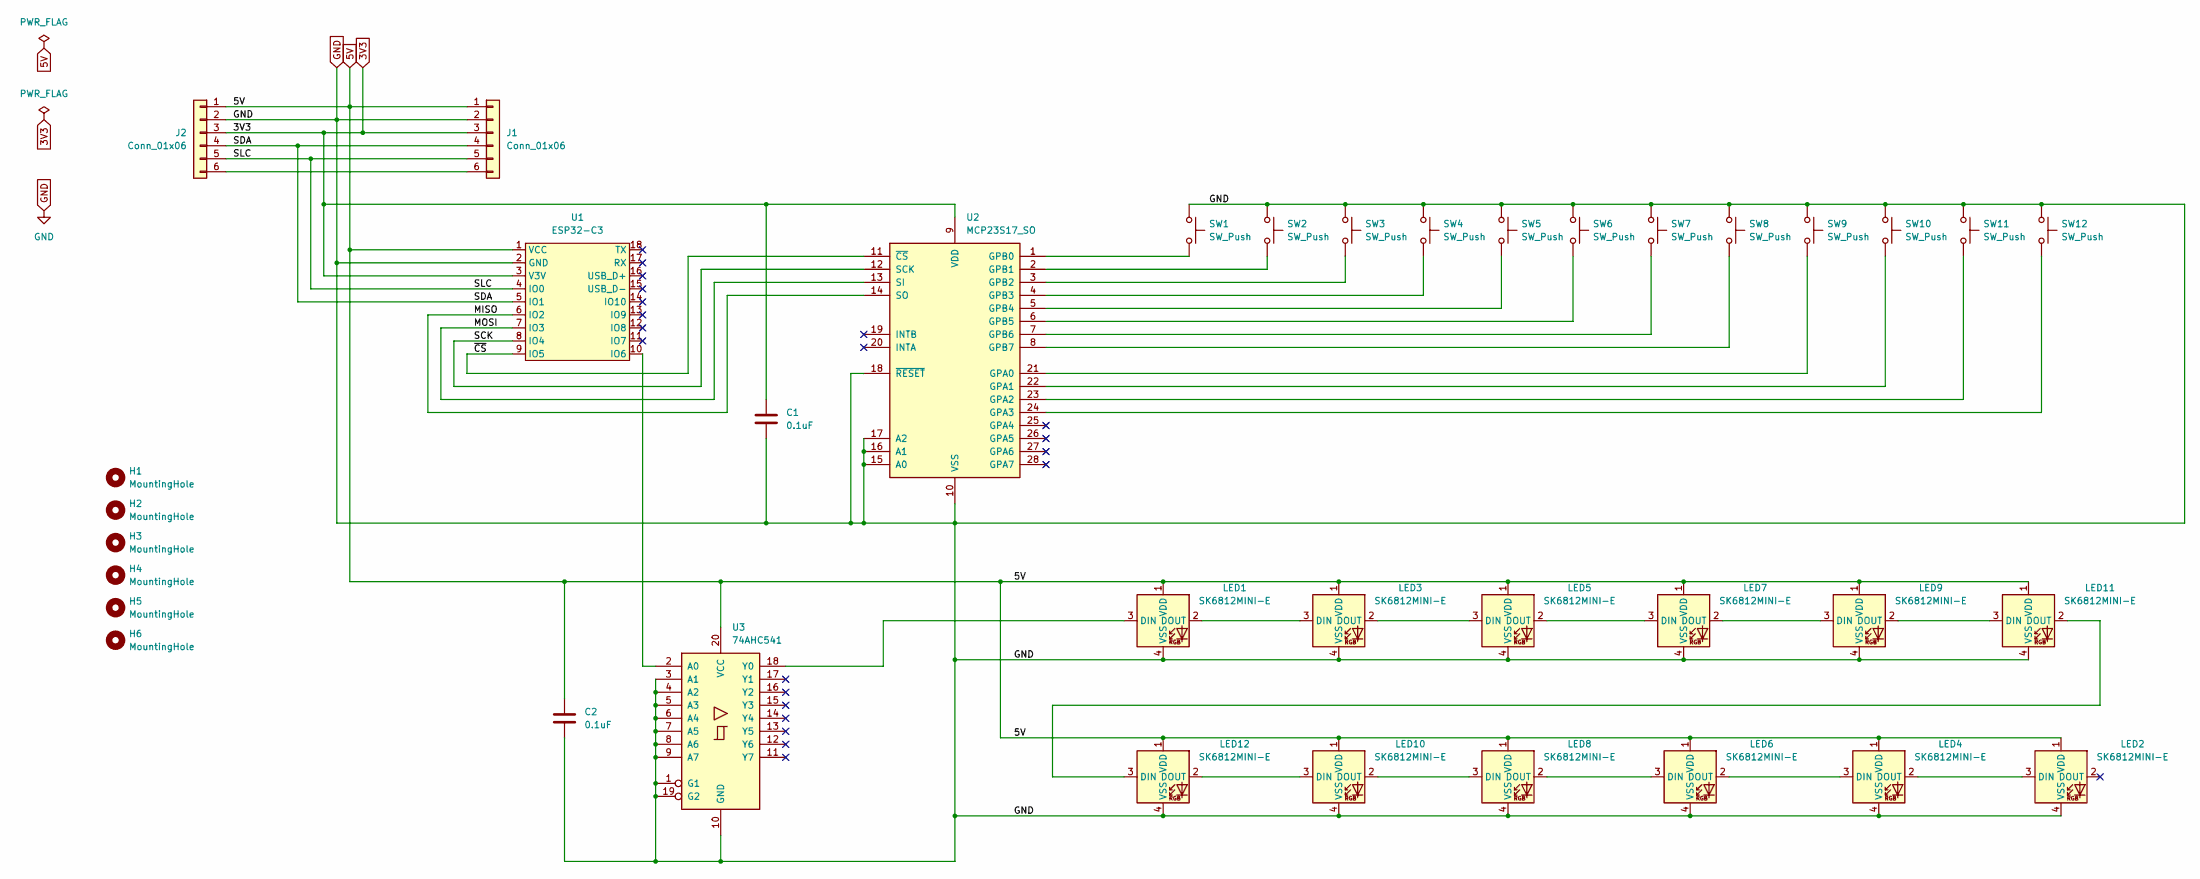
[picture p32: schematic modular-key-pad.kicad_sch]

Parts:
C1, C2: 0.1uF; C_1206_3216Metric_Pad1.33x1.80mm_HandSolder
H1, H2, H3, H4, H5, H6: MountingHole; MountingHole_2.2mm_M2
J1: Conn_01x06; PinSocket_1x06_P2.54mm_MagPogoHor
J2: Conn_01x06; PinSocket_1x06_P2.54mm_MagPogoHor_R
LED1, LED2, LED3, LED4, LED5, LED6, LED7, LED8, LED9, LED10, LED11, LED12: SK6812MINI-E; LED_choc_6028R-ROT
SW1, SW2, SW3, SW4, SW5, SW6, SW7, SW8, SW9, SW10, SW11, SW12: SW_Push; SW_Hotswap_Kailh_Choc_V1_1.50u
U1: ESP32-C3; Waveshare-ESP32-C3-Zero
U2: MCP23S17_SO; SOIC-28W_7.5x17.9mm_P1.27mm
U3: 74AHC541; SOIC-20W_7.5x12.8mm_P1.27mm

Connections:
3V3: C1.1, J1.3, J2.3, U1.3 (V3V), U2.9 (VDD)
5V: C2.1, J1.1, J2.1, LED1.1 (VDD), LED2.1 (VDD), LED3.1 (VDD), LED4.1 (VDD), LED5.1 (VDD), LED6.1 (VDD), LED7.1 (VDD), LED8.1 (VDD), LED9.1 (VDD), LED10.1 (VDD), LED11.1 (VDD), LED12.1 (VDD), U1.1 (VCC), U3.20 (VCC)
/MISO: U1.6 (IO2), U2.14 (SO)
/MOSI: U1.7 (IO3), U2.13 (SI)
/SCK: U1.8 (IO4), U2.12 (SCK)
/SDA: J1.4, J2.4, U1.5 (IO1)
/SLC: J1.5, J2.5, U1.4 (IO0)
/~CS: U1.9 (IO5), U2.11 (~CS)
GND: C1.2, C2.2, J1.2, J2.2, LED1.4 (VSS), LED2.4 (VSS), LED3.4 (VSS), LED4.4 (VSS), LED5.4 (VSS), LED6.4 (VSS), LED7.4 (VSS), LED8.4 (VSS), LED9.4 (VSS), LED10.4 (VSS), LED11.4 (VSS), LED12.4 (VSS), SW1.1, SW2.1, SW3.1, SW4.1, SW5.1, SW6.1, SW7.1, SW8.1, SW9.1, SW10.1, SW11.1, SW12.1, U1.2 (GND), U2.10 (VSS), U2.15 (A0), U2.16 (A1), U2.17 (A2), U2.18 (~RESET), U3.1 (G1), U3.3 (A1), U3.4 (A2), U3.5 (A3), U3.6 (A4), U3.7 (A5), U3.8 (A6), U3.9 (A7), U3.10 (GND), U3.19 (G2)
unnamed: J1.6, J2.6
unnamed: LED1.3 (DIN), U3.18 (Y0)
unnamed: LED1.2 (DOUT), LED3.3 (DIN)
unnamed: LED2.3 (DIN), LED4.2 (DOUT)
unnamed: LED3.2 (DOUT), LED5.3 (DIN)
unnamed: LED4.3 (DIN), LED6.2 (DOUT)
unnamed: LED5.2 (DOUT), LED7.3 (DIN)
unnamed: LED6.3 (DIN), LED8.2 (DOUT)
unnamed: LED7.2 (DOUT), LED9.3 (DIN)
unnamed: LED10.3 (DIN), LED12.2 (DOUT)
unnamed: LED8.3 (DIN), LED10.2 (DOUT)
unnamed: LED9.2 (DOUT), LED11.3 (DIN)
unnamed: LED11.2 (DOUT), LED12.3 (DIN)
unnamed: U1.10 (IO6), U3.2 (A0)
unnamed: SW9.2, U2.21 (GPA0)
unnamed: SW10.2, U2.22 (GPA1)
unnamed: SW11.2, U2.23 (GPA2)
unnamed: SW12.2, U2.24 (GPA3)
unnamed: SW1.2, U2.1 (GPB0)
unnamed: SW2.2, U2.2 (GPB1)
unnamed: SW3.2, U2.3 (GPB2)
unnamed: SW4.2, U2.4 (GPB3)
unnamed: SW5.2, U2.5 (GPB4)
unnamed: SW6.2, U2.6 (GPB5)
unnamed: SW7.2, U2.7 (GPB6)
unnamed: SW8.2, U2.8 (GPB7)

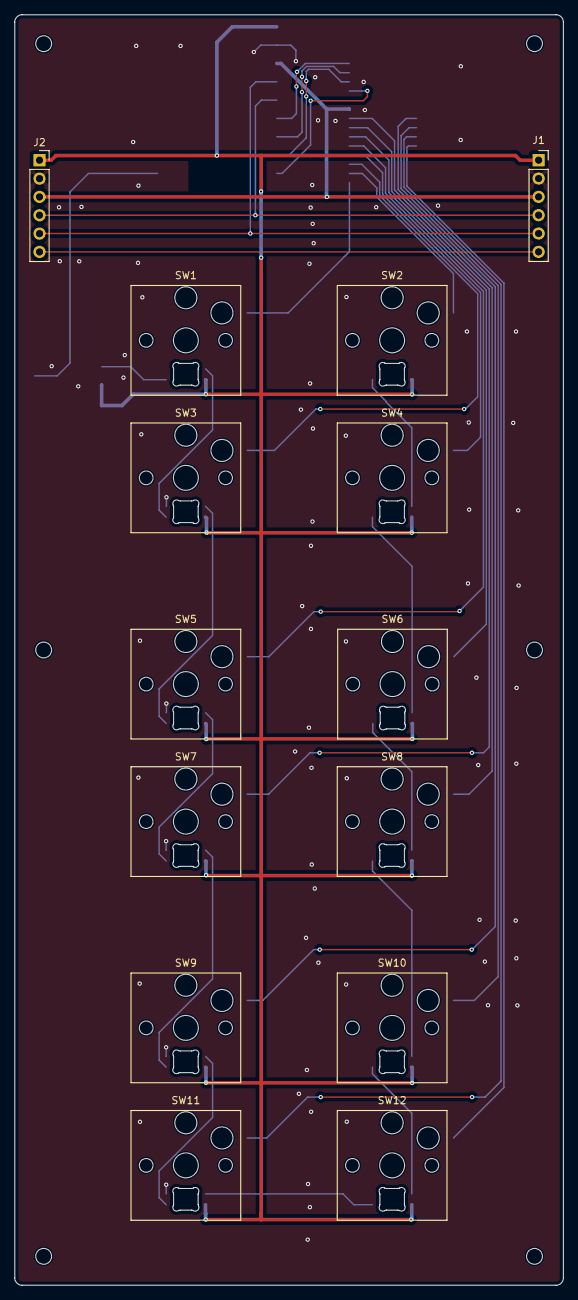
[picture p33: board modular-key-pad.kicad_pcb from above]

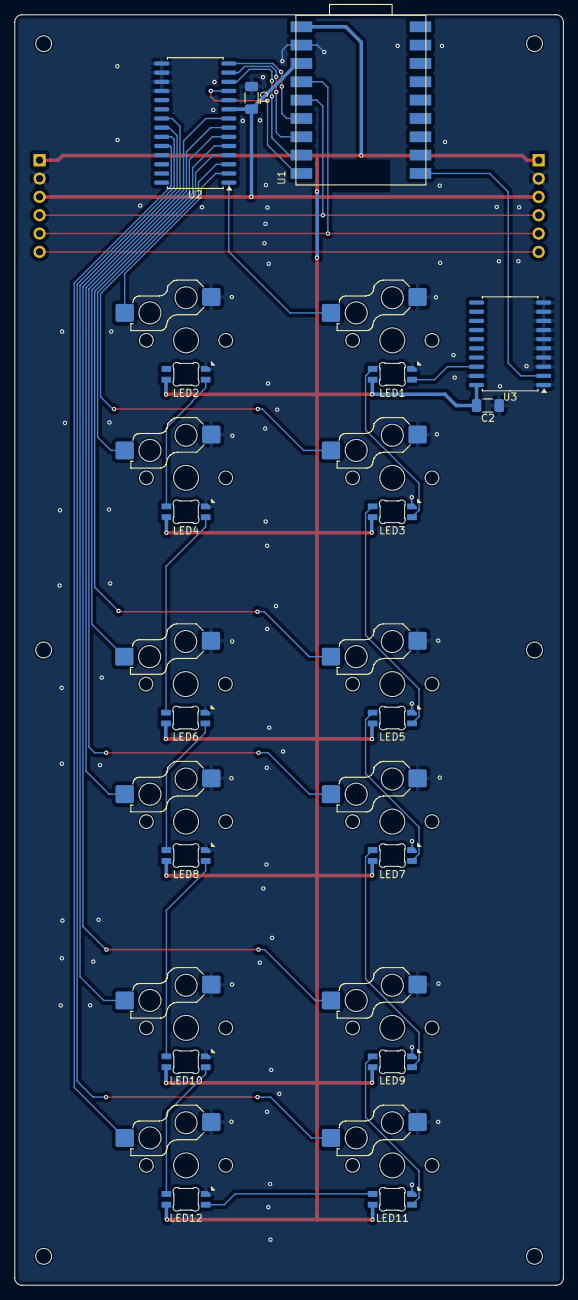
[picture p34: board modular-key-pad.kicad_pcb from below]

Board: 2 copper layers, 76.0 x 176.0 mm, 37 parts (17 on the bottom side), 35 nets.
