TommyPersson/modular-keypads/firmware/main/src/mkp/components/keybindings/KeyBindingExecutor.cpp

#include "KeyBindingExecutor.h"

#include <tfw/hal/logging.h>

#include "mkp/components/settings/Settings.h"

using namespace mkp::components::macros;
using namespace mkp::components::keybindings;
using namespace mkp::devices::common;
using tfw::hal::buttons::ButtonState;

// TODO lots of allocation stuff to optimize

namespace {
    auto logger = tfw::hal::logging::createLogger("KeyBindingSubSystem");
}

KeyBindingExecutor::KeyBindingExecutor(
    MacroStorage& macroStorage,
    KeyBindingStorage& keyBindingStorage,
    TestModeController& testModeController,
    tfw::hal::usb::Connection& usbConnection,
    tfw::hal::settings::DeviceSettings& deviceSettings,
    tfw::hal::metrics::MetricRegistry& metricRegistry,
    const tfw::hal::time::Clock& clock,
    tfw::hal::random::RandomSource& randomSource
) : macroStorage(macroStorage),
    keyBindingStorage(keyBindingStorage),
    testModeController(testModeController),
    usbConnection(usbConnection),
    deviceSettings(deviceSettings),
    randomSource(randomSource),
    sequenceRunner(
        clock,
        [this] { return this->usbConnection.isBusy(); },
        [this](const uint16_t macroId) { executeSequenceStep(macroId); }
    ) {

    macroStorage.onMacroSaved().addObserver(this);
    macroStorage.onMacroRemoved().addObserver(this);
    keyBindingStorage.onKeyBindingSet().addObserver(this);
    keyBindingStorage.onKeyBindingCleared().addObserver(this);

    metricRegistry.add(tfw::hal::metrics::lambda_gauge("macros.num_stored", [this] {
        return this->macroStorage.getNumStored();
    }));

    metricRegistry.add(tfw::hal::metrics::lambda_gauge("keybindings.num_assigned", [this] {
        return this->getNumAssigned();
    }));
}

KeyBindingExecutor::~KeyBindingExecutor() {
    macroStorage.onMacroSaved().removeObserver(this);
    macroStorage.onMacroRemoved().removeObserver(this);
    keyBindingStorage.onKeyBindingSet().removeObserver(this);
    keyBindingStorage.onKeyBindingCleared().removeObserver(this);
}

void KeyBindingExecutor::setup() {
}

void KeyBindingExecutor::loop() {
    if (macrosNeedRefresh) {
        refreshCompiledMacros();
        macrosNeedRefresh = false;
    }

    if (keyBindingsNeedRefresh) {
        refreshKeyBindings();
        keyBindingsNeedRefresh = false;
    }

    // Sequences stop when test mode is enabled, as their keys would no longer send anything either
    if (testModeController.isEnabled()) {
        sequenceRunner.stopAll();
    } else {
        sequenceRunner.update();
    }
}

void KeyBindingExecutor::observe(const MacroSaved& event) {
    macrosNeedRefresh = true;
}

void KeyBindingExecutor::observe(const MacroRemoved& event) {
    macrosNeedRefresh = true;
    keyBindingStorage.removeAll(event.macroId);
}

void KeyBindingExecutor::observe(const KeyBindingSet& event) {
    keyBindingsNeedRefresh = true;
}

void KeyBindingExecutor::observe(const KeyBindingCleared& event) {
    keyBindingsNeedRefresh = true;
}

void KeyBindingExecutor::observe(const DeviceSwitchEvent& event) {
    const auto button = std::make_pair(event.deviceId, event.switchNumber);
    const auto pressKeyBinding = findKeyBinding(event.deviceId, event.switchNumber, ButtonState::PRESSED);
    const auto longPressKeyBinding = findKeyBinding(event.deviceId, event.switchNumber, ButtonState::LONG_PRESSED);

    // Macros with release actions are remembered until the button is released
    const auto holdMacro = [&](const std::shared_ptr<CompiledMacro>& macro) {
        if (macro != nullptr && !macro->releaseActions.empty()) {
            heldMacros[button] = macro;
        }
    };

    switch (event.state) {
    case ButtonState::PRESSED:
        if (longPressKeyBinding == nullptr) {
            holdMacro(executeMacroFor(pressKeyBinding));
        } else {
            // Not known yet whether it's a press or a long press
            pendingPresses.insert(button);
        }
        break;
    case ButtonState::LONG_PRESSED:
        pendingPresses.erase(button);
        holdMacro(executeMacroFor(longPressKeyBinding));
        break;
    case ButtonState::UNPRESSED:
        if (pendingPresses.erase(button) > 0) {
            // Executed on release, so it's released right away
            if (const auto macro = executeMacroFor(pressKeyBinding)) {
                sendReleaseActions(*macro);
            }
        }
        if (const auto held = heldMacros.find(button); held != heldMacros.end()) {
            sendReleaseActions(*held->second);
            heldMacros.erase(held);
        }
        break;
    default:
        break;
    }
}

void KeyBindingExecutor::observe(const DeviceRotaryEncoderEvent& event) {
    executeMacroFor(findKeyBinding(event));
}

std::shared_ptr<KeyBinding> KeyBindingExecutor::findKeyBinding(
    const uint64_t deviceId,
    const uint8_t switchNumber,
    const ButtonState state
) {
    for (const auto& keyBinding : keyBindings) {
        if (keyBinding->trigger->type == PUSH_BUTTON) {
            const auto& trigger = dynamic_cast<PushButtonTrigger&>(*keyBinding->trigger);
            if (trigger.deviceId == deviceId && trigger.number == switchNumber && trigger.state == state) {
                return std::make_shared<KeyBinding>(*keyBinding);
            }
        }
    }

    return nullptr;
}

std::shared_ptr<KeyBinding> KeyBindingExecutor::findKeyBinding(const DeviceRotaryEncoderEvent& event) {
    for (const auto& keyBinding : keyBindings) {
        if (keyBinding->trigger->type == ROTARY_ENCODER) {
            const auto& trigger = dynamic_cast<RotaryEncoderTrigger&>(*keyBinding->trigger);
            if (trigger.deviceId == event.deviceId && trigger.number == event.encoderNumber && trigger.direction == event.direction) {
                return std::make_shared<KeyBinding>(*keyBinding);
            }
        }
    }

    return nullptr;
}


std::shared_ptr<CompiledMacro> KeyBindingExecutor::executeMacroFor(const std::shared_ptr<KeyBinding>& keyBinding) {
    if (testModeController.isEnabled()) {
        return nullptr;
    }

    if (keyBinding == nullptr) {
        return nullptr;
    }

    // Read on every execution, so that changes apply right away. Settings are cached, so this is cheap.
    usbConnection.setTypingDelayMs(settings::TypingDelayMs.get(deviceSettings));
    usbConnection.setModifierHoldMs(settings::ModifierHoldMs.get(deviceSettings));

    const auto macro = findCompiledMacro(keyBinding->macroId);
    if (macro == nullptr) {
        return nullptr;
    }

    if (!macro->steps.empty()) {
        // Pressing the button again stops the sequence, such as one looping for longer than wanted. Rotary encoders
        // don't, as turning one sends steps in quick succession, which would stop and start it over and over.
        const bool isButton = keyBinding->trigger->type == PUSH_BUTTON;
        if (isButton && sequenceRunner.isRunning(macro->macroId)) {
            sequenceRunner.stop(macro->macroId);
        } else {
            sequenceRunner.start(macro->macroId, macro->steps);
        }
    } else {
        for (const auto& action : macro->actions) {
            usbConnection.sendAction(*action);
        }
    }

    return macro;
}

// Sent even in test mode, so that notes started before it was enabled still end
void KeyBindingExecutor::sendReleaseActions(const CompiledMacro& macro) {
    for (const auto& action : macro.releaseActions) {
        usbConnection.sendAction(*action);
    }
}

void KeyBindingExecutor::executeSequenceStep(const uint16_t macroId) {
    // Macros removed since the sequence was saved are skipped, and so are sequences, which can't be nested
    const auto macro = findCompiledMacro(macroId);
    if (macro == nullptr || !macro->steps.empty()) {
        return;
    }

    for (const auto& action : macro->actions) {
        usbConnection.sendAction(*action);
    }
}

std::shared_ptr<CompiledMacro> KeyBindingExecutor::findCompiledMacro(const uint16_t macroId) {
    for (const auto& macro : macros) {
        if (macro->macroId == macroId) {
            return macro;
        }
    }

    return nullptr;
}

void KeyBindingExecutor::refreshCompiledMacros() {
    macros.clear();

    macroStorage.forEach([&](const Macro& macro) {
        auto compiledMacro = compileMacro(macro, randomSource);
        if (compiledMacro != nullptr) {
            macros.push_back(compiledMacro);
        }
    });

    logger->info("Reloaded macros. # Found = %i", macros.size());
}

void KeyBindingExecutor::refreshKeyBindings() {
    keyBindings.clear();

    // TODO large fixed arena for keybinding data?

    keyBindingStorage.forEach([&](const KeyBinding& keyBinding) {
        std::shared_ptr<Trigger> triggerCopy = nullptr;
        if (keyBinding.trigger->type == PUSH_BUTTON) {
            auto pushButtonTrigger = dynamic_cast<PushButtonTrigger&>(*keyBinding.trigger);
            triggerCopy = std::make_shared<PushButtonTrigger>(pushButtonTrigger);
        } else if (keyBinding.trigger->type == ROTARY_ENCODER) {
            auto rotaryEncoderTrigger = dynamic_cast<RotaryEncoderTrigger&>(*keyBinding.trigger);
            triggerCopy = std::make_shared<RotaryEncoderTrigger>(rotaryEncoderTrigger);
        }

        auto keyBindingCopy = std::make_shared<KeyBinding>(triggerCopy, keyBinding.macroId);

        keyBindings.push_back(keyBindingCopy);
    });

    logger->info("Reloaded key bindings. # Found = %i", keyBindings.size());
}
