TommyPersson/modular-keypads/firmware/main/src/mkp/components/keybindings/MacroCompiler.cpp

#include "MacroCompiler.h"

#include <algorithm>

#include <tfw/utils/strings.h>

#include "mkp/components/generators/RandomTextGenerator.h"

using namespace mkp::components::macros;
using namespace mkp::components::keybindings;

std::shared_ptr<CompiledMacro> mkp::components::keybindings::compileMacro(
    const Macro& macro,
    tfw::hal::random::RandomSource& randomSource
) {
    if (macro.data->type == SHORTCUT) {
        const auto& data = dynamic_cast<ShortcutMacroData&>(*macro.data);
        const auto action = tfw::hal::usb::Action::shortcut(
            data.modifiers,
            data.hidKeyCode,
            data.holdModifiers,
            data.holdTimeMs
        );
        return std::make_shared<CompiledMacro>(CompiledMacro{
            .macroId = macro.data->id,
            .actions = std::vector{action},
        });
    }

    if (macro.data->type == CONSUMER_CONTROL) {
        const auto& data = dynamic_cast<ConsumerControlMacroData&>(*macro.data);
        return std::make_shared<CompiledMacro>(CompiledMacro{
            .macroId = macro.data->id,
            .actions = std::vector{tfw::hal::usb::Action::consumerControl(data.usageId)},
        });
    }

    if (macro.data->type == SYSTEM_CONTROL) {
        const auto& data = dynamic_cast<SystemControlMacroData&>(*macro.data);
        return std::make_shared<CompiledMacro>(CompiledMacro{
            .macroId = macro.data->id,
            .actions = std::vector{tfw::hal::usb::Action::systemControl(data.code)},
        });
    }

    if (macro.data->type == TEXT) {
        const auto& data = dynamic_cast<TextMacroData&>(*macro.data);
        const auto encodedText = data.text;
        char decodedText[encodedText.length() + 1];
        tfw::utils::strings::uriDecode(encodedText, decodedText, encodedText.length() + 1);

        return std::make_shared<CompiledMacro>(CompiledMacro{
            .macroId = macro.data->id,
            .actions = std::vector{tfw::hal::usb::Action::type(decodedText)},
        });
    }

    if (macro.data->type == MOUSE_SCROLL) {
        const auto& data = dynamic_cast<MouseScrollMacroData&>(*macro.data);
        return std::make_shared<CompiledMacro>(CompiledMacro{
            .macroId = macro.data->id,
            .actions = std::vector{tfw::hal::usb::Action::mouse(data.modifiers, 0, 0, 0, data.wheel, data.pan)},
        });
    }

    if (macro.data->type == MOUSE_BUTTON) {
        const auto& data = dynamic_cast<MouseButtonMacroData&>(*macro.data);
        return std::make_shared<CompiledMacro>(CompiledMacro{
            .macroId = macro.data->id,
            .actions = std::vector{tfw::hal::usb::Action::mouse(data.modifiers, data.buttons, 0, 0, 0, 0)},
        });
    }

    if (macro.data->type == MOUSE_MOVEMENT) {
        const auto& data = dynamic_cast<MouseMovementMacroData&>(*macro.data);
        return std::make_shared<CompiledMacro>(CompiledMacro{
            .macroId = macro.data->id,
            .actions = std::vector{tfw::hal::usb::Action::mouse(data.modifiers, 0, data.x, data.y, 0, 0)},
        });
    }

    if (macro.data->type == MIDI_NOTE) {
        const auto& data = dynamic_cast<MidiNoteMacroData&>(*macro.data);
        if (data.endOnRelease) {
            return std::make_shared<CompiledMacro>(CompiledMacro{
                .macroId = macro.data->id,
                .actions = std::vector{tfw::hal::usb::Action::heldMidiNote(data.channel, data.note, data.velocity)},
                .steps = {},
                .releaseActions = std::vector{tfw::hal::usb::Action::midiNoteOff(data.channel, data.note)},
            });
        }

        const auto action = tfw::hal::usb::Action::midiNote(data.channel, data.note, data.velocity, data.durationMs);
        return std::make_shared<CompiledMacro>(CompiledMacro{
            .macroId = macro.data->id,
            .actions = std::vector{action},
        });
    }

    if (macro.data->type == MIDI_RELATIVE_CONTROL_CHANGE) {
        const auto& data = dynamic_cast<MidiRelativeControlChangeMacroData&>(*macro.data);
        const auto value = encodeRelativeControlChange(data.amount, data.encoding);
        return std::make_shared<CompiledMacro>(CompiledMacro{
            .macroId = macro.data->id,
            .actions = std::vector{tfw::hal::usb::Action::midiControlChange(data.channel, data.controller, value)},
        });
    }

    if (macro.data->type == MIDI_ABSOLUTE_CONTROL_CHANGE) {
        const auto& data = dynamic_cast<MidiAbsoluteControlChangeMacroData&>(*macro.data);
        const auto action = tfw::hal::usb::Action::midiControlChangeStep(data.channel, data.controller, data.amount);
        return std::make_shared<CompiledMacro>(CompiledMacro{
            .macroId = macro.data->id,
            .actions = std::vector{action},
        });
    }

    if (macro.data->type == RANDOM_TEXT) {
        const auto& data = dynamic_cast<RandomTextMacroData&>(*macro.data);
        const auto generator = generators::RandomTextGenerator::forFormat(data.format);
        if (generator == nullptr) {
            return nullptr;
        }

        const auto action = tfw::hal::usb::Action::typeGenerated(
            [generator, quoted = data.quoted, &randomSource](tfw::utils::allocations::Arena& arena) {
                return generator->generate(quoted, randomSource, arena);
            }
        );
        return std::make_shared<CompiledMacro>(CompiledMacro{
            .macroId = macro.data->id,
            .actions = std::vector{action},
        });
    }

    if (macro.data->type == SEQUENCE) {
        const auto& data = dynamic_cast<SequenceMacroData&>(*macro.data);
        return std::make_shared<CompiledMacro>(CompiledMacro{
            .macroId = macro.data->id,
            .actions = {},
            .steps = data.steps,
        });
    }
    return nullptr;
}

uint8_t mkp::components::keybindings::encodeRelativeControlChange(
    const int8_t amount,
    const RelativeControlChangeEncoding encoding
) {
    const auto limited = std::clamp<int>(amount, -MaxRelativeControlChangeAmount, MaxRelativeControlChangeAmount);

    switch (encoding) {
    case RelativeControlChangeEncoding::TWOS_COMPLEMENT:
        return static_cast<uint8_t>(limited >= 0 ? limited : 128 + limited);
    case RelativeControlChangeEncoding::SIGN_MAGNITUDE:
        return static_cast<uint8_t>(limited >= 0 ? limited : 64 - limited);
    case RelativeControlChangeEncoding::BINARY_OFFSET:
    default:
        return static_cast<uint8_t>(64 + limited);
    }
}
