TommyPersson/modular-keypads/firmware/main/src/mkp/devices/common/Device.h

#pragma once

#include <tfw/hal/i2c/Client.h>

#include "DeviceCapabilities.h"
#include "DeviceConfigurationManager.h"
#include "tfw/hal/buttons/Button.h"
#include "tfw/hal/encoders/RotaryEncoder.h"

namespace mkp::devices::common {
    struct DeviceSwitchEvent {
        const uint64_t deviceId;
        const uint8_t switchNumber;
        const tfw::hal::buttons::ButtonState state;
    };

    struct DeviceRotaryEncoderEvent {
        const uint64_t deviceId;
        const uint8_t encoderNumber;
        const tfw::hal::encoders::RotaryEncoderDirection direction;
    };

    struct DeviceConnectedEvent {
        const uint64_t deviceId;
    };

    struct DeviceDisconnectedEvent {
        const uint64_t deviceId;
    };

    struct DeviceRenamedEvent {
        const uint64_t deviceId;
    };

    class Device {
    public:
        virtual ~Device() = default;

        virtual void setup() = 0;
        virtual void loop() = 0;

        virtual const DeviceConfiguration& getConfiguration() const = 0;
        virtual const std::vector<std::shared_ptr<DeviceCapability>>& getCapabilities() const = 0;
        virtual std::span<Device* const> getSubDevices() const { return {}; }

        /// The version of the firmware the device runs, see FirmwareVersion.h, or empty when it isn't known
        virtual std::string_view getFirmwareVersion() const { return {}; }

        virtual tfw::utils::void_result flashIdentificationLights(uint32_t durationMs) = 0;
        virtual tfw::utils::void_result flashButtonIdentificationLight(uint8_t buttonNumber, uint32_t durationMs) = 0;
        virtual tfw::utils::void_result rename(const std::string_view& deviceName) = 0;

        tfw::utils::observables::Observable<DeviceSwitchEvent>& onSwitchEvent() { return deviceSwitchEventSubject; }

        tfw::utils::observables::Observable<DeviceRotaryEncoderEvent>& onRotaryEncoderEvent() {
            return deviceRotaryEncoderEventSubject;
        }

        tfw::utils::observables::Observable<DeviceRenamedEvent>& onRenamedEvent() { return renamedSubject; }

        tfw::utils::observables::Observable<DeviceConnectedEvent>& onSubDeviceConnectedEvent() { return subDeviceConnectedSubject; }
        tfw::utils::observables::Observable<DeviceDisconnectedEvent>& onSubDeviceDisconnectedEvent() { return subDeviceDisconnectedSubject; }
        tfw::utils::observables::Observable<DeviceRenamedEvent>& onSubDeviceRenamedEvent() { return subDeviceRenamedSubject; }

    protected:
        tfw::utils::observables::Subject<DeviceSwitchEvent> deviceSwitchEventSubject;
        tfw::utils::observables::Subject<DeviceRotaryEncoderEvent> deviceRotaryEncoderEventSubject;
        tfw::utils::observables::Subject<DeviceRenamedEvent> renamedSubject;
        tfw::utils::observables::Subject<DeviceConnectedEvent> subDeviceConnectedSubject;
        tfw::utils::observables::Subject<DeviceDisconnectedEvent> subDeviceDisconnectedSubject;
        tfw::utils::observables::Subject<DeviceRenamedEvent> subDeviceRenamedSubject;
    };

    namespace i2c {
        namespace structs {
#pragma pack(push, 1)
            struct DeviceInformation {
                uint64_t deviceId = 0;
                char deviceType = 'g';
            };

            struct DeviceName {
                char deviceName[tfw::hal::i2c::MAX_PACKET_SIZE]{};
            };

            // Not null terminated when the strings fill their arrays
            struct SubDeviceInformation {
                uint64_t deviceId = 0;
                char deviceType[6]{};
                char deviceName[16]{};
            };

            // Not null terminated when the version fills the array. Empty when read from devices whose firmware
            // doesn't have the endpoint yet.
            struct FirmwareVersion {
                char version[tfw::hal::i2c::MAX_PACKET_SIZE]{};
            };
#pragma pack(pop)
        }

        namespace endpoints {
            inline tfw::hal::i2c::EndpointDescriptor<structs::DeviceInformation> DeviceInformation{.id = 0x01};
            inline tfw::hal::i2c::EndpointDescriptor<structs::DeviceName> DeviceName{.id = 0x02};
            inline tfw::hal::i2c::EndpointDescriptor<structs::FirmwareVersion> FirmwareVersion{.id = 0x03};

            // One endpoint per sub-device, indexed as in Device::getSubDevices()
            inline tfw::hal::i2c::EndpointDescriptor<structs::SubDeviceInformation> SubDeviceInformation(
                const uint8_t subDeviceIndex
            ) {
                return {.id = static_cast<uint8_t>(0x10 + subDeviceIndex)};
            }
        }
    }
}
