TommyPersson/modular-keypads/firmware/smc/src/hal/spi/SpiSlave.h

#pragma once

#include <stdint.h>

#include "hal/base/Component.h"
#include "hal/identity/DeviceId.h"
#include "hal/identity/DeviceName.h"
#include "utils/ring_queue.h"

namespace smc::hal::spi {
    namespace commands {
        inline constexpr uint8_t READ_DEVICE_ID = 0x01;
        inline constexpr uint8_t READ_DEVICE_TYPE = 0x02;
        inline constexpr uint8_t READ_EVENTS = 0x03;
        inline constexpr uint8_t ACK_EVENT = 0x04;
        inline constexpr uint8_t FLASH_IDENTIFICATION_LIGHTS = 0x05;
        inline constexpr uint8_t FLASH_BUTTON_IDENTIFICATION_LIGHT = 0x06;
        inline constexpr uint8_t READ_DEVICE_NAME = 0x07;
        inline constexpr uint8_t WRITE_DEVICE_NAME = 0x08;
    }

    // The longest argument of any command
    inline constexpr uint8_t MAX_ARGUMENT_LENGTH = identity::DEVICE_NAME_LENGTH;

    namespace ackStatus {
        inline constexpr uint8_t NOTHING_PENDING = 0x00;
        inline constexpr uint8_t REMOVED = 0x01;
    }

    // Generic responses, for commands that have no more specific response
    namespace responses {
        inline constexpr uint8_t ACCEPTED = 0x01;
    }

    /**
     * A command from the master that the slave can't complete from the SPI interrupt, and is instead
     * handed to the main loop through SpiSlave::dequeueCommand().
     */
    struct Command {
        uint8_t type = 0; // One of commands::*
        uint8_t arguments[MAX_ARGUMENT_LENGTH] = {}; // Only for commands that take arguments
    };

    using CommandQueue = utils::ring_queue<Command, 4>;

    /**
     * SPI0 slave on the alternate pins (SCK = PC0, MISO = PC1, MOSI = PC2, SS = PC3), mode 0, MSB first.
     *
     * A transaction (SS low to SS high) is one command byte from the master, followed by the
     * argument bytes for commands that take them (the slave sends FILLER_BYTE meanwhile), followed by
     * the response bytes the master reads, followed by a CRC-8 byte (see utils/crc8.h) calculated over
     * the command and argument bytes as received and the response bytes. Unknown commands respond with only the
     * CRC byte. Commands without a more specific response respond with a generic one (see responses).
     * Reading beyond the CRC returns FILLER_BYTE. MISO is only driven while SS is low.
     *
     *   READ_DEVICE_ID: [id0, ..., id7, crc], see hal/identity/DeviceId.h
     *   READ_EVENTS:    [type, data, crc] for the oldest event, or [NONE, 0, crc] when there are none.
     *                   The event is not removed, so reading again returns the same event.
     *   ACK_EVENT:      [status, crc]. Removes the event returned by the last READ_EVENTS (REMOVED),
     *                   or does nothing if it was already removed (NOTHING_PENDING), so it can be retried.
     *   FLASH_IDENTIFICATION_LIGHTS: [ACCEPTED, crc]. Queues the command for the main loop when the
     *                   transaction ends, see dequeueCommand(). Repeating it restarts the flash.
     *   FLASH_BUTTON_IDENTIFICATION_LIGHT: argument [button number], [ACCEPTED, crc]. Like
     *                   FLASH_IDENTIFICATION_LIGHTS, but only flashes the LED of the given button.
     *   READ_DEVICE_NAME: [name0, ..., name15, crc], null padded, see hal/identity/DeviceName.h
     *   WRITE_DEVICE_NAME: arguments [name0, ..., name15], null padded, [ACCEPTED, crc]. Queues the
     *                   command for the main loop, which stores the name and makes READ_DEVICE_NAME return it.
     *
     * ~INT (PC4, push-pull) is low while events are queued, and goes high when ACK_EVENT removes the
     * last one. The master can read and acknowledge events until INT goes high (or READ_EVENTS returns NONE).
     *
     * Timing: each byte is loaded by the interrupt that runs after the previous byte was
     * transferred, so the master must pause after every byte (including the command byte) for
     * the interrupt to complete. Code that disables interrupts (e.g. tinyNeoPixel::show())
     * delays this, and can corrupt a concurrent transaction, which the master detects through the CRC.
     */
    class SpiSlave : public Component {
    public:
        static constexpr uint8_t FILLER_BYTE = 0x00;

        SpiSlave() = default;
        ~SpiSlave() override = default;

        void setup() override;
        void update(uint32_t deltaUs, events::EventQueue& queue) override;

        void setDeviceId(const uint8_t (&deviceId)[identity::DEVICE_ID_LENGTH]);

        void setDeviceType(uint8_t deviceType);

        void setDeviceName(const uint8_t (&deviceName)[identity::DEVICE_NAME_LENGTH]);

        void enqueueEvent(const events::Event& event);

        /**
         * Copies the oldest queued command received from the master into command and removes it.
         * Returns false when there are none. When the queue is full, new commands overwrite the oldest.
         */
        bool dequeueCommand(Command& command);

    private:
        uint8_t deviceType = 0;
        // Dequeued from the SPI interrupt; only modify with interrupts disabled
        events::EventQueue eventQueue;
        // Enqueued from the SPI interrupt; only modify with interrupts disabled
        CommandQueue commandQueue;
    };
}
