TommyPersson/modular-keypads/firmware/main/src/mkp/firmwares/master/commands/AbortFirmwareUpdate.h

#pragma once

#include <tfw/utils/commands.h>

#include "mkp/components/firmware/FirmwareUpdater.h"

namespace mkp::firmwares::master::commands {
    class AbortFirmwareUpdate final : public tfw::utils::commands::CommandHandler {
    public:
        explicit AbortFirmwareUpdate(mkp::components::firmware::FirmwareUpdater& firmwareUpdater);
        ~AbortFirmwareUpdate() override;

        tfw::utils::void_result execute(
            const std::span<const std::string_view>& args,
            tfw::utils::commands::CommandResponseWriter& responseWriter,
            tfw::utils::allocations::Arena& arena
        ) override;

    private:
        mkp::components::firmware::FirmwareUpdater& firmwareUpdater;
    };
}
