TommyPersson/modular-keypads/firmware/main/src/mkp/firmwares/master/commands/All.h

#pragma once

#include "AbortFirmwareUpdate.h"
#include "BeginFirmwareUpdate.h"
#include "ClearKeyBinding.h"
#include "DeleteMacro.h"
#include "FinishFirmwareUpdate.h"
#include "FlashButtonIdentificationLight.h"
#include "FlashDeviceIdentificationLights.h"
#include "GetTestMode.h"
#include "ListConnectedDevices.h"
#include "ListDeviceCapabilities.h"
#include "ListKeyBindings.h"
#include "ListRegisters.h"
#include "ListRegisterValues.h"
#include "ListSettings.h"
#include "ListStoredMacros.h"
#include "Ping.h"
#include "ReadDeviceFirmwareVersion.h"
#include "ReadDeviceId.h"
#include "ReadDeviceName.h"
#include "ReadDeviceType.h"
#include "ReadMetrics.h"
#include "ReadRegister.h"
#include "ResetDevice.h"
#include "SaveMacro.h"
#include "SetDeviceName.h"
#include "SetKeyBinding.h"
#include "SetSetting.h"
#include "SetTestMode.h"
#include "WriteFirmwareUpdate.h"
