TommyPersson/modular-keypads/firmware/main/src/mkp/firmwares/master/commands/ClearKeyBinding.cpp

#include "ClearKeyBinding.h"

#include <tfw/utils/strings.h>

using namespace mkp::firmwares::master::commands;
using namespace mkp::components::keybindings;

ClearKeyBinding::ClearKeyBinding(
    KeyBindingStorage& keyBindingStorage
) : CommandHandler("clear.key.binding"),
    keyBindingStorage(keyBindingStorage) {}

ClearKeyBinding::~ClearKeyBinding() = default;

tfw::utils::void_result ClearKeyBinding::execute(
    const std::span<const std::string_view>& args,
    tfw::utils::commands::CommandResponseWriter& responseWriter,
    tfw::utils::allocations::Arena& arena
) {
    const auto type = tfw::utils::strings::atol(args[0], 16);
    const auto deviceId = tfw::utils::strings::atou64(args[1], 16);

    if (type == PUSH_BUTTON) {
        const auto number = tfw::utils::strings::atol(args[2], 16);

        const auto state = static_cast<tfw::hal::buttons::ButtonState>(tfw::utils::strings::atol(args[3], 16));

        const PushButtonTrigger trigger(deviceId, number, state);

        keyBindingStorage.remove(trigger);
    } else if (type == ROTARY_ENCODER) {
        const auto number = tfw::utils::strings::atol(args[2], 16);
        const auto direction = static_cast<tfw::hal::encoders::RotaryEncoderDirection>(tfw::utils::strings::atol(args[3], 16));

        const RotaryEncoderTrigger trigger(deviceId, number, direction);

        keyBindingStorage.remove(trigger);
    }

    return tfw::utils::void_result::success();
}
