TommyPersson/modular-keypads/firmware/smc/src/firmwares/Smc1Firmware.cpp

#include "Smc1Firmware.h"

#include <Arduino.h>

using namespace smc::firmwares;

Smc1Firmware::Smc1Firmware()
    : Firmware(4) {
}

Smc1Firmware::~Smc1Firmware() = default;

void Smc1Firmware::doSetup() {
    for (auto& button : buttons) {
        button.setup();
    }

    Serial.printf("SMC1 firmware setup complete!\r\n");
}

void Smc1Firmware::doUpdate(const uint32_t deltaUs, smc::events::EventQueue& queue) {
    for (auto& button : buttons) {
        button.update(deltaUs, queue);
    }
}

int8_t Smc1Firmware::ledIndexForButton(const uint8_t buttonNumber) {
    for (const auto& button : buttons) {
        if (button.getNumber() == buttonNumber) {
            return button.getLedIndex();
        }
    }

    return -1;
}
