TommyPersson/modular-keypads/firmware/main/src/mkp/components/notifications/NotifierFactory.h

#pragma once

#include <memory>
#include <Print.h>

#include "Notifier.h"

namespace mkp::components::notifications {
    class NotifierFactory {
    public:
        explicit NotifierFactory(Print& outputStream);
        ~NotifierFactory();

        std::unique_ptr<Notifier> create() const;
    private:
        Print& outputStream;
    };
}
