TommyPersson/modular-keypads/firmware/main/src/mkp/devices/a/DeviceFactoryA.h

#pragma once

#include "mkp/devices/common/DeviceFactory.h"

namespace mkp::devices::a {
    class DeviceFactoryA final : public common::DeviceFactory {
    public:
        ~DeviceFactoryA() override;
        bool matches(std::string_view deviceType) override;

        std::unique_ptr<common::LocalDevice> createLocal(
            common::DeviceConfiguration& config,
            firmwares::base::ServiceLocator& serviceLocator
        ) override;

        std::unique_ptr<common::RemoteDevice> createRemote(
            common::DeviceConfiguration& config,
            firmwares::base::ServiceLocator& serviceLocator
        ) override;
    };
}
