TommyPersson/modular-keypads/firmware/main/src/mkp/devices/common/DeviceTypeDetector.cpp

#include "DeviceTypeDetector.h"

using namespace mkp::devices::common;

DeviceTypeDetector::DeviceTypeDetector(tfw::hal::time::Clock& clock) {
    shiftRegister = std::make_unique<tfw::ic::L74165>(
        tfw::ic::Config{
            .pinQ = tfw::hal::gpio::InputPin::physical(18),
            .pinCLK = tfw::hal::gpio::OutputPin::physical(17),
            .pinCE = tfw::hal::gpio::OutputPin::physical(15),
            .pinLD = tfw::hal::gpio::OutputPin::physical(16),
        },
        clock
    );
}

void DeviceTypeDetector::setup() const {
    shiftRegister->setup();
}

char DeviceTypeDetector::detectDeviceType() const {
    shiftRegister->parallelLoad();
    const uint8_t typeCode = shiftRegister->read();

    switch (typeCode) {
    case 0x01: return 'a';
    case 0x03: return 'c';
    default: return 'g';
    }
}
