TommyPersson/modular-keypads/firmware/main/src/mkp/firmwares/master/commands/ClearKeyBinding.h

#pragma once

#include <tfw/utils/commands.h>

#include "mkp/components/keybindings/KeyBindingStorage.h"

namespace mkp::firmwares::master::commands {
    class ClearKeyBinding : public tfw::utils::commands::CommandHandler {
    public:
        explicit ClearKeyBinding(components::keybindings::KeyBindingStorage& keyBindingStorage);
        ~ClearKeyBinding() override;

        tfw::utils::void_result execute(
            const std::span<const std::string_view>& args,
            tfw::utils::commands::CommandResponseWriter& responseWriter,
            tfw::utils::allocations::Arena& arena
        ) override;

    private:
        components::keybindings::KeyBindingStorage& keyBindingStorage;
    };
}
