TommyPersson/modular-keypads/firmware/main/src/mkp/firmwares/master/commands/DeleteMacro.h

#pragma once

#include <tfw/utils/commands.h>
#include "mkp/components/macros/MacroStorage.h"

namespace mkp::firmwares::master::commands {
    class DeleteMacro : public tfw::utils::commands::CommandHandler {
    public:
        explicit DeleteMacro(mkp::components::macros::MacroStorage& macroStorage);
        ~DeleteMacro() override;

        tfw::utils::void_result execute(
            const std::span<const std::string_view>& args,
            tfw::utils::commands::CommandResponseWriter& responseWriter,
            tfw::utils::allocations::Arena& arena
        ) override;

    private:
        mkp::components::macros::MacroStorage& macroStorage;
    };
}
