TommyPersson/modular-keypads/firmware/main/src/mkp/firmwares/master/commands/FlashButtonIdentificationLight.cpp

#include "FlashButtonIdentificationLight.h"

#include <tfw/utils/strings.h>

using namespace mkp::firmwares::master::commands;

FlashButtonIdentificationLight::FlashButtonIdentificationLight(
    const std::vector<mkp::devices::common::Device*>& devices
) : CommandHandler("flash.button.identification.light"),
    devices(devices) {
}

FlashButtonIdentificationLight::~FlashButtonIdentificationLight() {
}

tfw::utils::void_result FlashButtonIdentificationLight::execute(
    const std::span<const std::string_view>& args,
    tfw::utils::commands::CommandResponseWriter& responseWriter,
    tfw::utils::allocations::Arena& arena
) {
    const auto deviceId = tfw::utils::strings::atou64(args[0], 16);
    const auto buttonNumber = tfw::utils::strings::atou8(args[1], 10);
    const auto durationMs = tfw::utils::strings::atou32(args[2], 10);

    for (const auto device : devices) {
        if (device->getConfiguration().id == deviceId) {
            device->flashButtonIdentificationLight(buttonNumber, durationMs);
            return tfw::utils::void_result::success();
        }
    }

    return tfw::utils::void_result::error("device.not.found");
}
