TommyPersson/modular-keypads/firmware/main/src/mkp/firmwares/master/commands/FlashButtonIdentificationLight.h

#pragma once

#include <tfw/utils/commands.h>

#include "mkp/devices/common/LocalDevice.h"

namespace mkp::firmwares::master::commands {
    class FlashButtonIdentificationLight final : public tfw::utils::commands::CommandHandler {
    public:
        explicit FlashButtonIdentificationLight(const std::vector<mkp::devices::common::Device*>& devices);
        ~FlashButtonIdentificationLight() override;

        tfw::utils::void_result execute(
            const std::span<const std::string_view>& args,
            tfw::utils::commands::CommandResponseWriter& responseWriter,
            tfw::utils::allocations::Arena& arena
        ) override;

    private:
        const std::vector<mkp::devices::common::Device*>& devices;
    };
}
