TommyPersson/modular-keypads/firmware/main/src/mkp/firmwares/master/commands/SetDeviceAddress.cpp

#include "SetDeviceAddress.h"

#include <tfw/utils/strings.h>
#include <tfw/hal/logging.h>

namespace {
    auto logger = tfw::hal::logging::createLogger("SetDeviceAddressCommandHandler");
}

using namespace mkp::firmwares::master::commands;

SetDeviceAddress::SetDeviceAddress(
    mkp::devices::common::DeviceConfigurationManager& deviceConfigurationManager
) : CommandHandler("set.device.address"),
    deviceConfigurationManager(deviceConfigurationManager) {
}

SetDeviceAddress::~SetDeviceAddress() = default;

tfw::utils::void_result SetDeviceAddress::execute(
    const std::span<const std::string_view>& args,
    tfw::utils::commands::CommandResponseWriter& responseWriter,
    tfw::utils::allocations::Arena& arena
) {
    const auto addressStr = args[0];

    const auto address = tfw::utils::strings::atol(addressStr, 16);

    if (!this->deviceConfigurationManager.setDeviceAddress(address)) {
        return tfw::utils::void_result::error("unable.to.set.device.address");
    }

    return tfw::utils::void_result::success();
}
