TommyPersson/modular-keypads/firmware/src/firmwares/SlaveFirmware.h

#pragma once

#include "Firmware.h"

class SlaveFirmware final : public Firmware {
public:
    explicit SlaveFirmware(ServiceLocator& serviceLocator);
    ~SlaveFirmware() override;

    void setup() override;
    void loop() override;

private:
    std::unique_ptr<devices::DeviceModule> device;

    i2c::SlavePort& slavePort;
};
