TommyPersson/modular-keypads/(commit log)

2025-09-15 Extract modular firmware
    [modular-key-pad.kicad_sch, module-a.kicad_pcb, module-a.kicad_sch]
2025-09-18 Add module-0 board
    [module-0.kicad_pcb, module-0.kicad_sch, module-a.kicad_pcb, module-a.kicad_sch]
2025-09-20 Add module-b (rotary encoders x3)
    [module-0.kicad_pcb, module-a.kicad_pcb, module-b.kicad_pcb, module-b.kicad_sch]
2025-09-21 3V net should not be shared across the bus
    [module-0.kicad_pcb, module-0.kicad_sch, module-a.kicad_pcb, module-a.kicad_sch, module-b.kicad_pcb, module-b.kicad_sch]
2025-09-28 More module scads
    [_variables.scad, lcd_spacer.scad, lcd_spacer.stl, module-0-bottom.scad, module-0-top.scad, module-0-top.stl, module-b-bottom.scad, module-b-top.scad]
2025-09-29 Implement basic device commanding structure
2025-10-10 Implement device configuration commands
2025-10-13 Add SwitchMonitor
2025-10-13 Add indicator leds
2025-10-14 MasterFirmware + SwitchStateNotifier + more event based switch updates
2025-10-15 Show device registers in config-tool
2025-10-17 First device preview card
2025-10-25 Make it possible to give a device a name
2025-10-26 Include deviceId in notifications
2025-12-07 Start on i2c comms
2025-12-07 Begin refactor to split device logic and device hardware
2025-12-07 Refactor register storage to make it easier to transfer between devices later
2025-12-13 Experiment with pipe-mounted base for modules
    [module-common-routines.scad, pipe-module-rack.scad]
2025-12-13 Create DeviceScanner and DeviceProxy
2025-12-14 More flexible pipe mount base
    [pipe-module-rack.scad]
2025-12-15 Refactor firmware construction
    [module-0.kicad_sch, module-a.kicad_sch]
2025-12-15 Lower the i2c packet size to stay below the available buffer
2025-12-16 Use correct notifier ID for each runtime
    [DeviceConfigurationManager.cpp, DeviceModuleA.h, Firmware.cpp, Firmware.h, Notifier.cpp, Notifier.h, NotifierFactory.cpp, NotifierFactory.h]
2025-12-16 Fix rotary encoder click crashing
2025-12-22 Add device capabilities
2025-12-26 Placeholder implementations for macro editing commands
    [partitions.csv]
2025-12-30 Implement stubbed key binding storage in firmware
    [KeyBinding.h, KeyBindingStorage.cpp, KeyBindingStorage.h, MasterFirmware.cpp]
2025-12-30 Implement key binding storage
    [KeyBindingStorage.cpp, MasterFirmware.cpp]
2025-12-30 Implement full chain for push button key bindings
    [KeyBindingStorage.cpp, KeyBindingStorage.h, KeyBindingSubSystem.cpp, MasterFirmware.cpp, MasterFirmware.h]
2025-12-30 Implement rotary encoder key bindings fully
    [KeyBindingSubSystem.cpp, MasterFirmware.cpp, MasterFirmware.h]
2025-12-31 Add DeviceComand interface to allow shrinking the DeviceFacade
2025-12-31 Move most DeviceFacade methods to individual DeviceCommand implementations
2026-01-01 Add MacroTypeDefinition to get various switch-cases in frontend
2026-01-01 Improve error handling for device commands
    [GetTestMode.cpp, GetTestMode.h, ListConnectedDevices.cpp, ListConnectedDevices.h, ListDeviceCapabilities.cpp, ListDeviceCapabilities.h, SetTestMode.cpp, SetTestMode.h]
2026-01-02 Move frameworky stuff to utils/ instead of firmwares/common
2026-01-02 Move frameworky stuff to utils/ instead of firmwares/common #2
2026-01-02 Avoid heap allocation in LineStreamer
    [LineStreamer.cpp]
2026-01-02 Avoid heap allocations during read macros flow
2026-01-02 Avoid allocations during read key-bindings flow
    [KeyBindingStorage.cpp, KeyBindingSubSystem.cpp]
2026-01-03 Move i2c package to utils
2026-01-03 Move device endpoint definitions out of utils
2026-01-03 Simplify usage of i2c Client
2026-01-03 Add timer metric for device looper. increase i2c speed and lower the number of requested device registers
2026-01-04 Create simple jig to hold side connectors in place while soldering
    [module-bottom-routines.scad, module-top-standin.scad, shared-utils.scad, side-connector-jig.scad]
2026-01-05 Implement infra for generic i2c command handling
2026-01-06 Create a simple pulsing animation for device identification
2026-01-06 Rename i2c commands to "RemoteCommand[...]" to distinguish them
2026-01-06 Move local/remote logic to DeviceModule base class
2026-01-06 Implement remote device renaming
2026-01-08 Add individual button identification command
2026-01-09 Create new pipe mount models
    [mount-leg-2.scad, pipe-module-rack-2.scad, shared-variables.scad]
2026-01-10 Don't show buttons without LEDs as flashable
2026-01-24 New pcbs, seperated out a compute/io board
    [3v3-regulator.kicad_sch, compute-board.kicad_pcb, compute-board.kicad_sch, modular-key-pad.kicad_sch, module-a2.kicad_pcb, module-a2.kicad_sch, power-distribution.kicad_sch, switches.kicad_sch]
2026-01-24 scad for connector placing jig
    [stacking-connector-jig.scad]
2026-03-01 New pcbs
    [3v3-regulator.kicad_sch, compute-board-2.kicad_pcb, compute-board-2.kicad_sch, compute-board-3.kicad_pcb, compute-board-3.kicad_sch, compute-board.kicad_pcb, modular-key-pad.kicad_sch, module-a3.kicad_pcb]
2026-03-02 Adapt to new pcb
2026-03-02 Add a simple keycap design
    [key-caps.scad]
2026-05-02 Add scad models
    [toner-transfer-jig.scad, x3.scad]
2026-05-02 Degeneralize SPI serialbus
2026-05-02 Adjust spi namespace
2026-05-09 Move SwitchMonitor to tfw::hal, change to Button terminology inside library
2026-07-04 e-paper driver pcb
    [epaper-driver.kicad_pcb, epaper-driver.kicad_sch]
2026-07-04 Add scad model for module top cover
    [module-a-top-cover.scad, module-top-routines.scad, shared-variables.scad]
2026-07-04 Update module a4
    [module-a4.kicad_pcb]
2026-07-04 Always scan entire I2C range
2026-07-05 Add pcb for e module
    [epaper-driver.kicad_pcb, modular-key-pad.kicad_sch, module-e1.kicad_pcb, module-e1.kicad_sch, power-distribution.kicad_sch, switches.kicad_sch, usb-c-connector.kicad_sch]
2026-07-11 Experiment with ring encoder shells
    [encoder-cover.scad, encoder-stem.scad, module-a-top-cover.scad, module-b-top.stl, shared-variables.scad]
2026-07-26 Add c-module pcbs
    [bom.csv, connector-board.kicad_pcb, connector-board.kicad_sch, designators.csv, modular-key-pad.kicad_sch, module-c-bottom.scad, module-c-connector-board-rev-1_bom.csv, module-c-connector-board-rev-1_designators.csv]
2026-07-26 Reorg pcb directory structure
    [compute-board.kicad_pcb, modular-key-pad.kicad_sch, module-a.kicad_pcb, module-a.kicad_sch, module-a2.kicad_pcb, module-a2.kicad_sch, module-a3.kicad_pcb, module-a3.kicad_sch]
2026-07-26 Remove obsolete pcbs
    [3v3-regulator.kicad_sch, compute-board-2.kicad_pcb, compute-board-2.kicad_sch, compute-board-3.kicad_pcb, compute-board-3.kicad_sch, compute-board.kicad_pcb, compute-board.kicad_sch, modular-key-pad.kicad_sch]
2026-07-26 Move device debugging tools to a tool pane bar
2026-07-26 Fix device logs toll pane
2026-07-27 Poll events from remote devices instead of relying on fetching their remote state.
2026-07-28 Start on clearer separation between local and remote devices
2026-07-28 Remove i2c client from local-only modules
2026-07-28 Remove legacy module 'm'. Combine DeviceRuntimeA and DeviceModuleA into LocalDeviceA
2026-07-29 Make slave event fetching async using interrupts
2026-07-30 Include device ID in commands to be able to handle upcoming sub-device addressing
2026-08-21 Update pcb revisions
    [connector-board.kicad_pcb, connector-board.kicad_sch, module-c-mockups.scad, sub-module-programmer.kicad_pcb, sub-module-programmer.kicad_sch]
2026-08-22 Messing around with Claude to find and resolve i2c issues.
2026-08-22 Also address fixable warnings
    [KeyBindingStorage.cpp, ListKeyBindings.cpp, LocalDevice.cpp, Notifier.cpp, RemoteDevice.cpp, SlaveFirmware.cpp, main.cpp]
2026-08-23 Use new Clock in metrics. Fix ring_queue size bugs while adding metric tests.
    [main.cpp]
2026-08-23 Revert std::format use to avoid binary bloat
    [ReadDeviceAddress.cpp]
2026-09-06 Programmer PCB rev 3
    [sub-module-programmer.kicad_pcb, sub-module-programmer.kicad_sch]
2026-09-12 Create subdirectory for main firmware binary
    [partitions.csv]
2026-09-13 Update SMC PCBs with additional pull-ups, RC circuits and paste adjustments
    [smc-1.kicad_pcb, smc-1.kicad_sch, smc-2.kicad_pcb, smc-2.kicad_sch, smc-3.kicad_pcb, smc-3.kicad_sch, smc-4.kicad_pcb, smc-4.kicad_sch]
2026-09-27 Create shell for programming pcb
    [smc-programmer.scad]
2026-10-04 Sub Device scanning progress
2026-10-08 Make subdevices scannable when the master is the C device.
2026-10-08 Use correct i2c address and parent ID for connected devices
2026-10-08 Switch the device type to a string to accommodate longer type names for the submodules.
2026-10-08 Implement the device identification flash for sub devices
2026-10-08 Implement proper notification from the sub devices.
2026-10-08 Implement individual button identification
2026-10-08 Implement naming of SMC devices
2026-10-09 Forward sub-device connected events from slave
2026-10-09 Make the master able to read sub device information from slaves
2026-10-09 Sub-device rename events are now forwarded from slaves to the master to the config ui
2026-10-09 Pass events for renames of non-sub devices also
2026-10-09 Move i2c command processing outside of the i2c callback
2026-10-09 Top-level devices are now discovered and disconnected automatically
2026-10-10 Add CountDown timer to simplify discovery pin monitoring
2026-10-10 Propagate sub device slot numbers to UI and use it to sort preview cards
2026-10-10 Show previews of all connected devices on the overview page
2026-10-10 Add structure for editing device settings, including typing speed
2026-10-10 Add stories for the device cards
2026-10-10 Add DevicePreviewList
2026-10-10 More uniform device previews
2026-10-10 Add device card connect/disconnect/reorder animations
2026-10-10 Show bindings in device preview card
2026-10-10 Show bindings on rotary encoder module as well.
2026-10-10 Add button identification action to key binding modal
2026-10-11 Implement dynamic address resolution of devices
2026-10-11 Show the device serial traffic logs as a toolpane instead. Fix device log message ordering
2026-10-11 Remove the device debugger page
2026-10-11 Hide tool pane selector when no device is connected.
2026-10-11 Macro filtering and layout adjustments
2026-10-11 Better macro filter
2026-10-11 Only show device preview card actions on hover
2026-10-11 Make it possible to create and assign a new macro directly from the switch config modal
2026-10-21 Do a full device reset if discovery timeout passes
2026-10-21 Mainboard pcb rev2 wip
2026-10-22 Allow the UI to select on physical button presses during test mode
2026-10-24 Fix click on dropdowns causing deselection of current switch
2026-10-25 Add master comms watchdog to slave devices
2026-10-25 Adjust encoder module scad
2026-11-07 Improve firmware mode detection by checking actual USB connection, instead of just the VBUS_SENSE pin
2026-11-07 Work on C-rev-2 board
2026-11-07 Initial "mouse" wheel scad design
